jhlr/robo-challenge/docs/2026-11-06_ombro-sts3215.md

# Ombro com STS3215 direto, estrutura MDF (2026-11-06)

Sem reducao: o STS3215 (19,5 kg.cm) liga direto no pivo da barra de baixo do lado -x. Substitui MG996R + 4:1 (arquivado em `old/ombro_mg996r_4x1/`). Fontes: `cad/braco/sts3215.scad` (medidas), `ombro_sts.scad` (posicao do servo), `braco_mdf.scad` (pecas MDF).

## Estrutura (mais firme que a chapa unica antiga)
1. Corpo do servo (45,22 x 24,72 x 35) deitado: eixo em x, comprimento ao longo de y (de -35,11 a +10,11), largura em z. Fica fora das barras.
2. 2 quadros iguais (`stsframe`, YZ) com janela fechada no corpo: um rente a face do disco, outro rente a face de tras. O servo entra por tras pelas duas janelas e fica preso nos dois pontos (antes: 1 chapa de 2,3 mm).
3. 1 tampo (`stsshelf`, XY) une os 2 quadros por cima; as pontas passam por rasgos fechados. Quadro + quadro + tampo + prato formam um anel rigido.
4. Cada quadro tem 2 pes (12 mm, a ~41 mm um do outro) em janelas fechadas do prato. Prato estendido para tras em todo o x (de -53 a 20, ate y = -60); os 6 furos M3 do convés nao mudaram.
5. Barra do ombro (`bar_sts`): pivo alargado (22 mm), furo central de 8 mm (cabeca do parafuso do eixo), 4 furos M3 no circulo de 14 mm. As outras 3 barras sao as normais; sem furos de pino de setor.

## Verificado (OpenSCAD, poses pick/mid/place)
1. Barras x quadros/servo/tampo: sem interferencia.
2. Servo + quadros + tampo x chassi: so contato plano em z = 68 (pes no prato), sem colisao.
3. Encaixe real no disco NAO testado (medidas do disco vem da medida do usuario + desenho Waveshare).

## Reforco das torres e parafusos (2026-11-06, depois do primeiro desenho)
1. Torre com base alargada (trapezio de +-20 mm no prato ate +-12 mm a 30 mm de altura) e 3 pes no prato (antes 1).
2. Tampo das torres (`towertop`): liga as duas no topo, pontas em rasgos fechados, 1,5 mm abaixo do topo (acima do parafuso do pivo de cima).
3. Escora (`stsbrace`, XZ, y = -15,5): uma chapa de 41 mm que passa por rasgos fechados no quadro de tras, no quadro da frente e na torre -x, por baixo do servo. Amarra servo e torre.
4. Parafusos, posicoes escolhidas:
   - Conves (furar o conves do carro; hoje 6 furos M3, agora 9): +3 em (-50,5; -56), (-16,5; -19) e (-16,5; 19). Os de x = -16,5 ficam ao lado do pe da torre -x e da fileira de tras.
   - 2 furos M3 em cada quadro do servo (y = -39,1 e 14,1, z = eixo): espacador M3 femea-femea de 30 mm entre os quadros, parafuso M3 x 6 de cada lado. Fecha o servo num caixote rigido. Ficam do lado de fora, longe das barras.
   - Barra no disco: 4 M3 fresados (como antes).
   - Nao coloquei parafuso passante entre as torres: as cabecas/porcas ficariam na faixa de giro das barras (|x| = 13,9 a 16,2).
   - Furos nas abas do MDF nao seguram (aba rente, 2,3 mm); por isso os parafusos so atravessam placas inteiras.
5. Verificado: barras x (prato, torres, quadros, servo, escora, tampo): so contato plano barra-disco (x = -16,15). Conjunto x chassi: so contato plano do prato em z = 68 (pose pick; a pose place nao terminou, mesma geometria nos outros).

## Servo dentro da torre (2026-11-06, terceira rodada)
A torre -x e o quadro da frente do servo viram UMA placa (`towerframe`): janela fechada no corpo do STS3215 + sobe ate o furo do pivo de cima (so o pivo de cima; o de baixo e o proprio servo). Sai a escora de torre separada: `stsframe` (quadro de tras) fica x1.
1. Ordem em x agora, no lado -x: corpo do servo atravessa a placa-torre, disco (1,1 mm), barra, ... torre +x, barra +x.
2. Fundo (`back`) vai ate a placa-torre, com recorte onde passa o pivo alargado da barra (so ficam as faixas abaixo e acima dele); abas em z = 72,3-79,3 e 114,3-123,3.
3. Tampo das torres (`towertop`) desceu para z = 125,5: a barra de cima passa a 129,2 mm (alpha = -16, y = 9), mais alto que isso batia na pose place. Tampo do servo (`stsshelf`) liga placa-torre e quadro de tras.
4. Escora baixa passa por rasgos nos 3 (quadro de tras, placa-torre, torre +x).
5. Verificado: barras x estrutura nas 3 poses, so contato plano barra-disco. Conjunto x chassi: ver commit.

## Encaixe servo-barra (visualizacao)
Cena `view_encaixe` (`-D expl=18` afasta a barra): barra real do ombro (2D com furos) sobre o disco, 4 M3 fresados x 5 mm no circulo de 14 e furo central de 8 mm para a cabeca do parafuso do eixo. M3 x 5 = 2,3 de MDF + ~2,7 dentro do disco: so serve se a rosca do disco tiver pelo menos 2,7 mm. MEDIR a profundidade da rosca antes de comprar os parafusos.

## Pendencias (medir / decidir)
1. Parafusos da barra no disco: M3 FRESADOS (cabeca chata), 8 mm. A barra fica a 0,7 mm da torre, cabeca redonda nao cabe. O fresamento (cone) nao sai no corte a laser: fazer a mao. Profundidade da rosca no disco: medir antes de escolher o comprimento.
2. Saliencia do disco sobre a face (`sts_disc_prot` = 1,125, do desenho): medir. Muda o x do servo.
3. Cabeca do parafuso do eixo (`sts_center_d` = 8): medir.
4. Servo nao tem trava axial propria: segurado pela barra (parafusada no disco, barra presa nas torres). Se quiser trava, 2 parafusos M2 nos furos do corpo (padrao nao mapeado).
5. Firmware: `shoulder_ratio` = 4 em `params.json` e o PWM do ombro (`firmware/src/hal/shoulder.cpp`) ainda assumem o servo antigo; STS3215 e servo de barramento. Nao mexido.
6. Chapa do ombro regenerada (`mdf/sheet_ombro_1.*`, 1 chapa, 33% ocupada); o DXF do `bar_sts` esta em `mdf/parts/bar_sts.dxf`.
