jhlr/robo-challenge/docs/2026-11-06_sts3215-disco.md

# STS3215: disco de metal (horn) para a engrenagem da garra

Fonte: desenho 2D oficial da Waveshare (ST3215-2D.zip, `ST3215.dxf`/`.pdf`; https://www.waveshare.com/wiki/ST3215_Servo). Valores lidos do DXF; nao medidos no disco fisico.

1. Disco: 19,2 mm no desenho; MEDIDO no real (2026-11-06): 20 mm.
2. 4 furos em cruz, circulo de 14 mm (centro a furo 7 mm, medido, igual ao desenho); furo MEDIDO 3 mm (desenho: 2,5).
3. Furo central 3,2 mm (parafuso M3 do eixo); cubo/estria 25T, diametro do eixo ~5,9 mm.
4. Corpo do servo: 45,22 x 24,72 mm, altura 35 mm; eixo a 18,41 mm de uma ponta, 10,11 mm do lado maior.
5. Pendente (medir com paquimetro): espessura do disco e altura do cubo acima do corpo (desenho sugere ~2 mm, nao cotado).

Reuso: mesmo conceito do pinhao do ombro (`old/ombro_sg90_berco/ombro_reducao.scad`): flange atras dos dentes encostada no disco + pinos nos furos + parafuso central. Aqui: 4 pinos de ~2,3 mm no circulo de 14 mm.
