jhlr/robo-challenge/docs/2026-10-29_simulador-lote.md

# Simulador em lote (multiplas sementes) — 2026-10-29

Uma partida so do simulador e caotica: uma mudanca boa pode piorar a partida que estava sendo olhada. Para medir, `--lote N` roda a missao so com o nosso robo em N sorteios
(cubos e ruido mudam com a semente) e `--lote-ruido N` o mesmo com o ruido aleatorio ligado.

```
cd firmware/SeguidorRC
g++ -std=c++17 -O2 -Isrc -I../src -pthread test/simulador.cpp src/seguidor/decisao.cpp -o /tmp/sim
/tmp/sim --lote 12            # sem ruido; SIM_SO=4 roda so a semente 4 (use com SIM_DEBUG=1 para ver os eventos)
/tmp/sim --lote-ruido 12
```

Cada linha: se chegou a meta (2 entregas), entregas, pontos, toques em cubos (regras: -5 cada) e tempo. O resumo traz a media.

## Medidas (12 sementes, sem ruido, `--lote 12`)
| momento | chegam a meta | toques em cubos / partida | tempo medio |
|---|---|---|---|
| antes de corrigir a entrada na cidade depois da entrega | 2 de 12 | 1,6 | 529 s |
| compensando a partida em deslocamentos curtos | 6 de 12 | 1,9 | 415 s |
| cubo perto do cruzamento: depois da meia-volta replaneja no cruzamento | 7 de 12 | 0,7 | 387 s |
| atravessa a faixa azul em frente ate achar a rua | 8 de 12 | 1,0 | 332 s |
| olhar adiante so para o lado da linha (nao para o quarteirao) | 8 de 12 | 0,8 | 321 s |

Com ruido aleatorio (`--lote-ruido 12`, ruido propositalmente alto): 0 de 12.

## O que ainda falha (sem ruido)
- 4 de 12 sementes terminam com 1 entrega em 601 s (presas depois da 1a entrega ou ancorando).
- Ancorar com a linha desconhecida assume a linha 0; a correcao do nucleo (`core::planAtCrossing` vai a outra moldura quando a rua esta bloqueada) ainda nao e usada pela
  logica propria de ANCORAR do simulador (`Navegador::aoCruzamento`). Virar o sentido ali simplesmente piorou, entao nao foi aplicado.

## Atualizacao 2026-10-29 (tarde): mapa de rua de 40 cm e varredura parada das plataformas

- Mapa: passo 400 mm, becos 168 mm, ecoponto 291 mm, verde 371 mm (becos/ecoponto/verde: medidas da imagem na escala 400/302; so o passo veio de medida do usuario). Lote de 12 sementes sem ruido: 12 de 12 na meta, 259 s.
- Plataformas: o carro vai ao meio do mapa, chega a ~170 mm da face e varre -36..+36 graus com o ultrassom (Pitagoras: face = alcance x cos; centro de cada trecho com eco = distancia x tan do meio do trecho). A 250 mm o cone (+-10) fechava o vao de 100 mm. So a primeira entrega sobe ao topo (unica medida de velocidade em reta com distancia conhecida).
- Cubos: memoria do eco (um eco perto que some por causa do balanco do carro vale como "eco menos o que andou"; se o carro esta torto, realinha com a rua e le de novo). Toques em cubos: 2,0 -> 0,2 por partida.
- Varredura nos cruzamentos: com pose segura e cruzamento esperado, so gira para o lado cuja rua ainda nao foi medida (as duas medidas: nao gira; so uma: gira uma vez). 30 sementes: 25/30 na meta nos dois casos, 283 s contra 288 s.
- Falhas que restam (~5 em 30): o carro carregando fica preso num falso alarme no mesmo ponto (ex. semente 11, (1474, 230)); nao investigado.

## Rodada de otimizacao (30 sementes sem ruido)

| Mudanca | Na meta | Tempo medio |
|---|---|---|
| Antes (varredura so da rua nao medida) | 25/30 | 283 s |
| Rua bloqueada = a que o carro vai usar de fato (antes marcava sempre a do oeste); rota pelas ruas livres ate a coluna 0 | 26/30 | 277 s |
| ANCORAR com cubos nos dois sentidos da coluna: anda uma coluna ao leste | 27/30 | 266 s |
| Volta ao portao com a linha conhecida: `core::onOwnBlueAtRow` (pose segura logo na entrada, sem sweeps nem ANCORAR) | 27/30 | **207 s** |

Tentado e DESFEITO: (a) marcar toda plataforma lida como olhada (`yOlhados`): 23/30; (b) corrigir o rumo do giroscopio pelo plano da face das plataformas (ajuste do delta por minimos quadrados, fases 1 e 2): o delta sai certo (-22 contra -27 verdadeiro) mas o erro volta a crescer depois (vies do giroscopio + curvas fora das linhas), nao fechou o lote com ruido (0/12) e piorou o lote limpo (26/30). Com ruido o problema e ancorar o rumo ENQUANTO ha so parede (ecoponto e verde), sem linha para corrigir.
Falhas que restam (3/30): carro perde a linha ao reentrar pelo portao 40 mm abaixo da rua (deslocamento por tempo) e fica na faixa azul.

## Reentrada pelo portao (30 sementes sem ruido)

Causa das falhas: o carro voltava do ecoponto ~40 mm abaixo da rua (fora da barra de 75 mm), e a busca seguia a faixa azul como se fosse rua. A origem era a compensacao de partida da entrada (`entrarNaCidade`): 40 mm, medida com o mapa de 302 mm; com o y da plataforma ja na grade ela passava do ponto.

| Compensacao | Na meta (30) | Na meta (60) | Tempo medio (30) |
|---|---|---|---|
| 40 mm (antes) | 27/30 | 54/60 | 207 s |
| 20 mm (agora) | **29/30** | 57/60 | **174 s** |
| 0 mm | 29/30 | 57/60 | 175 s |

Tentado e desfeito: so contar como rua o preto que aparece 300 ms depois de o TCS deixar de ver azul (a faixa tambem acende a barra): 26/30. Falha que resta: semente 17 (carro termina fora do mapa, pose perdida; nao investigado). Lote com ruido continua em 0/12.

## Modo ruido pela metade (`kEscalaRuido = 0.5`, 30 sementes)

Dono unico da intensidade: `kEscalaRuido` em `test/simulador.cpp` (1,0 = original). Metade da frequencia (intervalos x2), da duracao e do desvio de cada evento (assimetria fixa 1,5 a 5%, patinagem, motor fraco, bateria, vies do giroscopio, solavanco, atraso e sensor preso, eco do ultrassom, erro do TCS). Sem ruido: 29/30, 174 s (inalterado).

Resultado com ruido: **0/30 na meta**. Isolando cada fonte (`SIM_SEM_RUIDO=<mascara de bits 0..9>`, `SIM_SEM_ASSIM=1`):

| Configuracao | Na meta | Tempo medio |
|---|---|---|
| Ruido pela metade (tudo) | 0/30 | 602 s |
| Tudo menos a ASSIMETRIA FIXA dos motores | **18/30** | 349 s |
| So a assimetria fixa (resto desligado) | 0/30 | 603 s |
| Sem qualquer uma das outras 9 fontes (uma por vez) | 0/30 | 601 s |

Conclusao: a unica fonte que derruba o carro e a assimetria fixa dos motores (diferenca de 1,5 a 5% entre os lados), e sozinha ja basta. Sinal no log: o rumo real fica 14 a 37 graus fora do rumo do giroscopio dentro do ecoponto (LOOK th 166, 158, 151 em vez de 180). Na pista, com linha, ele corrige; fora dela (verde e ecoponto) nao. Motores TT amarelos reais costumam diferir 5 a 10%, entao e o ponto a medir no carro.

## Assimetria dos motores: o giroscopio mede, o lado fraco ganha forca (30 sementes)

`seguidor/assimetria.h` (pura): no verde, parado, 3 rodadas curtas (~150 mm) alternando re e frente com o MESMO PWM nos dois lados. O giroscopio da o giro w em reta e, como w = (vD - vE)/bitola, a razao das forcas sai de vD/vE = (v + w*b/2)/(v - w*b/2); a compensacao SOBE o lado fraco (o forte fica em 1). As rodadas seguintes partem do ganho da anterior e fecham o que a derrapagem das rodas "comeu". `ponte_h` ganhou `definirCompensacao` (ganho por lado, limitado a 255); no simulador e `Carro::compensar`. O exemplo `SeguidorBasico` chama no setup (`kCompensarAssimetria`).

| Modo | Na meta (30) | Tempo medio |
|---|---|---|
| Sem ruido, antes | 29/30 | 174 s |
| Sem ruido, com a calibracao | 28/30 | 187 s |
| Ruido pela metade, antes | 0/30 | 602 s |
| Ruido pela metade, com a calibracao | **19/30** | 331 s |

Guarda: `cenarioAssimetria` (+4% e -7%): desvio de rumo numa reta de 2 s cai de 6,1 / -10,6 graus para 0,6 / 0,1; ganho do lado fraco x1,044 (real x1,041) e x1,076 (real x1,073). Visto VERMELHO: sem a calibracao os 2 casos falham (59/61).

Tentado e REMOVIDO (barra de 8 sensores): integrador lento no erro medio da linha em retas (linha a direita do centro = o carro vai para a esquerda = sobe a esquerda). Com ki alto (4e-5/ms) derrubou o lote limpo (5/30); com ki baixo (1e-6/ms) ficou igual a sem trim; sozinho, com ruido, 0/30: o desvio acontece fora da linha (verde e ecoponto), onde a barra nao ve nada, e a convergencia leva um minuto de reta. A barra serve para VERIFICAR a compensacao, nao para descobri-la: fica como ideia (medir o erro medio da linha na 1a rua e avisar se sobrou > 1 sensor).
