jhlr/robo-challenge/docs/2026-10-22_ombro-mg996r.md

> **DESCARTADO em 2026-10-22 (mesmo dia):** o usuario concluiu que o TowerPro nao aguenta direto no pivo; voltamos ao SG90/MG90S com reducao 4:1. Arquivos do MG996R em `old/ombro_mg996r_direto/`.

# Ombro com MG996R direto no pivo (2026-10-22)

Substitui o ombro SG90 4:1 de `2026-10-20_braco-opcao2.md` (item 1 das decisoes). Pedido do usuario: servo do ombro passa a ser um TowerPro MG996R.

## O que mudou
- Sem reducao: o horn do MG996R vai aparafusado na face de fora da barra de baixo do lado -x (M2,5 a 8 e 16 mm do pivo, 4 barras iguais), M3 do eixo entra por dentro pelo furo de pivo. Fonte: `cad/braco/ombro_direto.scad` (substitui `ombro_reducao.scad`, movido para a lixeira junto com `part_sr_*.stl`).
- Torque: ~10 kg.cm (6 V) contra 4,2 necessarios = 2,4x de folga.
- MDF: prato volta a 73 x 44 mm (sem a extensao para tras), some bochechas e prateleira, entra a chapa do servo `d_servoplate` (YZ, janela fechada 41,3 x 20,3 para o corpo, 4 furos M4 das orelhas, 2 abas em janelas fechadas do prato). Folha: `cad/braco/mdf/sheet_ombro_1.dxf` (prato, chapa do servo, 4 barras).
- Firmware: `kShoulderRatio 1`, sinal +1, centro 90 graus; angulos do braco -16 / -9,8 / +25,5 = servo 74 / 80 / 115,5 graus. Sinal +1 e suposicao (flip se o braco andar ao contrario).

## Verificado no 3D (`chk_sh_*` em `braco_mdf.scad`)
- Sem colisao com o chassi (`chk_sh_chassis`); conjunto inteiro so toca o convés em z = 68 (face do prato).
- Chapa x orelhas: so contato plano; servo x barras/carrier: so 0,05 mm de contato horn-barra (dummy da barra tem 3 mm, MDF tem 2,3).

## Pendencias / riscos
1. Medidas do MG996R sao de catalogo, MEDIR: altura total 42,9, eixo a 10,3 mm da ponta, orelhas a 14 mm abaixo do topo do eixo, furos 49,5 x 10 mm, furos do horn de 2 bracos (`sh_horn_y`).
2. O corpo sai ate x = -62,4, ~15 mm alem da lateral do chassi (-47): conferir contra a regra de 300 x 300 mm e contra as rodas.
3. Chapa do servo em pe so nas 2 abas do prato: pode balancar; se sim, colar ou adicionar escora.
4. Alimentar o MG996R por fonte propria de 5-6 V (stall ~2,5 A), GND comum com o ESP32.

---
## Atualizacao (mesmo dia): ombro 4:1 com pinhao parafusado no horn redondo
O usuario tem o horn redondo de 20 mm do servo (disco com coroa de furinhos). O pinhao deixa de ter bolso estriado: ganha flange de 22 mm x 2 que encosta no horn, 3 pinos impressos de 1,1 mm entram na coroa (a cada 4 furos, supondo 12) e o M2 do eixo prende. Fonte: `cad/braco/ombro_reducao.scad` (`sr_horn_*`, `sr_hz_*`, `sr_peg_*`, `sr_fl_*`), STL `cad/braco/stl/part_sr_pinion.stl` refeito (reimprimir).
- Servo recuou 4,5 mm em x (flange + horn entre ele e as engrenagens): `sr_sv_top` = -25,15. Berco de MDF refeito: `m_cx` = [-48,5; -25,6], abas em [-47,5; -40] e [-34; -27]; a prateleira acaba antes do horn (o disco de 20 mm passaria por dentro dela). `sheet_ombro_1.dxf` regerado (cortar de novo prato, bochechas, prateleira).
- Checagens `chk_sr_*` (alpha -16 e +25,5): sem colisao com chassi e carrier; mount e conjunto so contato plano.
- MEDIR no horn: espessura total, numero de furos da coroa, raio e diametro dos furos, altura do cubo central (valores atuais vem de foto, +-0,5 mm).

### Medidas finais do horn (2026-10-22, usuario)
Disco 20 x 2 mm, cubo central de 3 mm virado para o SERVO (total 5 mm, face do disco virada para o pinhao e plana), Ø do cubo 8 mm (aprovado), 4 furos a 8 mm do centro, a 90 graus, usados com 4 pinos impressos de 1,1 mm; os furos de 7 mm e os demais ficam sem uso. Servo recuado: `sr_sv_top` = -27,15; berco: `m_cx` = [-48,5; -27,55], abas [-47,5; -40] e [-37; -30]. `chk_sr_*` limpos; `part_sr_pinion.stl` e `sheet_ombro_1.dxf` regerados. Pendente: diametro real dos 4 furos do horn (pino de 1,1 mm).
