jhlr/robo-challenge/docs/2026-10-26_base-mg996r-4x1.md

# Base do ombro com MG996R + reducao 4:1 (2026-10-26)

Pedido: servo do ombro passa a ser o TowerPro MG996R (foto do usuario: chapa de MDF vertical, corpo do servo atras dela, horn redondo + pinhao impresso do lado do braco, engrazando no setor da barra). Substitui o berco do SG90 (prato + bochechas + prateleira); o que existia fica em `old/ombro_sg90_berco/`.

## O que mudou (fonte unica: `cad/braco/ombro_reducao.scad` e `cad/braco/braco_mdf.scad`)
- `ombro_reducao.scad`: parametros do servo agora sao do MG996R (`sr_sv_*`, `sr_ear_*`); a relacao 4:1 (z12/z48, m1,25, distancia entre eixos 37,5 mm) nao mudou.
- `braco_mdf.scad`: some `d_cheek`/`d_shelf`; entra `d_servoplate` (chapa YZ logo atras das orelhas, janela fechada 41,3 x 20,3 para o corpo, 4 furos M4 das orelhas, 2 abas em janelas fechadas do prato). `d_base` ganha a extensao para tras (`m_bext`) e as 2 janelas das abas, em x = `m_sp`. Grupo `ombro` do `mdf_nest.py` = prato + chapa + 4 barras (`cad/braco/mdf/sheet_ombro_1.dxf`, copia em `~/Desktop/corte_mdf/`).
- Arrumacao das aberturas do prato (desenho do usuario): torres (2 longas) + fundo (2 curtas) como antes; as 2 abas da chapa do servo ficam atras da torre, no eixo y do servo.
- Imagens: `docs/2026-10-26_base-mg996r-4x1.png` (folha), `docs/2026-10-26_ombro-mg996r-4x1_3d.png` (3D).

## Verificado
- DXF: contornos fechados, 0 pontos abertos (838 linhas).
- 3D: `chk_sr_chassis` vazio (sem colisao com o chassi); `chk_sr_mount` so contato plano (volume 0, face das orelhas x = -39,15).

## Pendencias / riscos
1. Medidas do MG996R sao de catalogo: MEDIR corpo (40,7 x 19,7), eixo a 10,3 mm da ponta, orelhas a 14 mm da ponta do eixo, eixo ~4,5 mm acima da tampa (`sr_sv_spl`, suposto), furos 49,5 x 10 mm.
2. O corpo (~38 mm de altura sem eixo) sai ate x ~ -65 mm do centro, alem do prato, por cima da roda: confira a folga da roda na montagem (o modelo diz sem colisao, mas as rodas do modelo sao aproximadas).
3. `mount_geom()` em `braco.scad` (peca impressa antiga) ainda tem o berco do SG90; nao e usado pelo MDF.
4. Torque: MG996R (~10 kg.cm a 6 V) x 4:1 = muita folga; alimentar por fonte propria de 5 a 6 V, GND comum. O pinhao/setor continuam os mesmos (horn de 20 mm).

## Atualizacao (2026-10-26, mesma sessao): servo atras da torre, reaproveitando a chapa ja cortada
Pedido: motor "exatamente atras da torre, nao lateralizado" e **reusar o suporte do motor que ja foi cortado** (a chapa do MG996R da folha antiga, em `old/ombro_mg996r_direto/`).
- Servo INVERTIDO: fica do lado de dentro, com o eixo apontando para fora (-x) e o corpo entre x = -8,7 e +29,7, atras das torres (y de -68 a -27). Antes ficava a x ate -65 (lateral). `sr_sv_top` = -8,65.
- O pinhao impresso e o mesmo STL, so montado virado (flange e pinos do lado de dentro, para o horn).
- Chapa: `d_servoplate` bate com a ja cortada (0,0 mm de desvio nos 112 segmentos; 60,4 x 42,8 mm; janela 41,3 x 20,3; abas de 12 mm a 24 mm). Para isso o eixo do servo ficou na altura do pivo (`sr_th` 165 -> 180, pz = 0): a janela da chapa ja cortada fixa a altura do eixo.
- Prato (`d_base`): extensao para tras (x de -25 a 20, ate y = -80,8), 2 janelas das abas da chapa em x = 3,4 a 5,7 (y de -58,5 a -46,5 e de -34,5 a -22,5), janela de passagem do canto do setor (x -20,4 a -15,4, y -23 a -18): com sr_th = 180 o setor entrava 0,7 mm no prato a alpha = +25,5. M3 do convés em (+-16,5, -56).
- Checagens: `chk_sr_mount` so contato plano (vol. 0) em pick e place; `chk_sr_chassis` vazio nas duas poses. `sheet_ombro_1.dxf`: 0 pontos abertos. NAO conferido: o desenho verde do usuario pedia as abas no x da torre direita (12); a chapa fica em x = 3,4 a 5,7.
- Firmware: o servo invertido espelha o sentido do ombro: provavel inverter `kShoulderSign` (testar `a -9.8`).
- Risco: o corpo passa de x = 20 (borda do prato) ate 29,7 no fundo; conferir o convés de cima nessa regiao.

## Pinhao estriado direto no eixo (2026-10-27)
Pedido: usar a `engrenagem_trilho` (feita por engano na conversa do plotter) como pinhao do ombro, sem o horn. `cad/braco/ombro_reducao.scad` (`sr_pinion_spline_local`, `sp_*`) e `cad/braco/stl/part_sr_pinion_spline.stl`: disco de base 24 + engrenagem + flange 20 formam o canal (7 mm) onde corre o setor (3,5 mm); cubo 10 x 7 com bolso estriado de 25 dentes (5,9 mm + 0,1 de folga por lado, 5 mm de fundo) e M3 de 3,4 mm pelo centro (rebaixo de 6,4 pela base). Dentes = os do pinhao z12 m1,25, entao mantem 37,5 mm entre eixos e a chapa ja cortada.
- A engrenagem original (z16, ponta reta) nao engrenava com o setor z48 m1,25.
- NAO integrado ao modelo: sem o horn o servo avanca ~2,8 mm (tampa a x ~ -5,9, em vez de -8,65); as janelas das abas da chapa no prato mudam de x quando integrar. Estria de catalogo: MEDIR diametro externo e de raiz no eixo real.
- Ajuste (2026-10-27): dentes externos mais gordos com o mesmo modulo (`sp_bl` = 0,05, antes 0,15; o setor continua com `sr_bl`, folga total entre dentes 0,2 mm, sem interferencia em alpha -16, -9,8, 0, 12 e 25,5) e entalhes da estria 0,2 mm mais fundos e mais largos (`sp_deep`, `sp_hw`). Folga de 0,2 mm entre dentes e apertada para FDM: se travar, subir `sp_bl`.
- Ajuste (2026-10-27): dentes do pinhao alongados 1 mm na ponta (pedido do usuario; ponta a 9,75 mm, invade ~0,69 mm a raiz do setor: raspar ao montar). A evolvente z12 se cruza alem de ~8,75 mm (gerava dentes em gravata e STL invalido): `cr_tooth` com `ext` > 0 mantem uma ponta de 0,6 mm de largura. Antes, com 0,2 mm (`sp_ext`; `cr_tooth` ganhou o parametro `ext`, default 0): ponta a 8,95 mm do centro, raiz do setor a 9,06 mm, folga radial 0,11 mm. Sem interferencia em alpha -16, -9,8, 0, 12 e 25,5. Mais que isso exige aprofundar a raiz do setor z48 (reimprimir).
- Ajuste (2026-10-27): estria FROUXA com folga +0,1 e entalhes largos/fundos. Agora `sp_clr` = -0,05 (errar para apertado), entalhes +0,05 / meia largura 0,20-0,15, cubo de 5 mm (antes 7; `sp_hub_h`, altura total 15,5). Teste de encaixe: `part_sr_spline_test.stl` (folgas -0,10 a 0,10, 1 a 5 marcas). Sem horn o servo avanca ~2,8 mm: com o cubo de 5 mm a tampa fica 2 mm mais perto do canal (a x ~ -7,9).
- Ajuste (2026-10-27): sem peca de teste (mesmo tempo de impressao do pinhao). Furo da estria 1 mm menor em diametro que a versao frouxa: `sp_clr` = -0,4, `sp_deep` 0,2, `sp_hw` 0,20/0,15 -> 5,5 mm nas pontas, 4,5 mm na raiz (eixo de catalogo 5,9): entra a forca, raspar. Dentes internos de ~0,2 mm: abaixo da largura do bico, o fatiador pode fechar o bolso num furo redondo.
