jhlr/robo-challenge/docs/2026-10-21_plotter-mcp.md

# Pen plotter (LLM -> MCP -> ESP32 -> servos), 2026-10-21

Code: `plotter/`. 2-link planar arm, 2 SG90 servos + 2 feedback pots, pencil in a clamp (no pen-up yet).

## Layout
- `plotter/firmware` (PlatformIO, esp32dev): line protocol `?`, `V`, `A s1 s2` (OK on arrival), `R`. Servos GPIO18/19, pots GPIO34/35. Builds clean.
- `plotter/server` (uv): `config.py` = geometry + calibration (single source), `kinematics.py` = IK/FK, `arm.py` = owner of the draw cycle, `server.py` = MCP tools (`page_info`, `move_to`, `draw_polyline`, `get_state`). `PENARM_PORT` unset = simulator.

## Run
    cd plotter/server && uv run pytest && PENARM_PORT=/dev/cu.usbserial-XXXX uv run penarm-mcp
MCP client entry: command `uv`, args `["--directory", ".../plotter/server", "run", "penarm-mcp"]`.

## TODO
1. Measure real link lengths, base position, page placement -> `config.py` (current values are placeholders).
2. Calibrate sign/offset per servo (servo angle vs real joint angle); then pot raw -> angle.
3. Pen lift (3rd servo) -> `pen_up`/`pen_down` tools. Stiffen link 2 (flexes).
4. Closed loop with pots; optional camera feedback loop.
