jhlr/robo-challenge/arquivo/plotter_pecas_soltas/LEIA-ME.txt

Pecas do plotter (suporte de lapis, base, elos) que estavam soltas em garra/. Pertencem ao projeto jhlr/plotter; aqui so como arquivo.
