jhlr/robo-challenge/docs/2026-10-30_ota-ble.md

# Atualizacao do firmware por Bluetooth (OTA BLE) — 2026-10-30

Codigo: `firmware/SeguidorRC/src/seguidor/ota_ble.h` (robo), `firmware/SeguidorRC/tools/ota_ble.py` (computador). Mesmo servidor BLE do console (`depuracao_ble.h` e dona do BLEDevice; `ble.servidor()` + `ble.anunciar()`).

## Usar
1. **Uma vez por USB** (tabela de particoes nova + primeiro firmware com OTA): `cd firmware && pio run -e seguidor -t upload`.
2. Depois: `cd firmware && pio run -e seguidor && ~/.venvs/seguidor/bin/python SeguidorRC/tools/ota_ble.py` (`--segredo`, `--nome`, ou um .bin).
   Robo parado, sem outro aparelho conectado (feche o `console_ble.py`). Precisa do bleak num venv (`python3 -m venv ~/.venvs/seguidor && ~/.venvs/seguidor/bin/pip install bleak`; o pip3 do sistema recusa por PEP 668) e de permissao de Bluetooth no Terminal.
3. O segredo e o `OTA_SEGREDO` do sketch (padrao `troque-este-segredo`: troque nos dois lados).

## Protocolo
Servico `9B2A0001-...`; controle `...0002` (escrita com resposta + notificacao), dados `...0003` (escrita sem resposta).
INICIAR = `0x01 | tamanho u32 | sha256 | HMAC-SHA256(segredo, tamanho||sha256)`; dados em pacotes de MTU-3, ACK cumulativo a cada 4 KB (controle de fluxo); FIM = `0x02` (confere o sha256 do que chegou, fecha a imagem, reinicia). O HMAC impede que um aparelho qualquer ao alcance grave firmware; sem dados por 10 s aborta e o robo volta a andar. Detalhes e codigos de erro no cabecalho de `ota_ble.h`.

## Decisoes
- BLE (Bluedroid) + sketch = 1,34 MB: nao cabe nos 1,25 MB do padrao, entao `board_build.partitions = min_spiffs.csv` (2 apps de 1,9 MB).
- Sem rollback: se um firmware travar ANTES do OTA subir, so por USB. Por isso `ble.iniciar` + `ota.iniciar` sao as primeiras linhas do `setup()`.
- Gravacao na tarefa do BLE (callback), nao no `loop()`: o loop do robo nao precisa servir a transferencia. O loop so reinicia e aborta por tempo.
- `depuracao_ble.h`: `iniciar()` nao anuncia mais; chame `anunciar()` depois de criar os servicos.

## Nao testado
Compila e a mensagem INICIAR confere com `openssl` (69 bytes, HMAC igual), mas **nunca rodou no robo**: o lado do ESP32 (HMAC via mbedtls, `Update`, ACKs) e o `bleak` em macOS so se provam na bancada. Primeiro teste sugerido: enviar o mesmo firmware, depois um com uma linha de `dbg.println` diferente.

## Pinos (reposicionados em 2026-10-30, fonte unica: `firmware/include/pins.h`)
STS bus 16/17 | I2C (PCA9548) SDA 21, SCL 23 | ultrassom trig 18, echo 19 | barra QRE-8D S1..S8 = 14, 27, 26, 25, 33, 32, 35, 34.
- **S7/S8 = GPIO35/34 sao SO DE ENTRADA**: a leitura RC precisa carregar o pino, entao esses dois nao reagem (a calibracao avisa e ignora; o minimo para andar e 6 sensores). Mover para pinos com saida (livres: 4, 13, 22) ou confirmar que a barra e digital.
- A barra agora le dois registradores (GPIO0-31 e 32-39), entao GPIO32/33 funcionam.
- `kClaw = 18` (bringup do braco) colide com o trig, `kBuzzer = 26` e `kLed = 27` com S3/S2: pins.h ainda nao foi reconciliado para o bringup.
- SDA/SCL: assumi SDA 21, SCL 23 (ordem da mensagem).
