jhlr/robo-challenge/arquivo/chassi_baixo_descartado/2026-10-24_chassi-baixo-topo.png

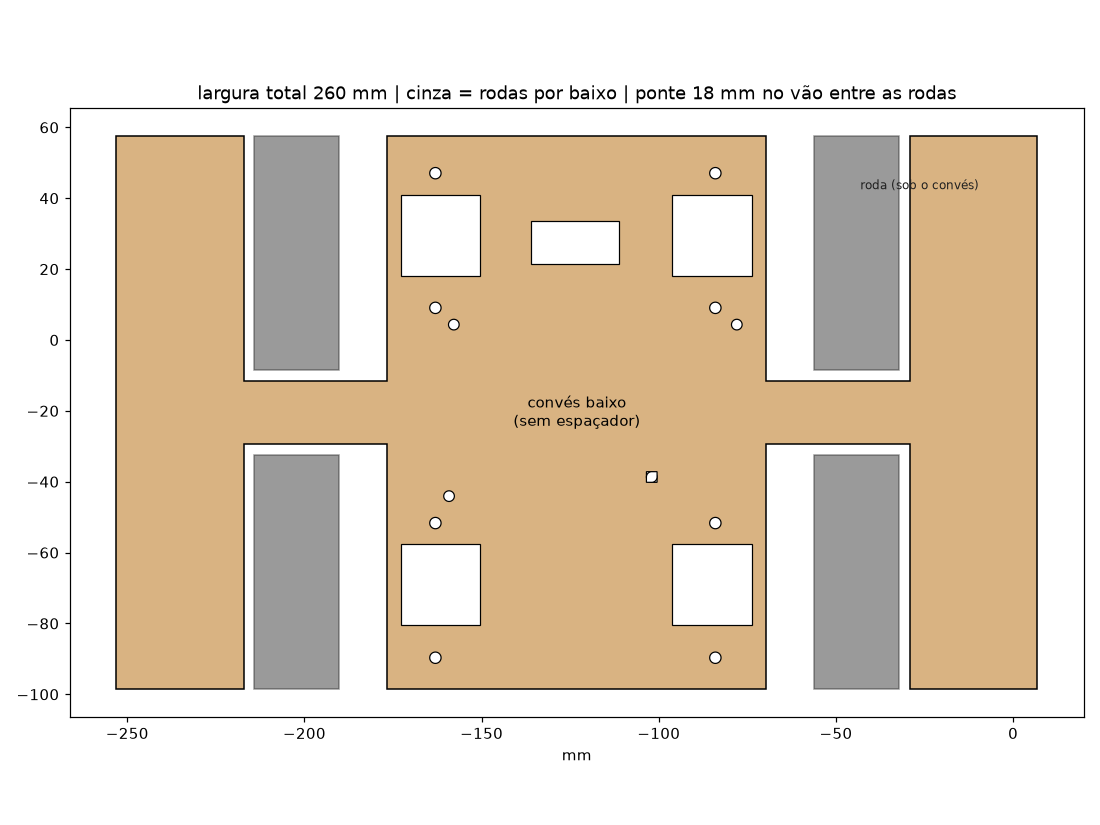
arquivo/chassi_baixo_descartado/2026-10-24_chassi-baixo-topo.png
