jhlr/robo-challenge/arquivo/ombro_mg996r_direto/2026-10-26_base-mg996r.png

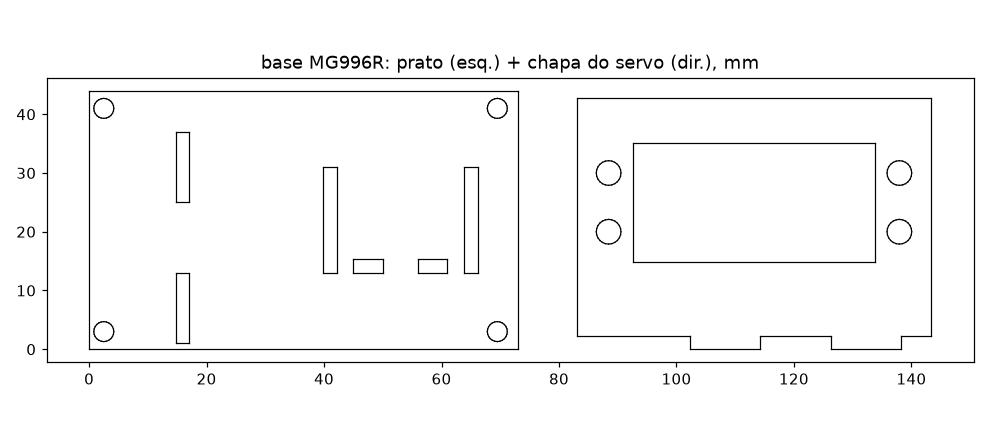
arquivo/ombro_mg996r_direto/2026-10-26_base-mg996r.png
