jhlr/robo-challenge/arquivo/plotter_pecas_soltas/pecas_separadas.png

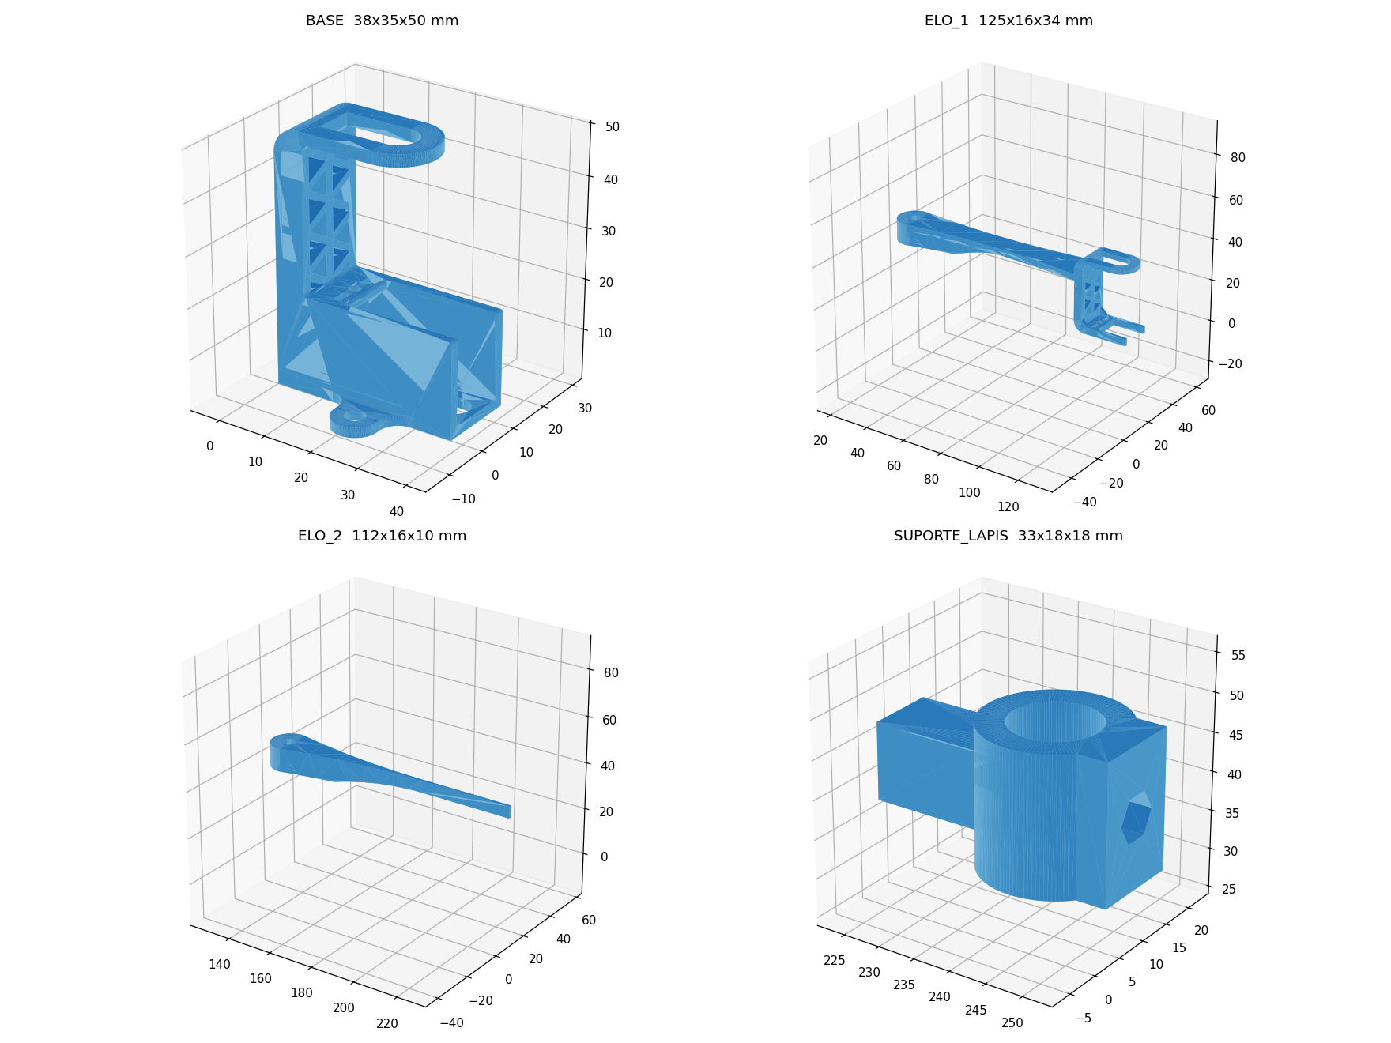
arquivo/plotter_pecas_soltas/pecas_separadas.png
