jhlr/robo-challenge/arquivo/suporte_conector_dupont/2026-10-22_suporte-conector.png

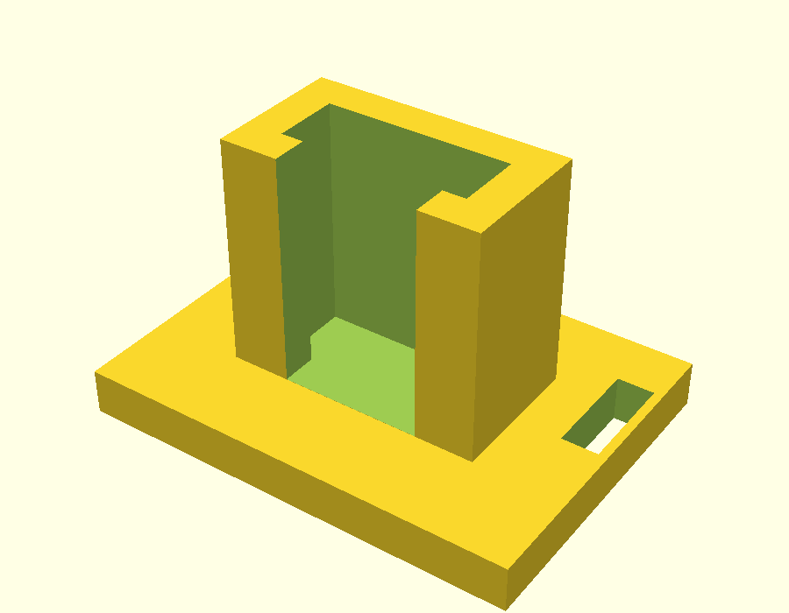
arquivo/suporte_conector_dupont/2026-10-22_suporte-conector.png
