jhlr/robo-challenge/cad/chassi/compare_after.png

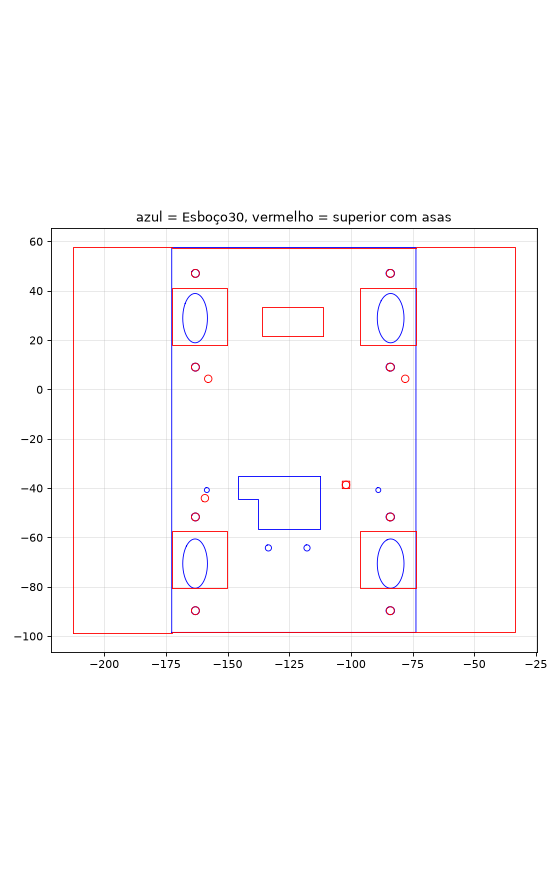
cad/chassi/compare_after.png
