jhlr/robo-challenge/cad/chassi/compare_before.png

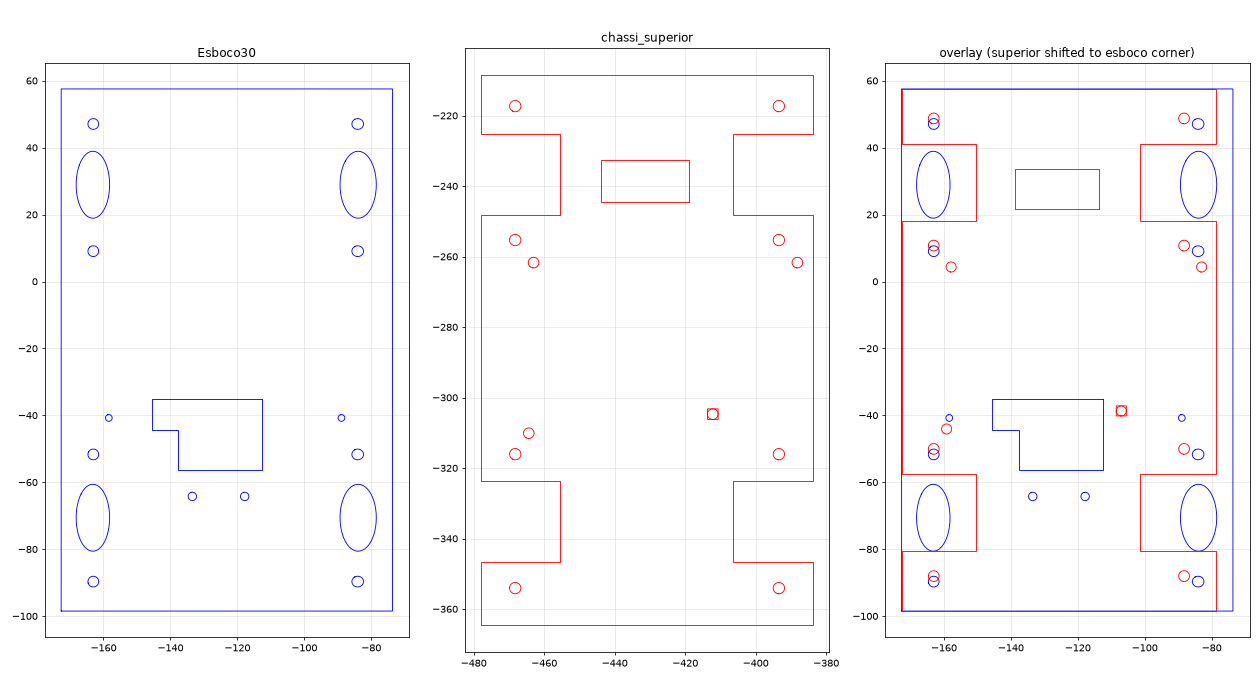
cad/chassi/compare_before.png
