jhlr/robo-challenge/cad/chassi/furo_inferior_antes_depois.png

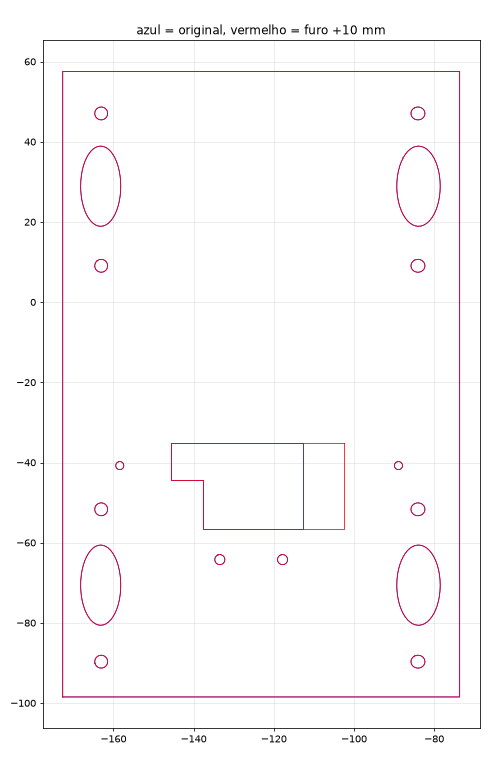
cad/chassi/furo_inferior_antes_depois.png
