jhlr/robo-challenge/cad/esp32_caixa/preview.png

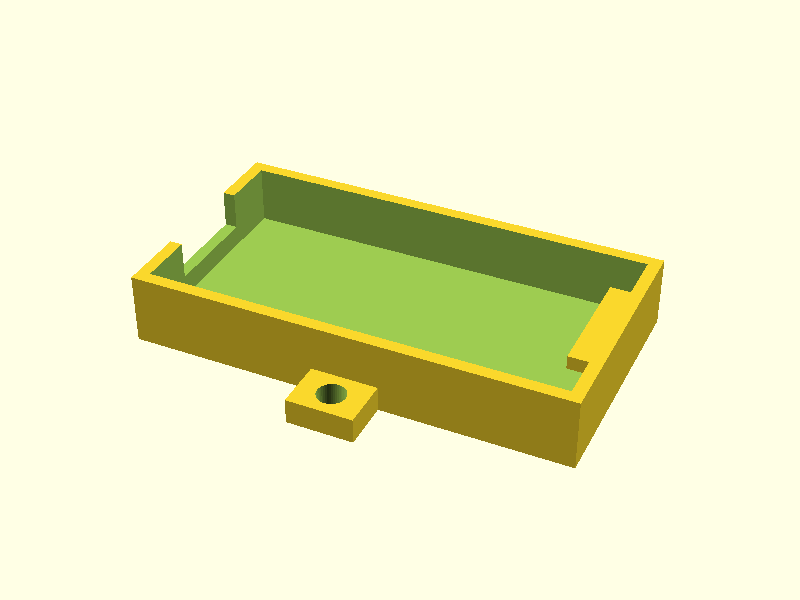
cad/esp32_caixa/preview.png
