jhlr/robo-challenge/cad/garra_sts/engrenagem_sts.png

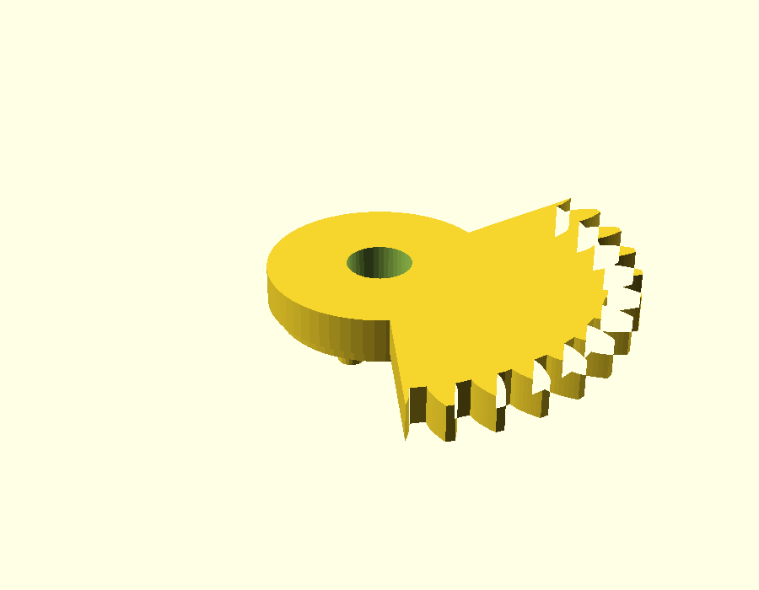
cad/garra_sts/engrenagem_sts.png
