jhlr/robo-challenge/cad/modelo_robo/preview_side.png

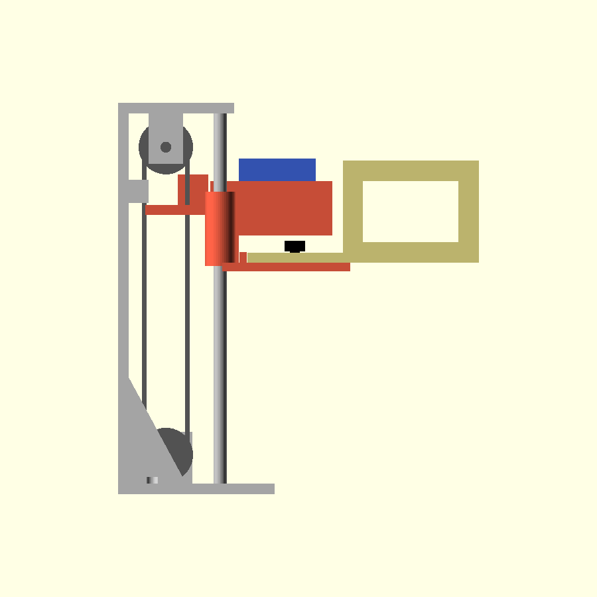
cad/modelo_robo/preview_side.png
