jhlr/robo-challenge/docs/2026-10-19_robo-completo.png

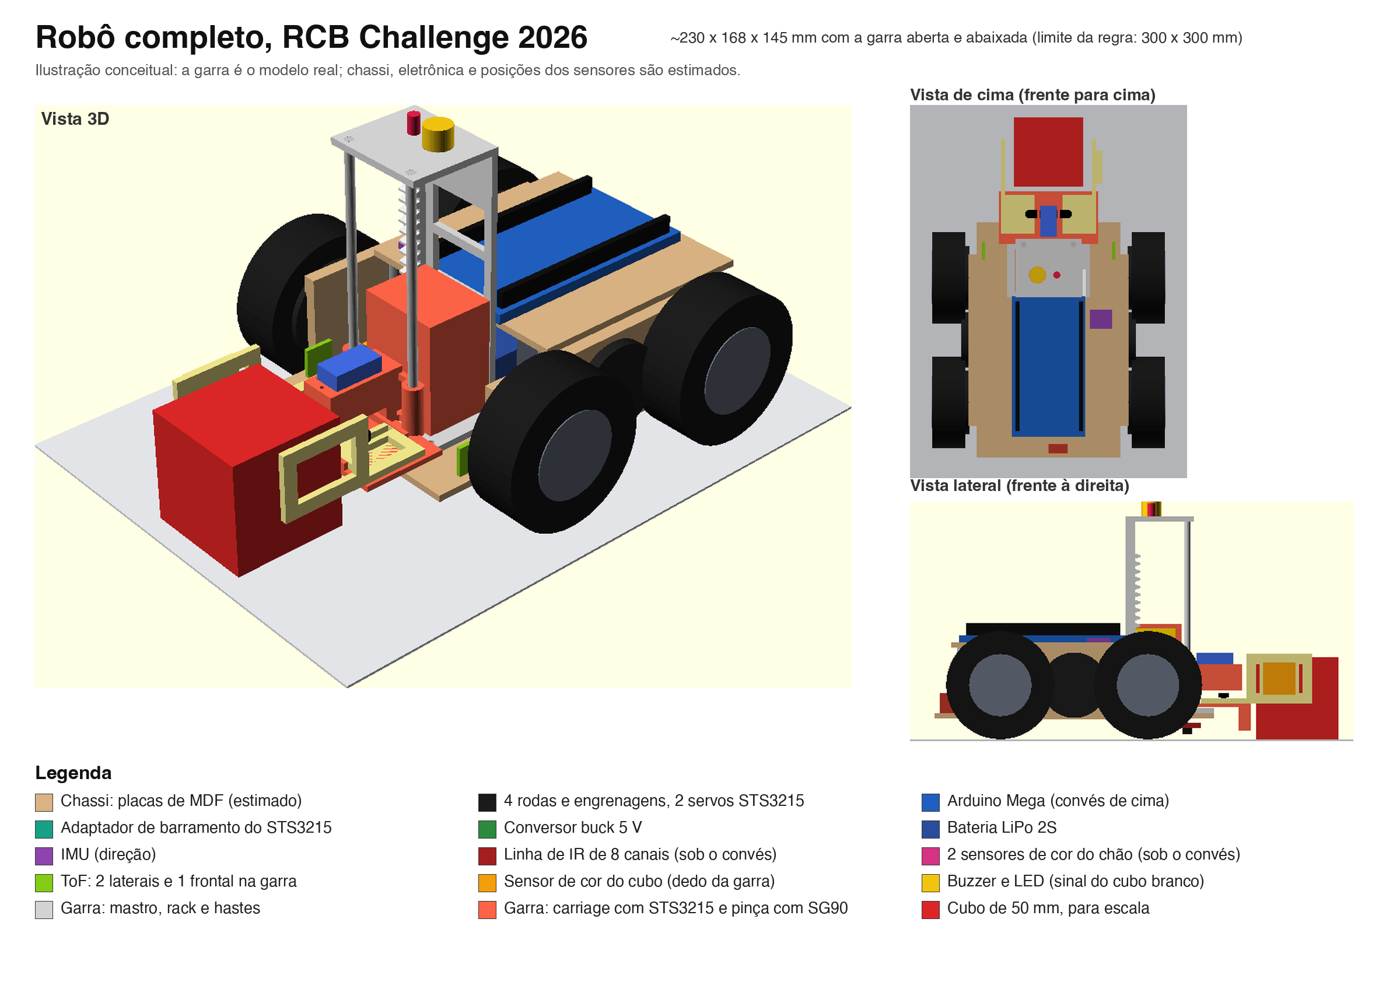
docs/2026-10-19_robo-completo.png
