jhlr/robo-challenge/docs/2026-10-20_braco-chassi-novo_pick.png

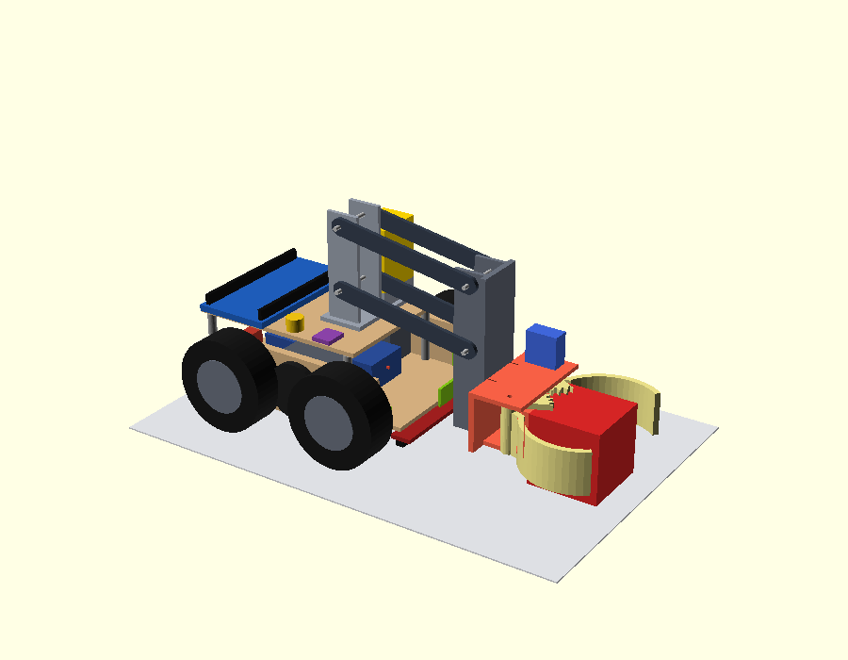
docs/2026-10-20_braco-chassi-novo_pick.png
