jhlr/robo-challenge/docs/2026-10-20_chassi-ultrassom.png

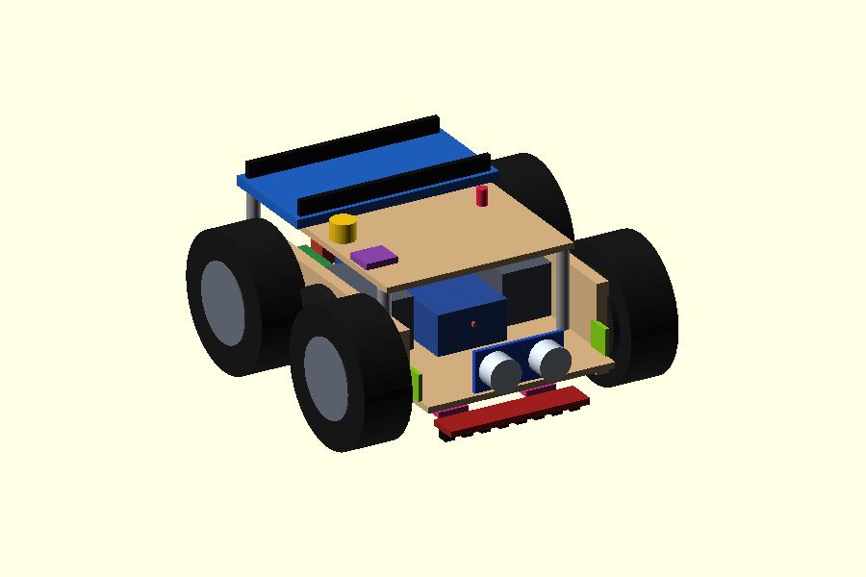
docs/2026-10-20_chassi-ultrassom.png
