jhlr/robo-challenge/docs/2026-10-20_moldura-mdf_montada.png

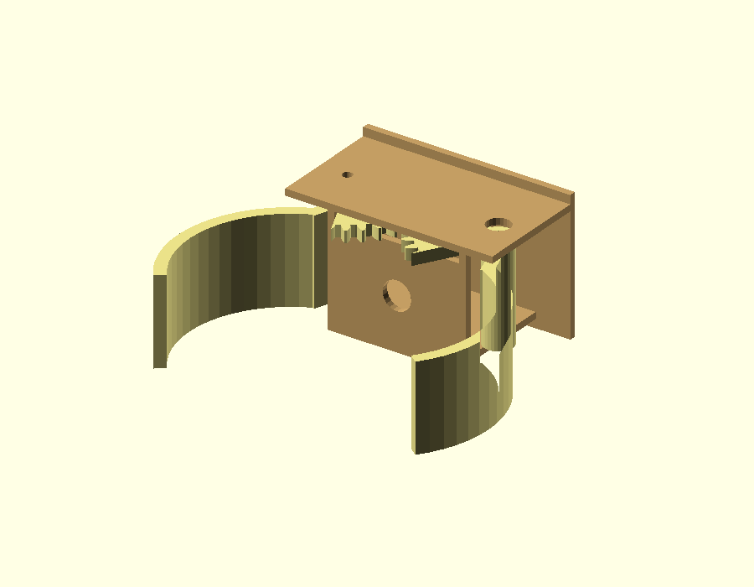
docs/2026-10-20_moldura-mdf_montada.png
