jhlr/robo-challenge/docs/2026-10-20_pecas-impressao-opcao2.png

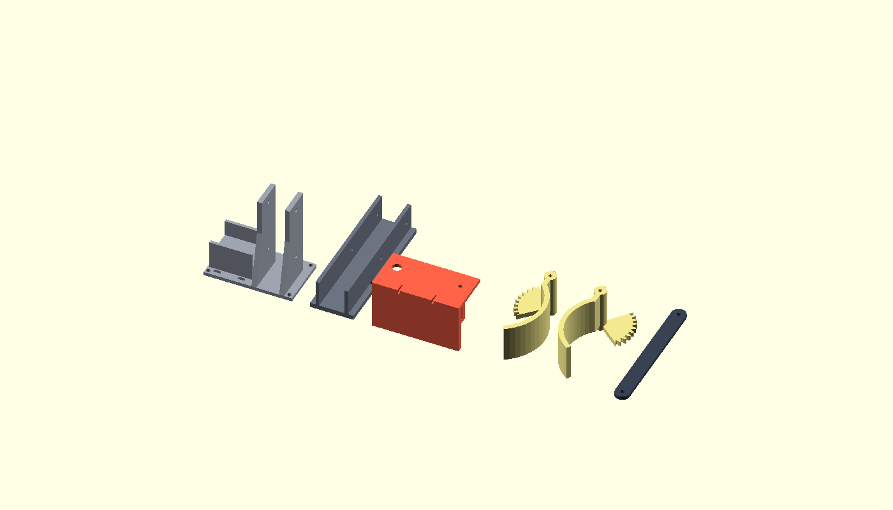
docs/2026-10-20_pecas-impressao-opcao2.png
