jhlr/robo-challenge/docs/2026-10-21_braco-movimento.gif

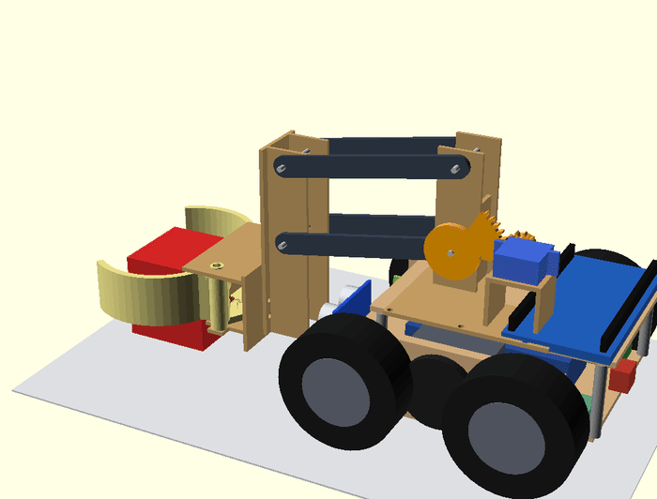
docs/2026-10-21_braco-movimento.gif
