jhlr/robo-challenge/docs/2026-10-21_corte-dentes-setor.png

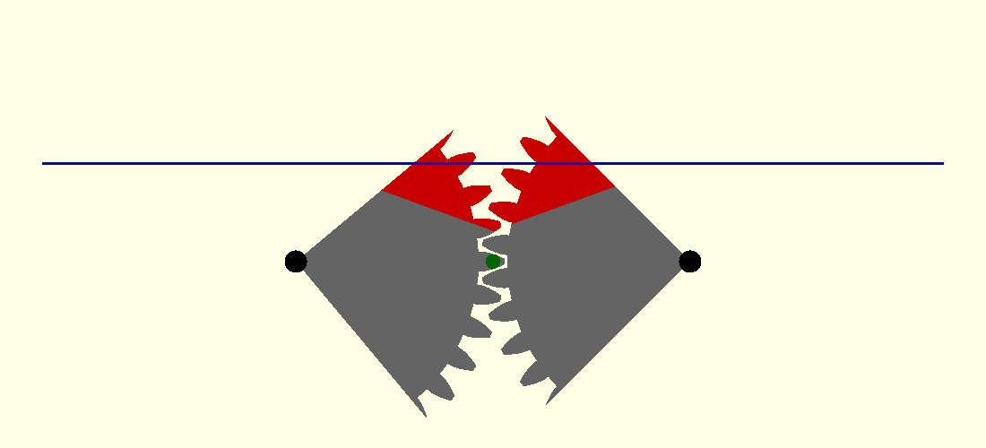
docs/2026-10-21_corte-dentes-setor.png
