jhlr/robo-challenge/docs/2026-10-21_ombro-sem-conflito-eletronica.png

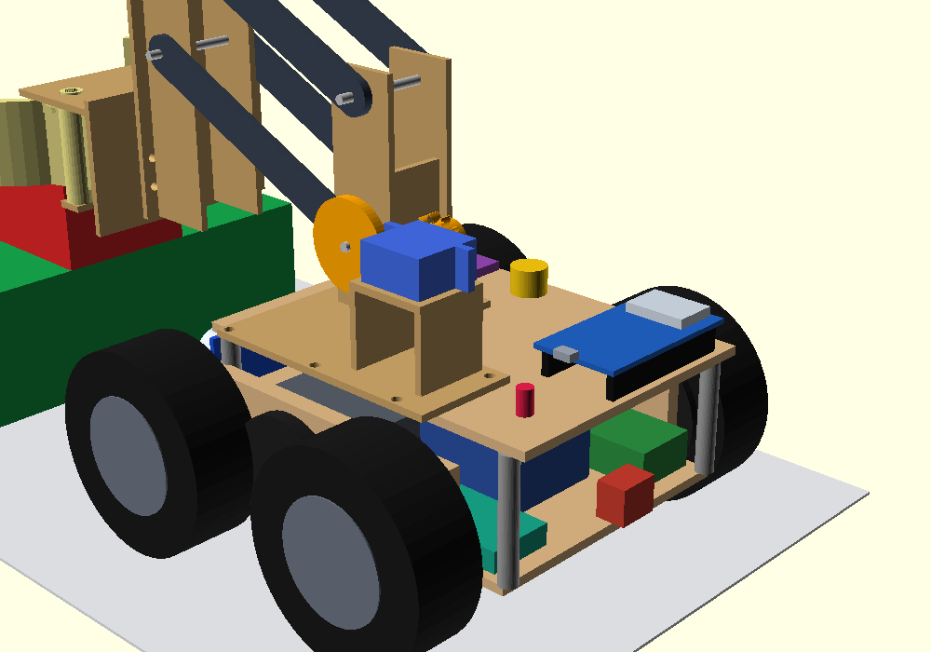
docs/2026-10-21_ombro-sem-conflito-eletronica.png
