jhlr/robo-challenge/docs/2026-10-22_chassi-asas_topo.png

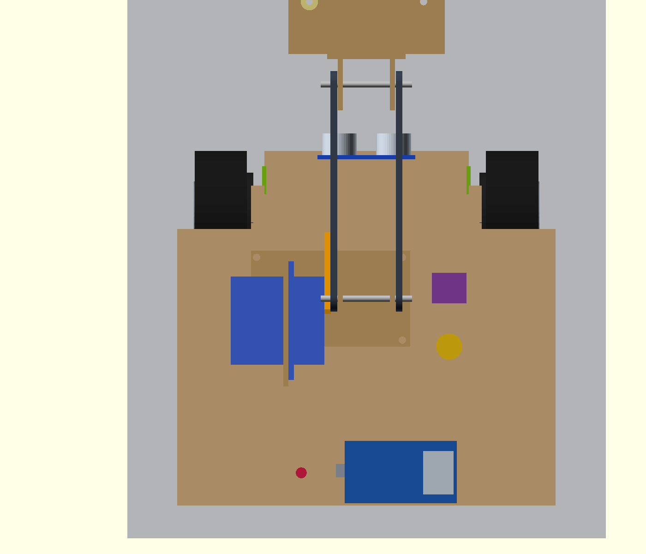
docs/2026-10-22_chassi-asas_topo.png
