jhlr/robo-challenge/docs/2026-10-22_extensor-eixo.png

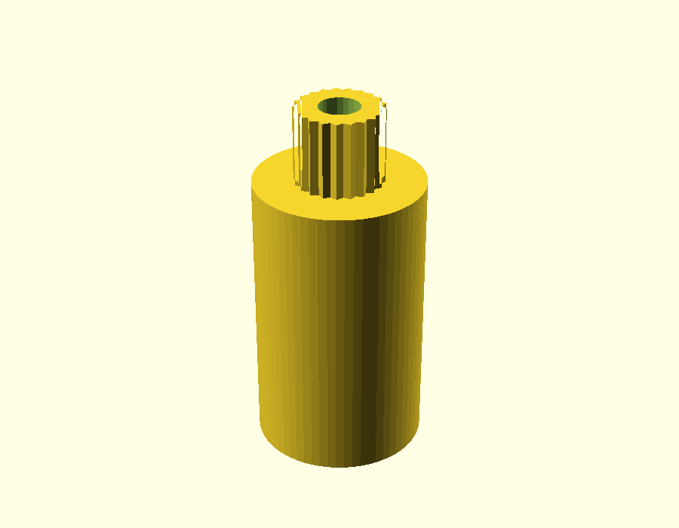
docs/2026-10-22_extensor-eixo.png
