jhlr/robo-challenge/docs/2026-10-22_ombro-mg996r_a_place.png

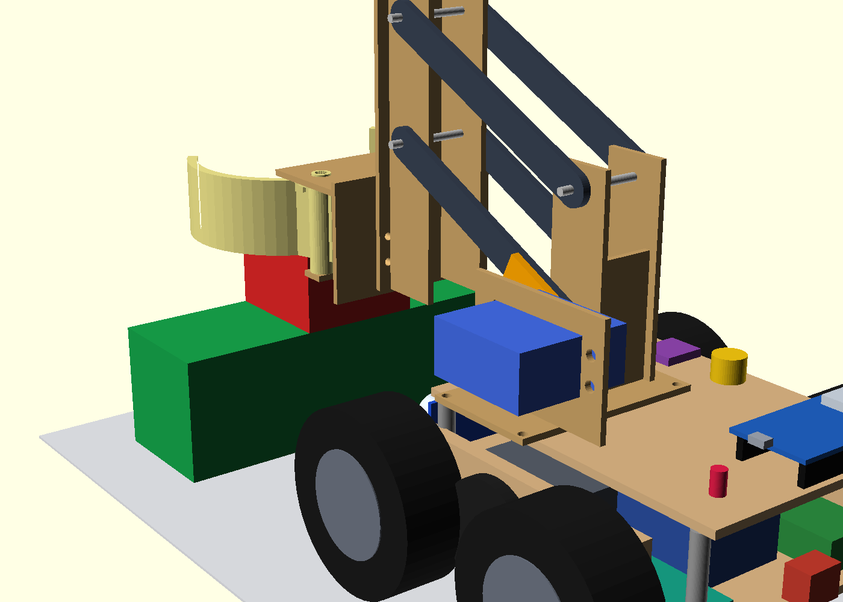
docs/2026-10-22_ombro-mg996r_a_place.png
