jhlr/robo-challenge/docs/2026-10-22_ombro-mg996r_c_pick.png

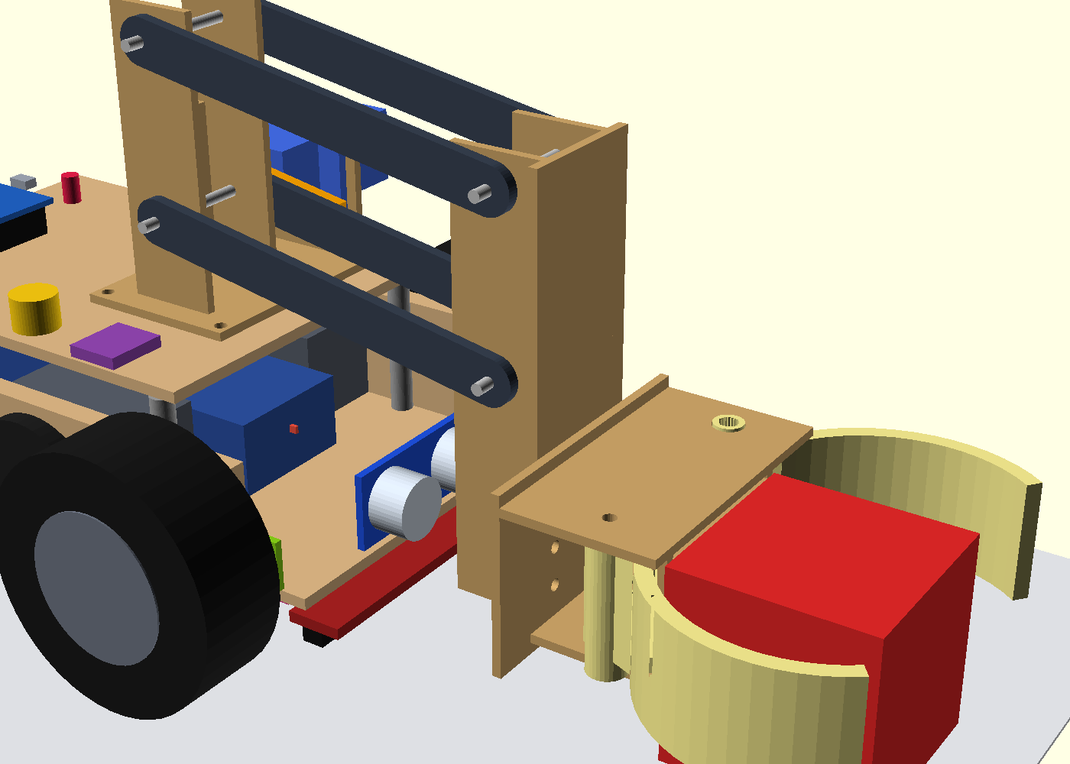
docs/2026-10-22_ombro-mg996r_c_pick.png
