jhlr/robo-challenge/docs/2026-10-24_chassi-asas-janelas.png

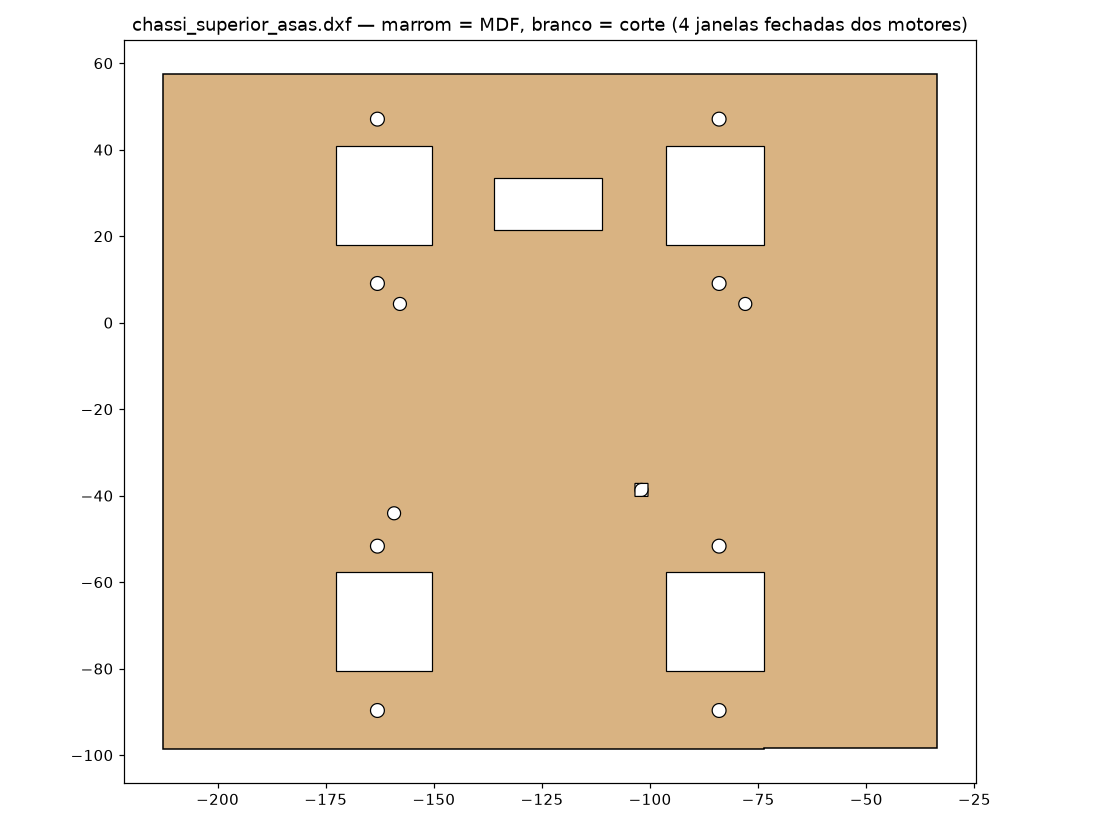
docs/2026-10-24_chassi-asas-janelas.png
