jhlr/robo-challenge/docs/2026-10-26_base-mg996r-4x1.png

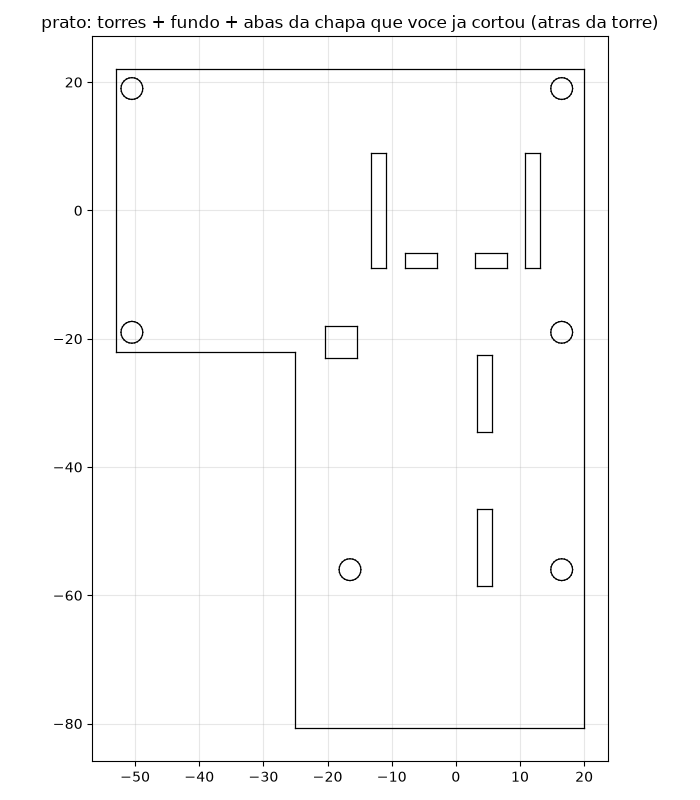
docs/2026-10-26_base-mg996r-4x1.png
