jhlr/robo-challenge/docs/2026-10-26_ombro-mg996r-4x1_3d.png

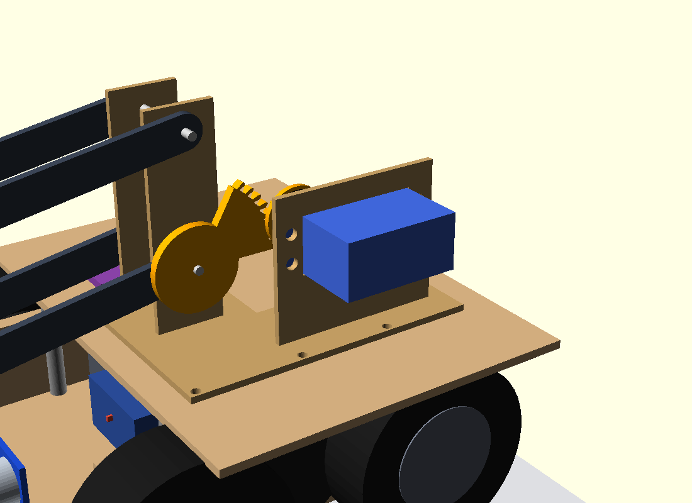
docs/2026-10-26_ombro-mg996r-4x1_3d.png
