jhlr/robo-challenge/docs/2026-10-27_pinhao-estriado-corte.png

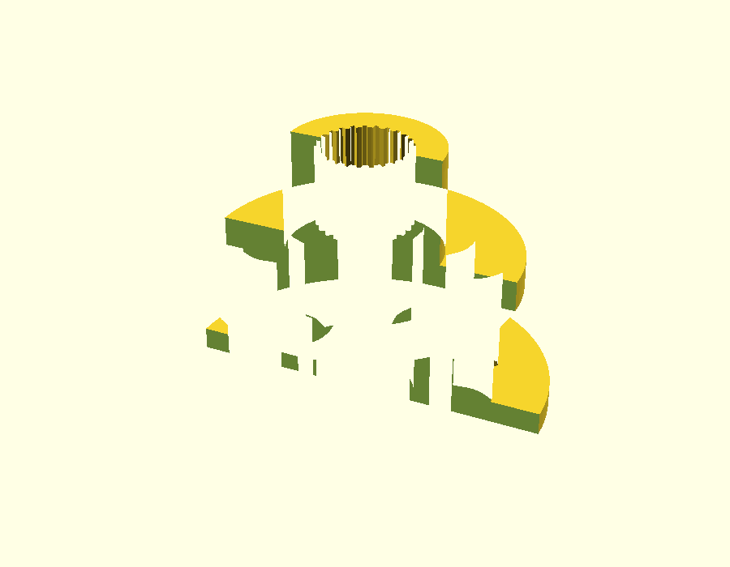
docs/2026-10-27_pinhao-estriado-corte.png
