jhlr/robo-challenge/docs/2026-10-27_pinhao-estriado-cortes.png

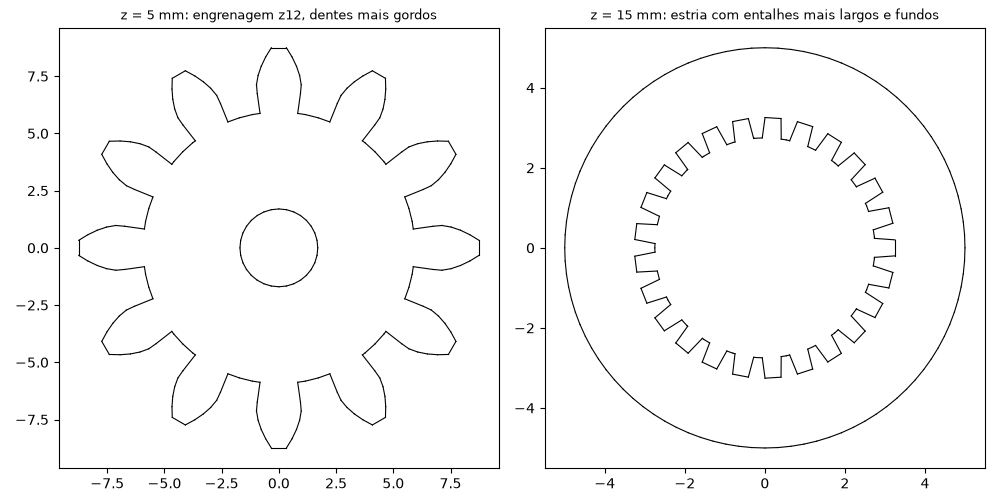
docs/2026-10-27_pinhao-estriado-cortes.png
