jhlr/robo-challenge/docs/2026-11-06_ombro-encaixe-barra_explodido.png

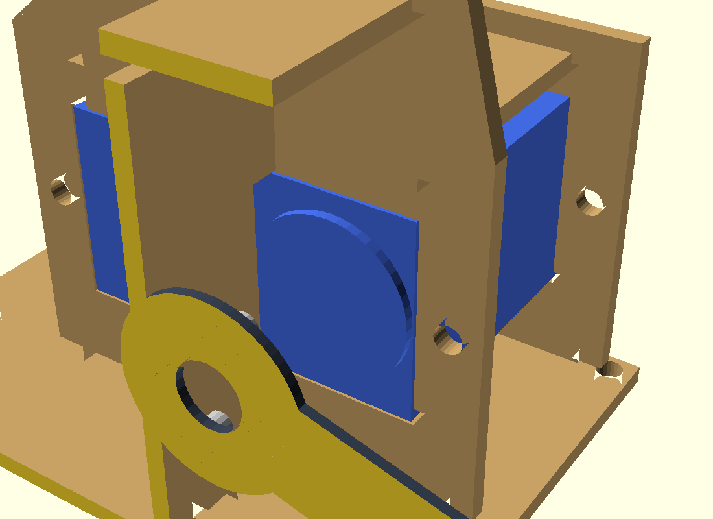
docs/2026-11-06_ombro-encaixe-barra_explodido.png
