jhlr/robo-challenge/docs/2026-11-06_ombro-encaixe-barra_montado.png

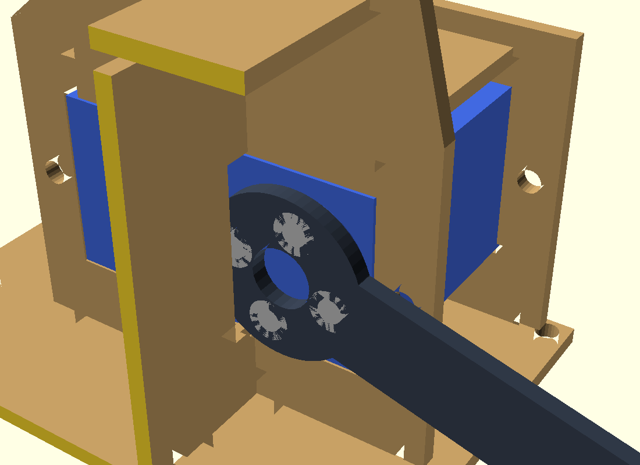
docs/2026-11-06_ombro-encaixe-barra_montado.png
