jhlr/robo-challenge/docs/2026-11-06_ombro-ligacao-servo-torre_2.png

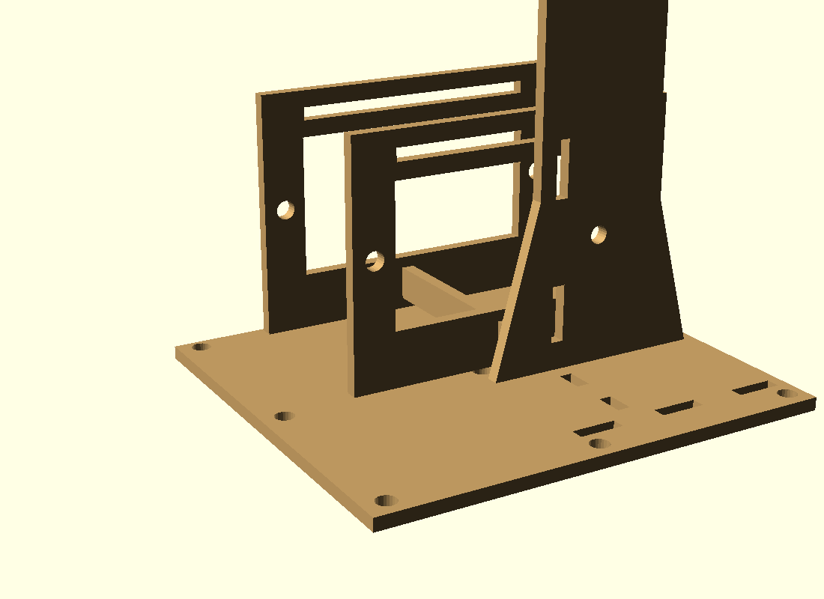
docs/2026-11-06_ombro-ligacao-servo-torre_2.png
