jhlr/robo-challenge/docs/2026-11-06_ombro-sts3215_dentro.png

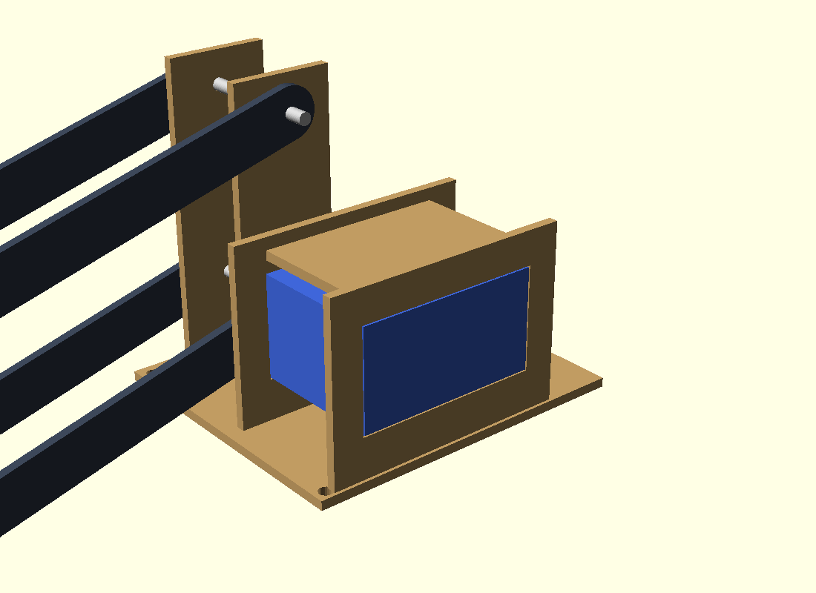
docs/2026-11-06_ombro-sts3215_dentro.png
