jhlr/robo-challenge/docs/2026-11-06_ombro-torre-quadro_fora.png

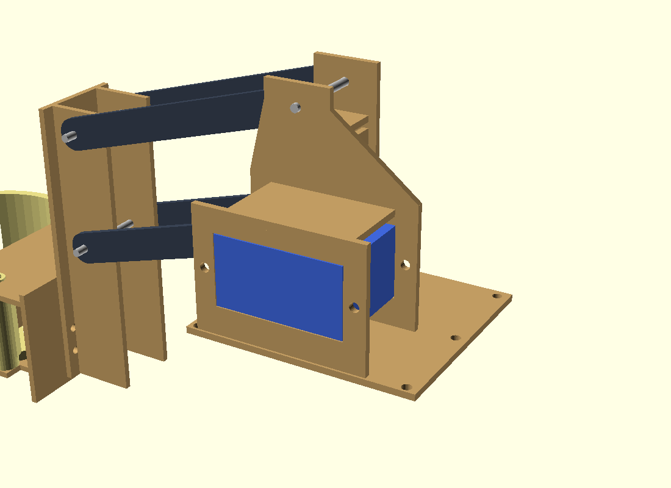
docs/2026-11-06_ombro-torre-quadro_fora.png
