jhlr/robo-challenge/cad/modelo_robo/materiais_img/lm2596.jpg

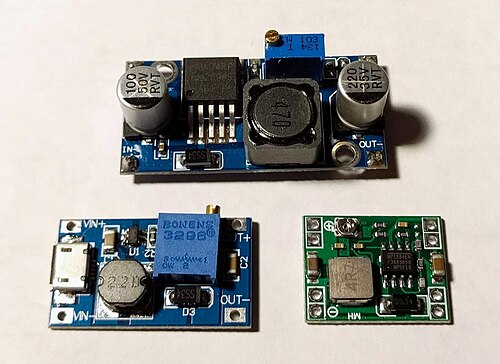
cad/modelo_robo/materiais_img/lm2596.jpg
