jhlr/robo-challenge/arquivo/chassi_baixo_descartado/chassi_superior_baixo.dxf

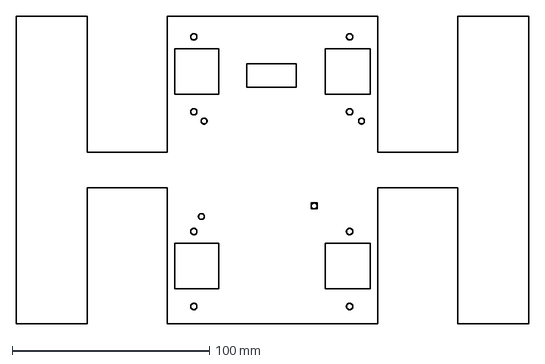
[picture p53: CAD file, 2026-10-27]
arquivo/chassi_baixo_descartado/chassi_superior_baixo.dxf
260.0 x 156.0 mm
