jhlr/robo-challenge/arquivo/ombro_mg996r_direto/base_mg996r_direto_standalone.dxf

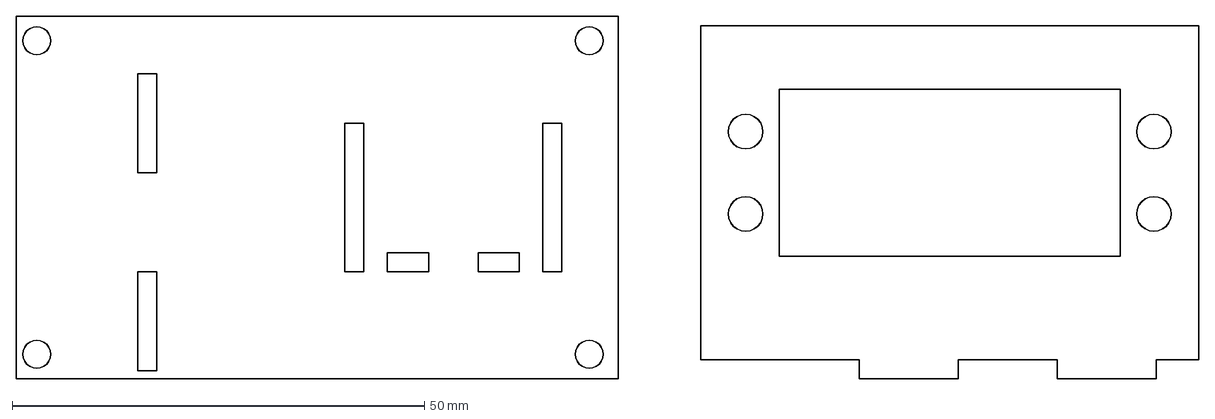
[picture p54: CAD file, 2026-10-27]
arquivo/ombro_mg996r_direto/base_mg996r_direto_standalone.dxf
143.4 x 44.0 mm
