jhlr/robo-challenge/arquivo/ombro_sg90_4x1/part_sr_sector.stl

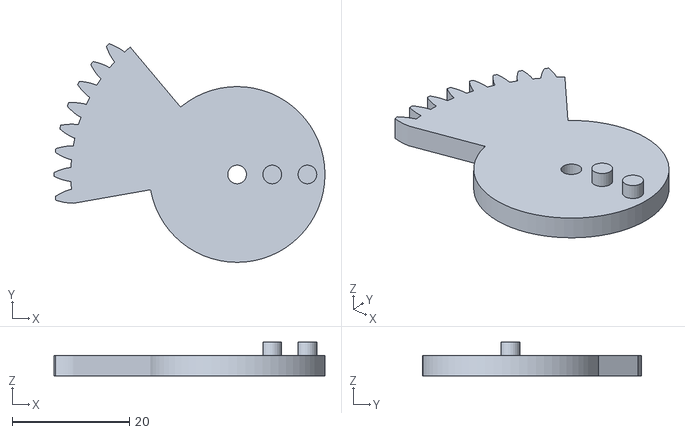
[picture p55: CAD file, 2026-10-27]
arquivo/ombro_sg90_4x1/part_sr_sector.stl
46.2 x 37.3 x 5.80
