jhlr/robo-challenge/arquivo/ombro_sg90_berco/sheet_ombro_1.dxf

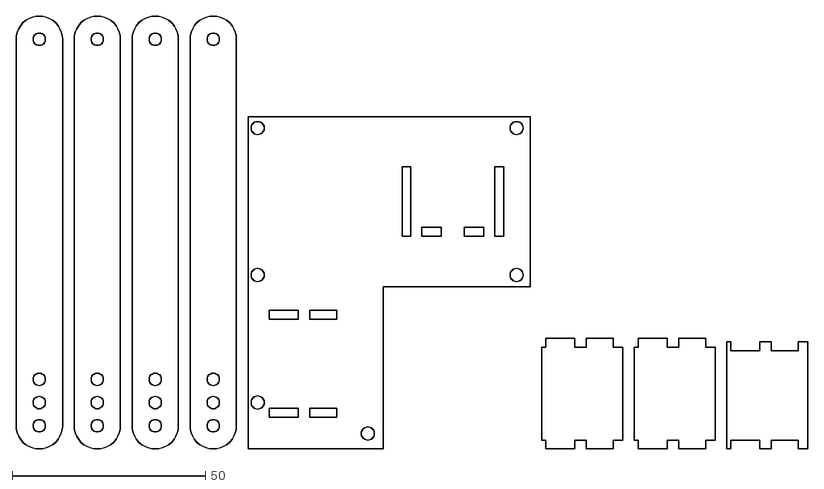
[picture p56: CAD file, 2026-10-27]
arquivo/ombro_sg90_berco/sheet_ombro_1.dxf
204.8 x 112.0
