jhlr/robo-challenge/arquivo/plotter_pecas_soltas/pecas_impressao_prontas/BASE.stl

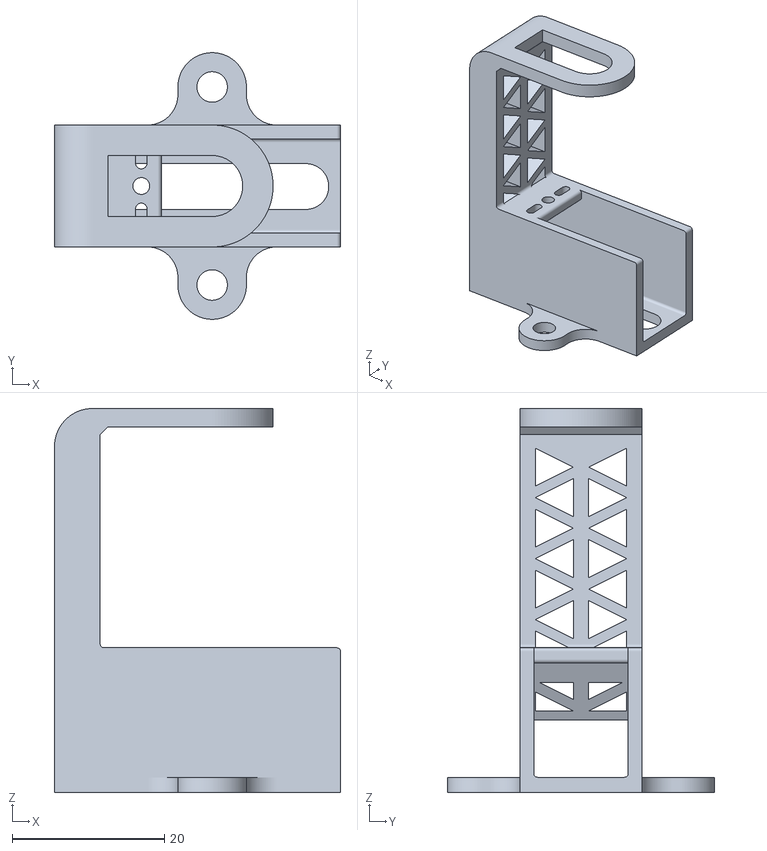
[picture p57: CAD file, 2026-10-27]
arquivo/plotter_pecas_soltas/pecas_impressao_prontas/BASE.stl
37.6 x 35.0 x 50.4
