jhlr/robo-challenge/arquivo/plotter_pecas_soltas/suporte_lapis.stl

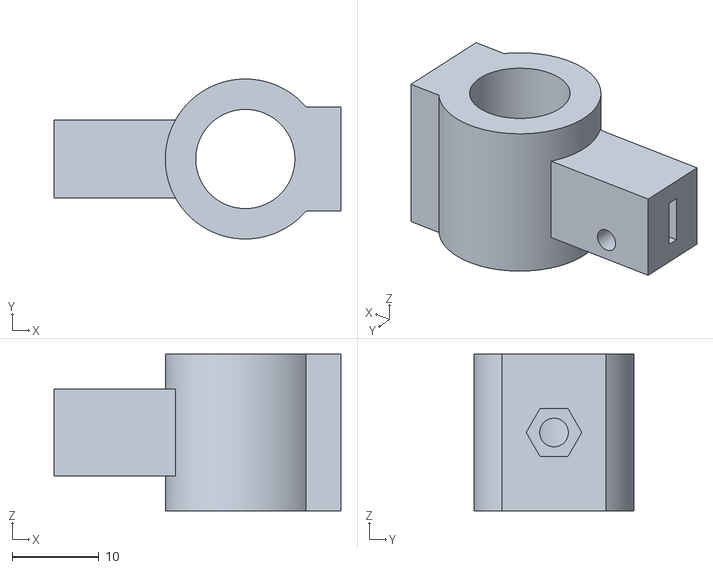
[picture p58: CAD file, 2026-10-27]
arquivo/plotter_pecas_soltas/suporte_lapis.stl
33.0 x 18.4 x 18.0
