jhlr/robo-challenge/arquivo/suporte_conector_dupont/part_sv_conector.stl

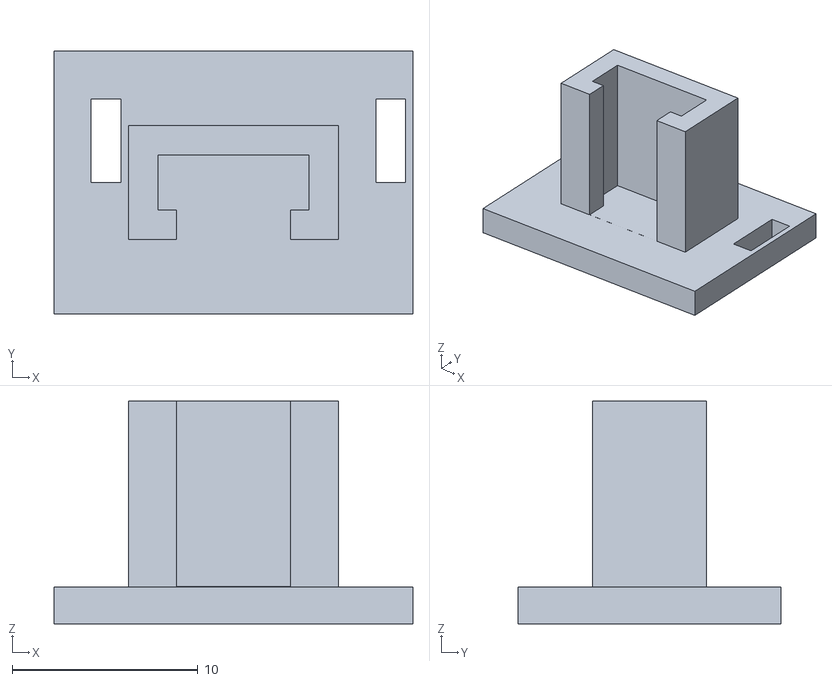
[picture p59: CAD file, 2026-10-27]
arquivo/suporte_conector_dupont/part_sv_conector.stl
19.3 x 14.1 x 12.0
