jhlr/robo-challenge/cad/braco/mdf/parts/back.dxf

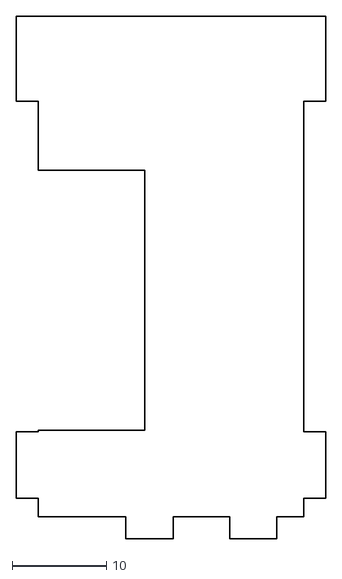
[picture p60: CAD file, 2026-11-06]
cad/braco/mdf/parts/back.dxf
32.7 x 55.3
