jhlr/robo-challenge/cad/braco/mdf/sheet_fundo_1.dxf

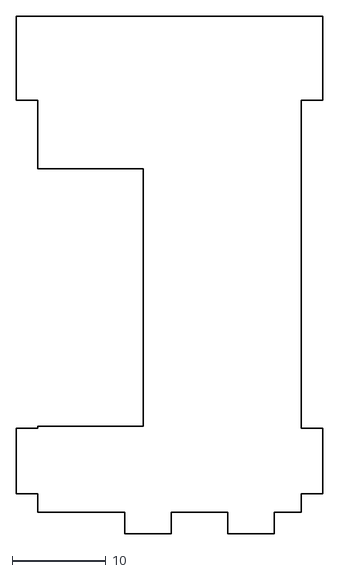
[picture p61: CAD file, 2026-11-06]
cad/braco/mdf/sheet_fundo_1.dxf
32.7 x 55.3
