jhlr/robo-challenge/cad/braco/stl/part_jaw_l.stl

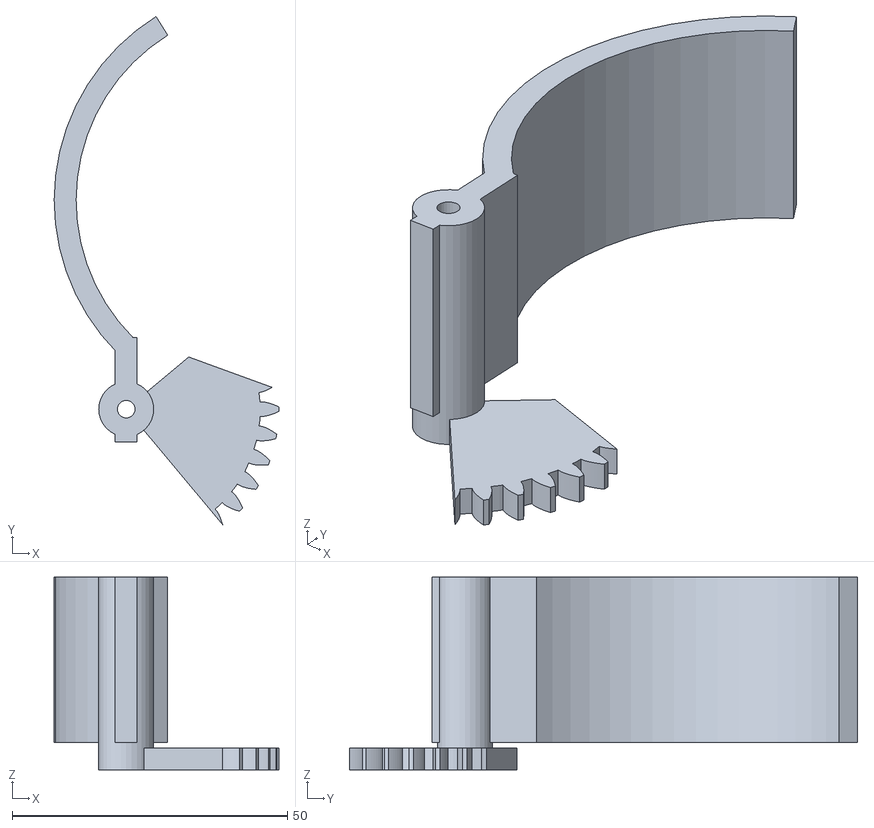
[picture p62: CAD file, 2026-10-27]
cad/braco/stl/part_jaw_l.stl
40.9 x 92.4 x 35.0
