jhlr/robo-challenge/cad/chassi/Esboço30_furo_mais_10mm.dxf

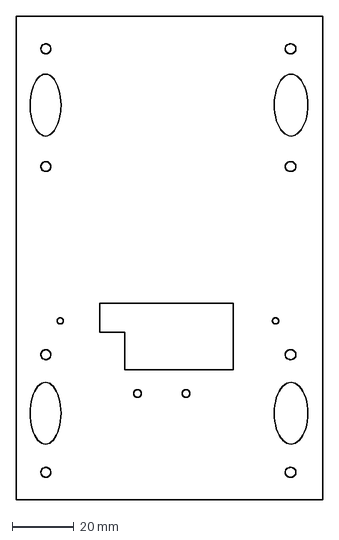
[picture p63: CAD file, 2026-10-27]
cad/chassi/Esboço30_furo_mais_10mm.dxf
99.0 x 156.0 mm
