jhlr/robo-challenge/cad/esp32_caixa/esp32_caixa.stl

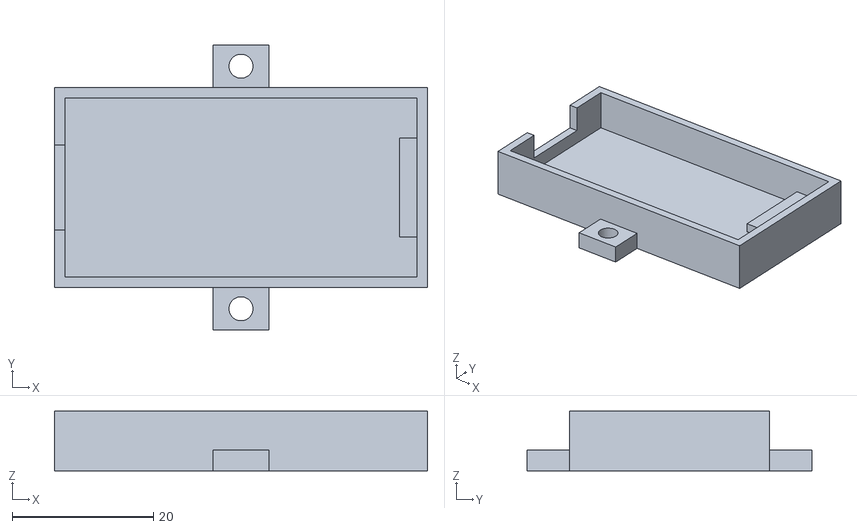
[picture p64: CAD file, 2026-10-31]
cad/esp32_caixa/esp32_caixa.stl
52.9 x 40.4 x 8.50
