jhlr/robo-challenge/cad/garra_sts/engrenagem_sts.stl

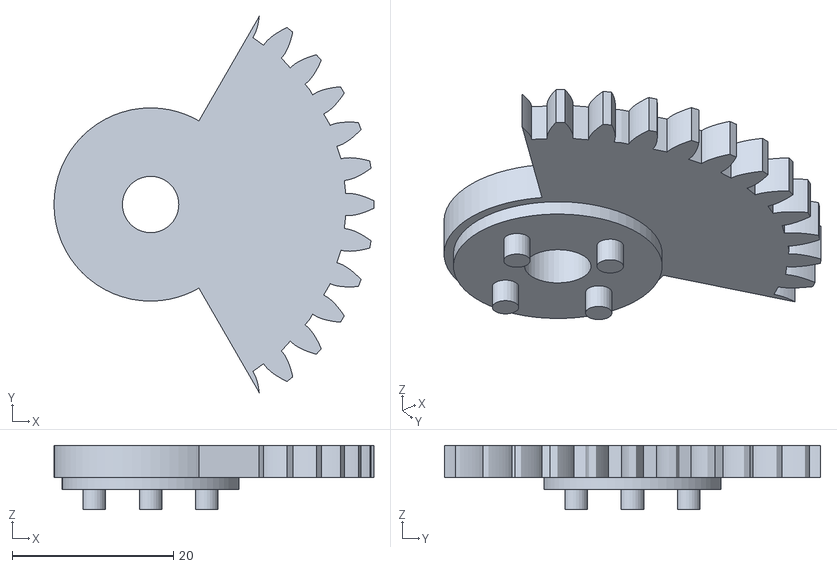
[picture p65: CAD file, 2026-11-06]
cad/garra_sts/engrenagem_sts.stl
39.7 x 46.7 x 8.00
