jhlr/robo-challenge/cad/modelo_robo/stl/horn.stl

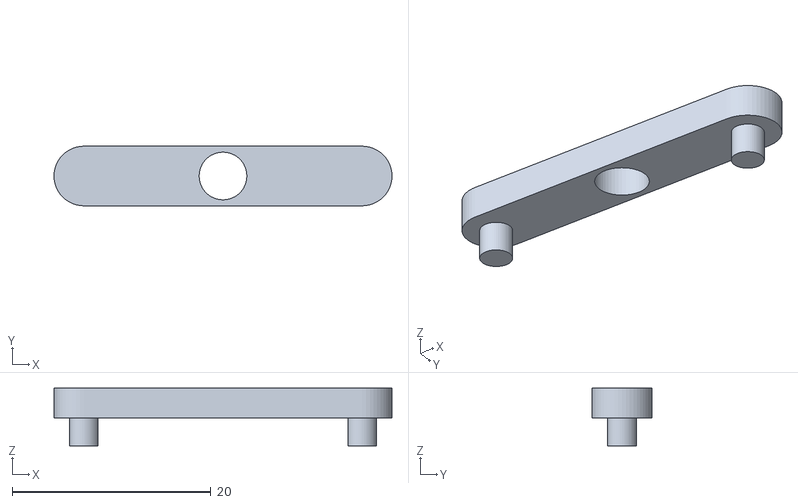
[picture p66: CAD file, 2026-10-27]
cad/modelo_robo/stl/horn.stl
34.0 x 6.00 x 5.80
