jhlr/robo-challenge/arquivo/ombro_mg996r_direto/sheet_ombro_1_mg996r.dxf

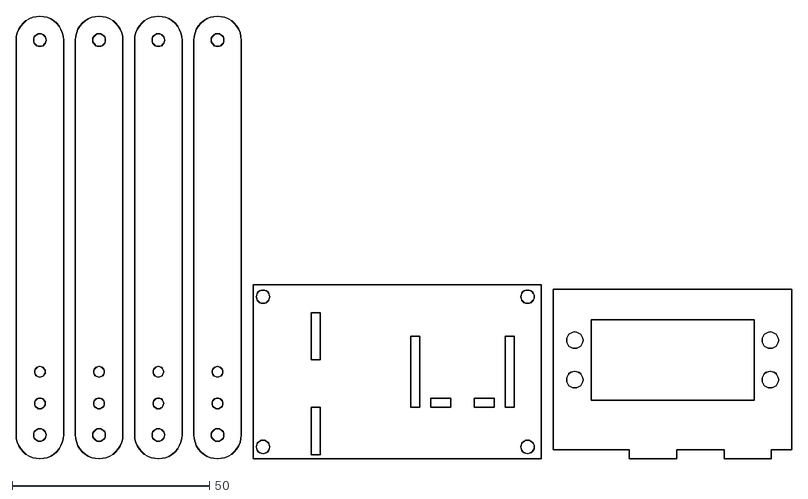
[picture p67: CAD file, 2026-10-27]
arquivo/ombro_mg996r_direto/sheet_ombro_1_mg996r.dxf
196.4 x 112.0
