jhlr/robo-challenge/arquivo/ombro_sg90_4x1/part_sr_pinion.stl

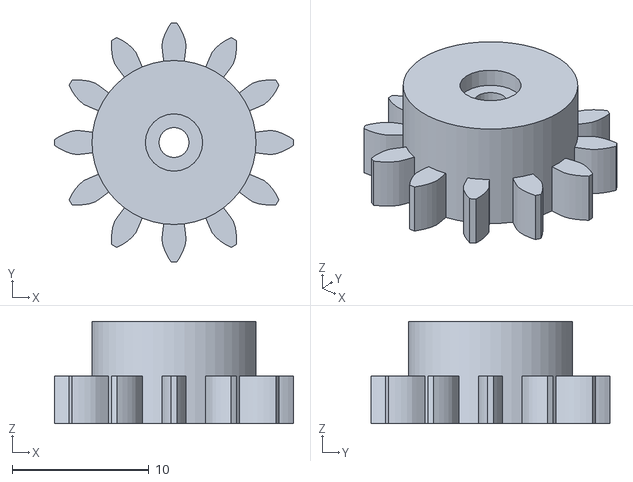
[picture p68: CAD file, 2026-10-27]
arquivo/ombro_sg90_4x1/part_sr_pinion.stl
17.5 x 17.5 x 7.50
