jhlr/robo-challenge/arquivo/plotter_pecas_soltas/MONT_PE10_com_suporte.stl

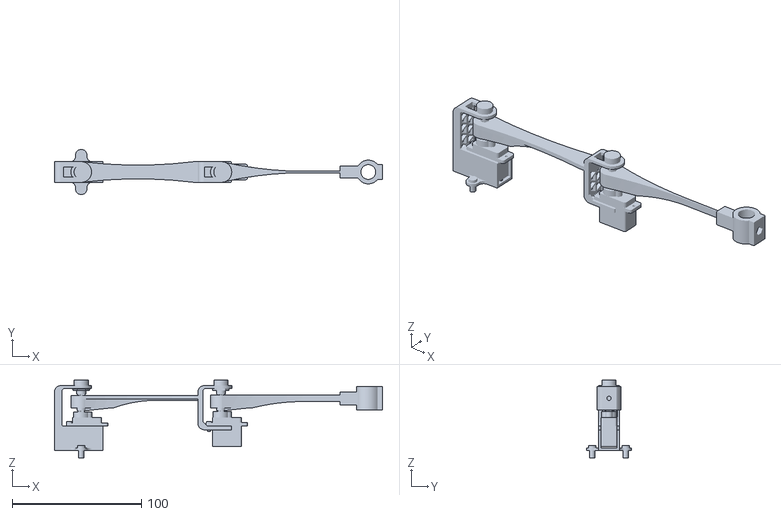
[picture p69: CAD file, 2026-10-27]
arquivo/plotter_pecas_soltas/MONT_PE10_com_suporte.stl
254.0 x 35.0 x 60.3
