jhlr/robo-challenge/arquivo/plotter_pecas_soltas/pecas_impressao_prontas/ELO_1.stl

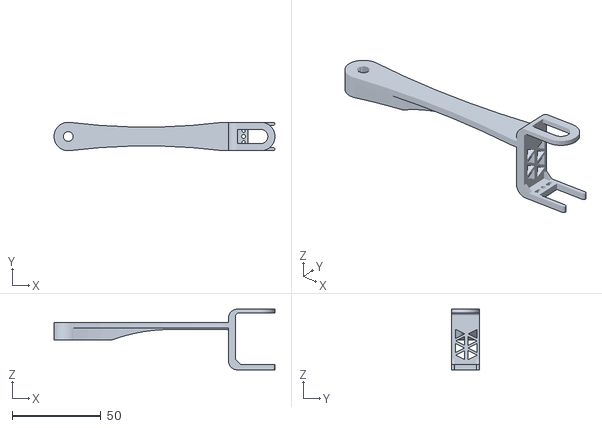
[picture p70: CAD file, 2026-10-27]
arquivo/plotter_pecas_soltas/pecas_impressao_prontas/ELO_1.stl
124.6 x 16.0 x 34.2
