jhlr/robo-challenge/cad/braco/mdf/parts/tower.dxf

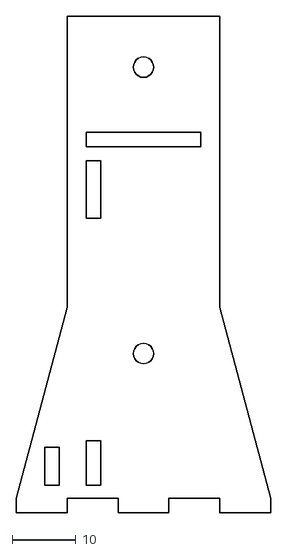
[picture p71: CAD file, 2026-11-06]
cad/braco/mdf/parts/tower.dxf
40.0 x 78.0
