jhlr/robo-challenge/cad/braco/mdf/sheet_ombro_1.dxf

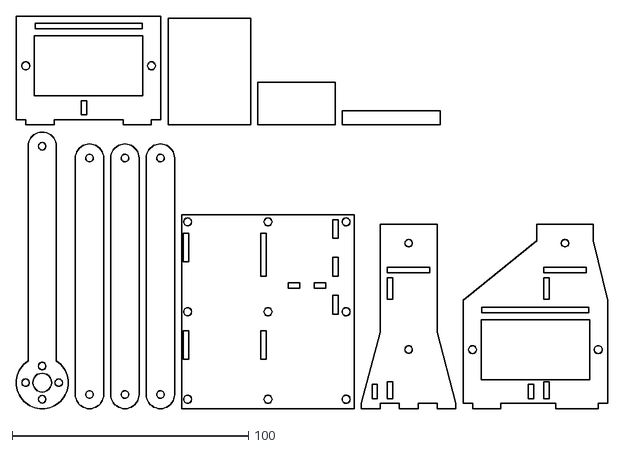
[picture p72: CAD file, 2026-11-06]
cad/braco/mdf/sheet_ombro_1.dxf
250.2 x 166.0
