jhlr/robo-challenge/cad/braco/stl/claw_frame.stl

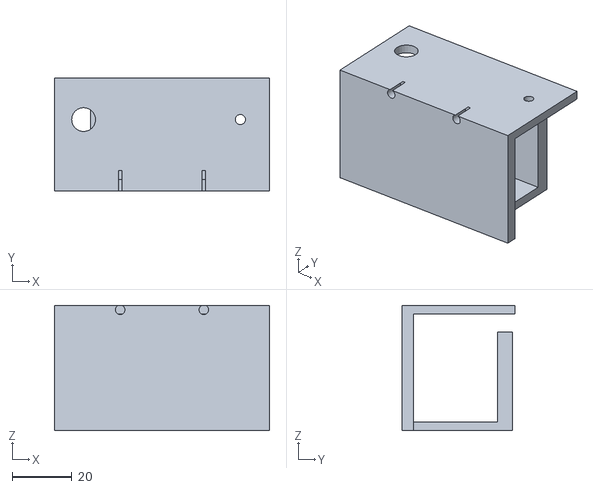
[picture p73: CAD file, 2026-10-27]
cad/braco/stl/claw_frame.stl
72.0 x 38.0 x 42.0
