jhlr/robo-challenge/cad/chassi/chassi_superior_alargado.dxf

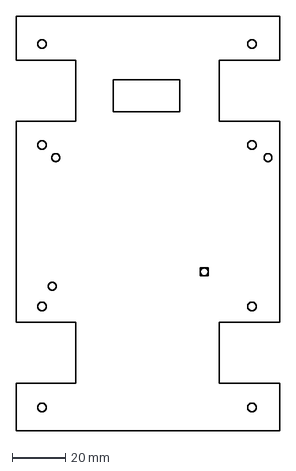
[picture p74: CAD file, 2026-10-27]
cad/chassi/chassi_superior_alargado.dxf
99.0 x 156.0 mm
