jhlr/robo-challenge/cad/modelo_robo/stl/slider_b.stl

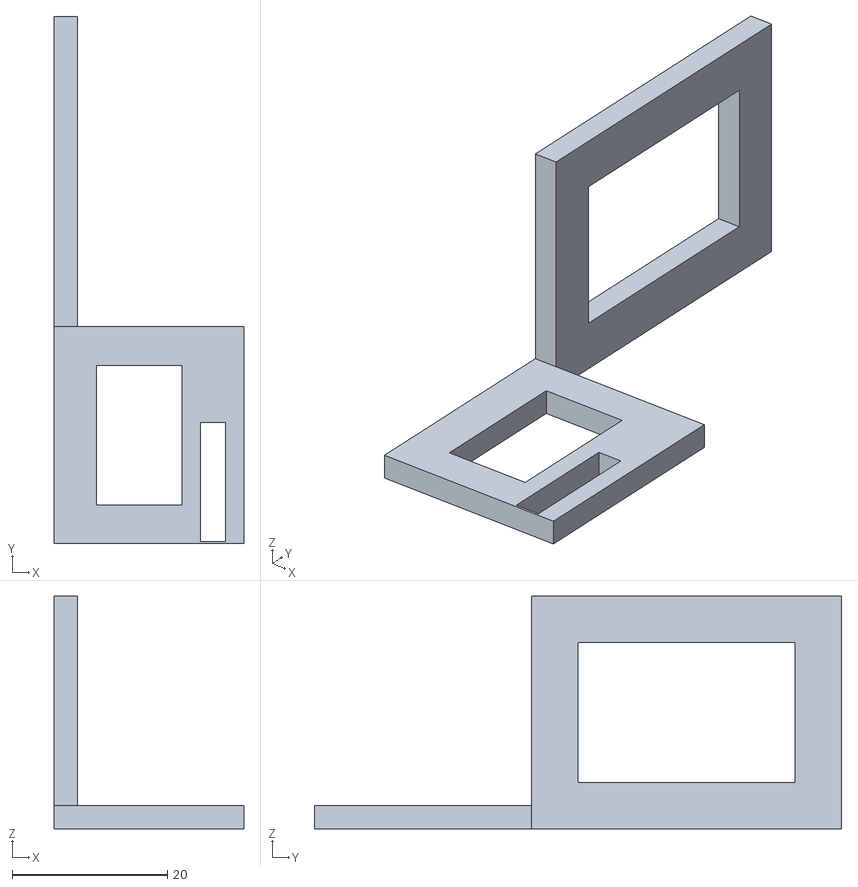
[picture p75: CAD file, 2026-10-27]
cad/modelo_robo/stl/slider_b.stl
24.5 x 68.0 x 30.0
