jhlr/robo-challenge/arquivo/plotter_pecas_soltas/BASE_e_SUPORTE_LAPIS.stl

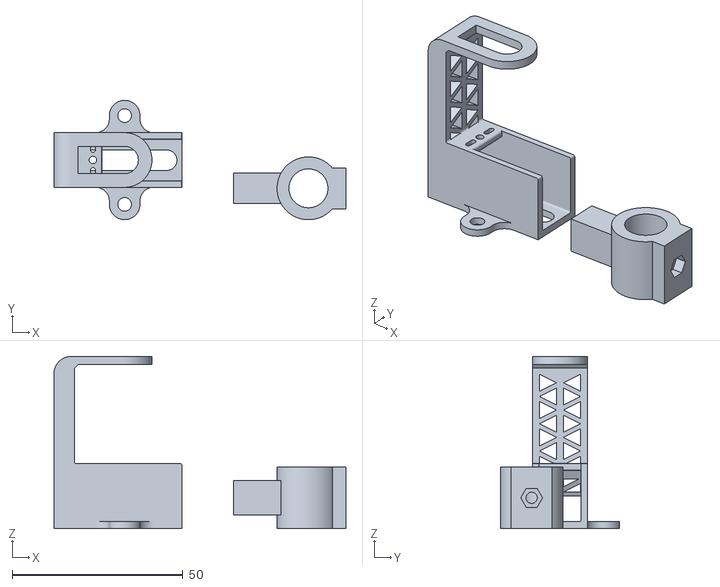
[picture p76: CAD file, 2026-10-27]
arquivo/plotter_pecas_soltas/BASE_e_SUPORTE_LAPIS.stl
85.6 x 35.0 x 50.4
