jhlr/robo-challenge/cad/braco/mdf/parts/towertop.dxf

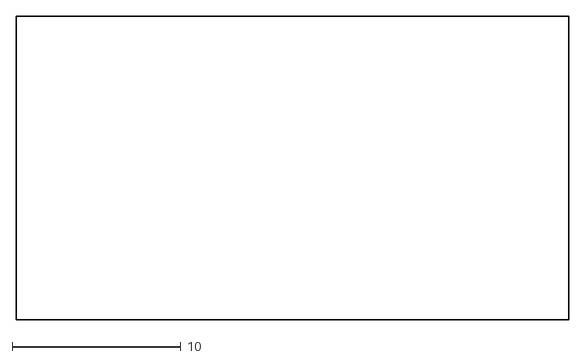
[picture p77: CAD file, 2026-11-06]
cad/braco/mdf/parts/towertop.dxf
32.7 x 18.0
