jhlr/robo-challenge/cad/braco/mdf/sheet_torres_1.dxf

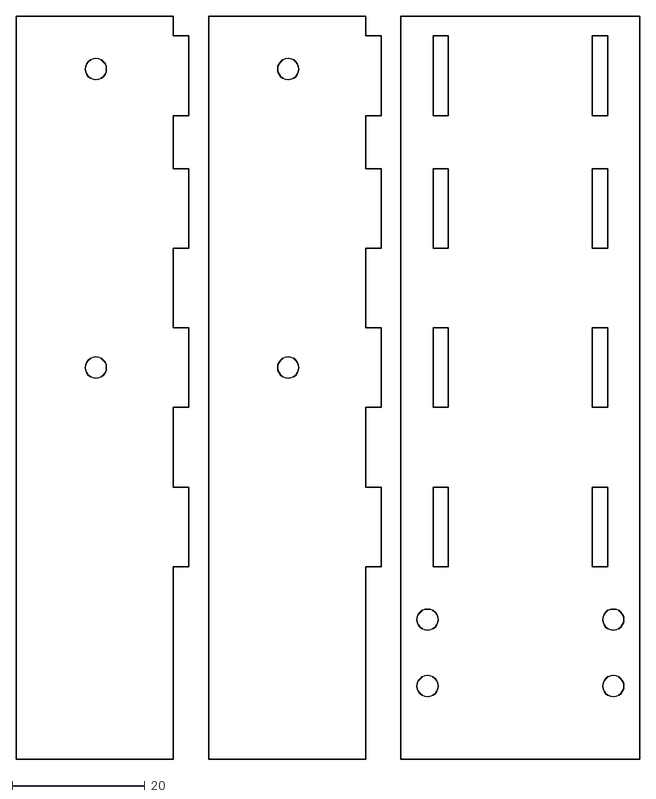
[picture p78: CAD file, 2026-11-06]
cad/braco/mdf/sheet_torres_1.dxf
94.0 x 112.0
