jhlr/robo-challenge/cad/braco/stl/part_ext_eixo.stl

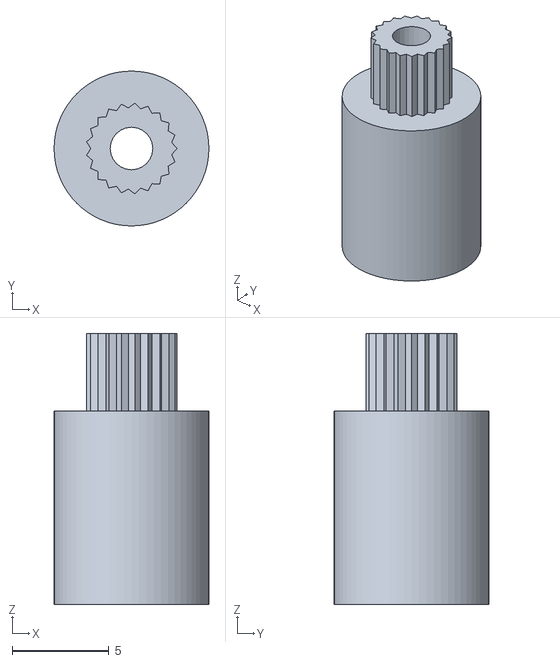
[picture p79: CAD file, 2026-10-27]
cad/braco/stl/part_ext_eixo.stl
8.00 x 8.00 x 14.0
