jhlr/robo-challenge/cad/chassi/chassi_superior_asas.dxf

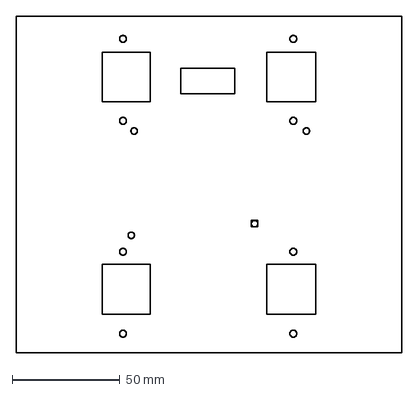
[picture p80: CAD file, 2026-10-27]
cad/chassi/chassi_superior_asas.dxf
179.0 x 156.1 mm
