jhlr/robo-challenge/cad/modelo_robo/stl/slider_a.stl

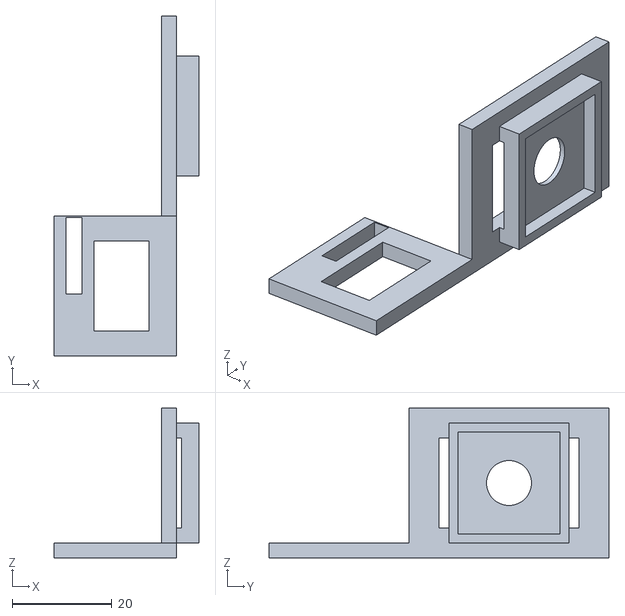
[picture p81: CAD file, 2026-10-27]
cad/modelo_robo/stl/slider_a.stl
29.0 x 68.0 x 30.0
