jhlr/robo-challenge/arquivo/plotter_pecas_soltas/pecas_impressao_prontas/ELO_2.stl

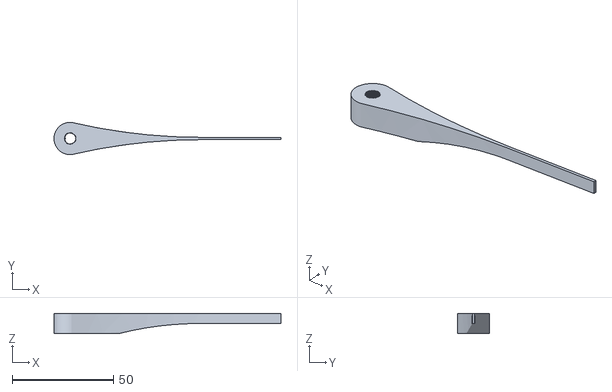
[picture p82: CAD file, 2026-10-27]
arquivo/plotter_pecas_soltas/pecas_impressao_prontas/ELO_2.stl
112.2 x 16.0 x 10.0
