jhlr/robo-challenge/cad/braco/mdf/parts/base.dxf

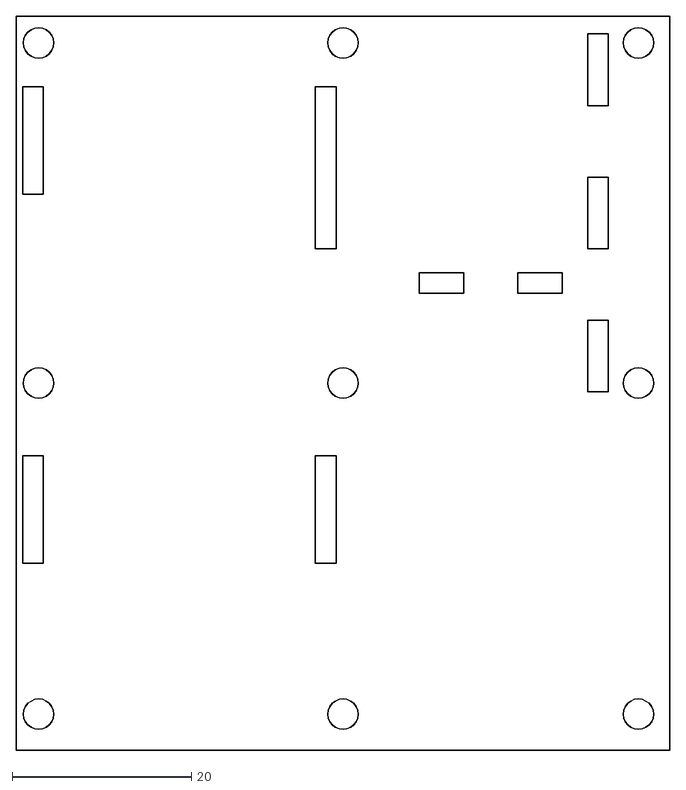
[picture p83: CAD file, 2026-11-06]
cad/braco/mdf/parts/base.dxf
73.0 x 82.0
