jhlr/robo-challenge/cad/braco/mdf/sheet_moldura_1.dxf

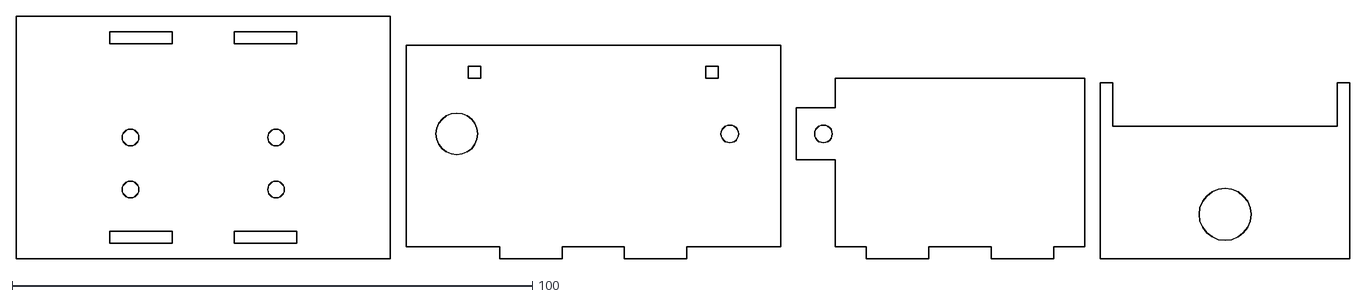
[picture p84: CAD file, 2026-10-27]
cad/braco/mdf/sheet_moldura_1.dxf
256.5 x 46.6
