jhlr/robo-challenge/cad/braco/stl/claw_jaw_r.stl

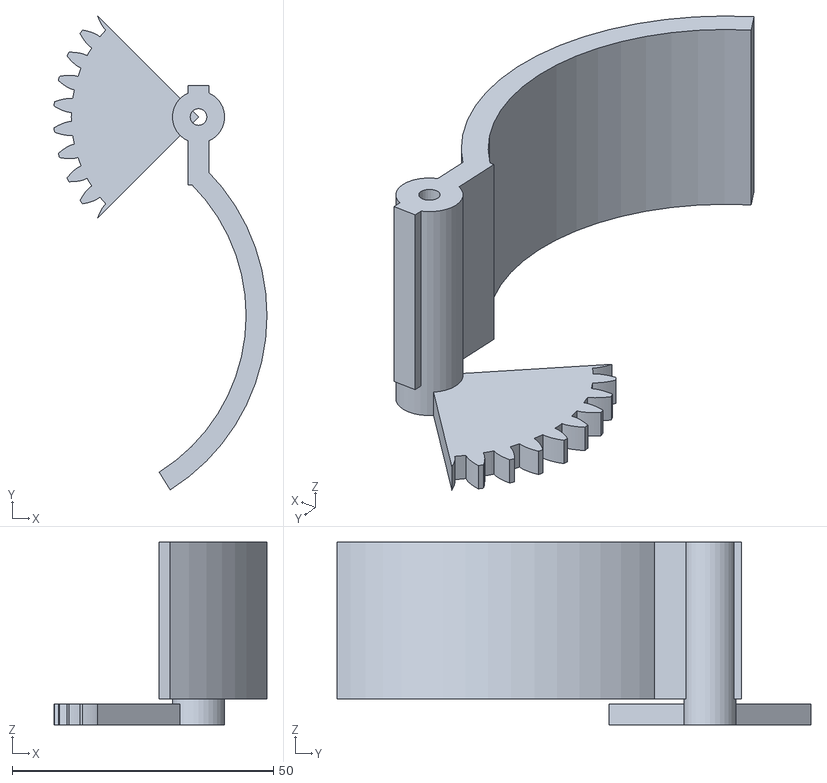
[picture p85: CAD file, 2026-10-27]
cad/braco/stl/claw_jaw_r.stl
40.8 x 90.7 x 35.0
