jhlr/robo-challenge/cad/modelo_robo/stl/pinion.stl

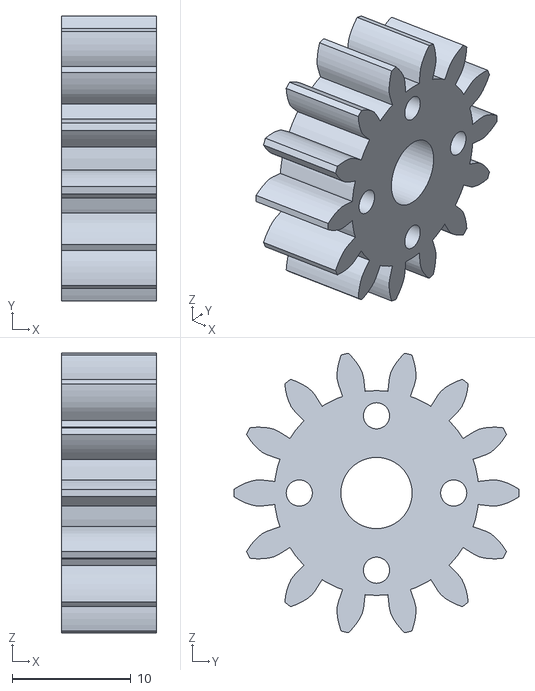
[picture p86: CAD file, 2026-10-27]
cad/modelo_robo/stl/pinion.stl
8.00 x 24.0 x 23.5
