jhlr/robo-challenge/cad/braco/mdf/furo_15x10.dxf

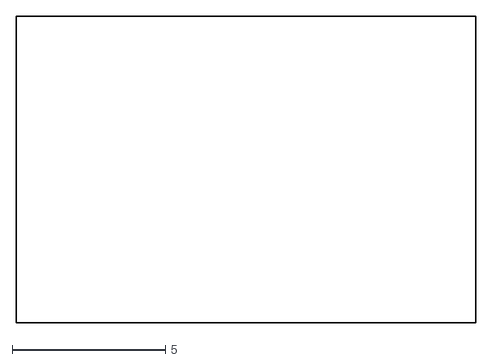
[picture p87: CAD file, 2026-10-27]
cad/braco/mdf/furo_15x10.dxf
15.0 x 10.0
