jhlr/robo-challenge/cad/braco/mdf/parts/towerframe.dxf

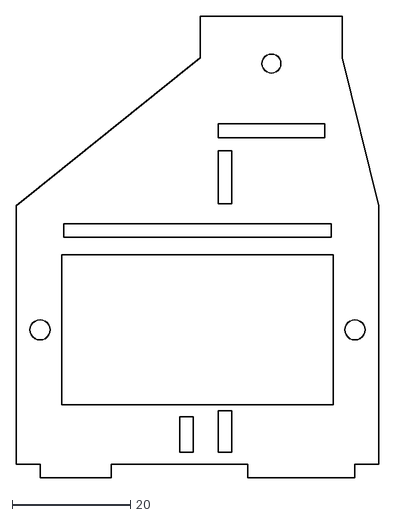
[picture p88: CAD file, 2026-11-06]
cad/braco/mdf/parts/towerframe.dxf
61.2 x 78.0
