jhlr/robo-challenge/cad/modelo_robo/stl/mast.stl

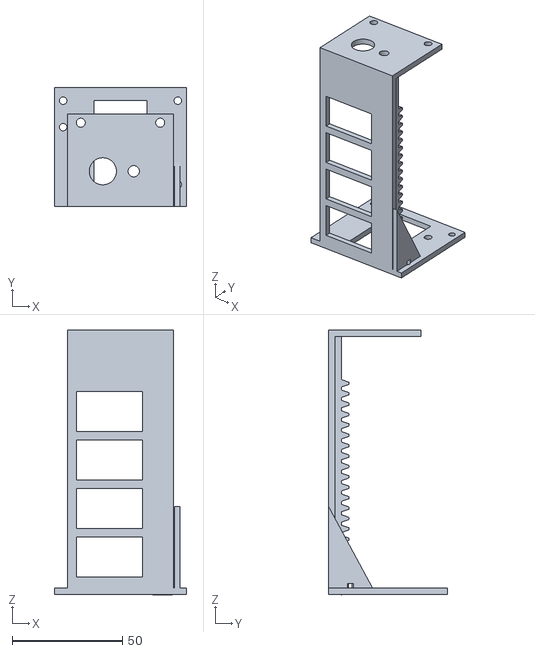
[picture p90: CAD file, 2026-10-27]
cad/modelo_robo/stl/mast.stl
60.0 x 54.0 x 120.1
