jhlr/robo-challenge/cad/braco/mdf/parts/stsframe.dxf

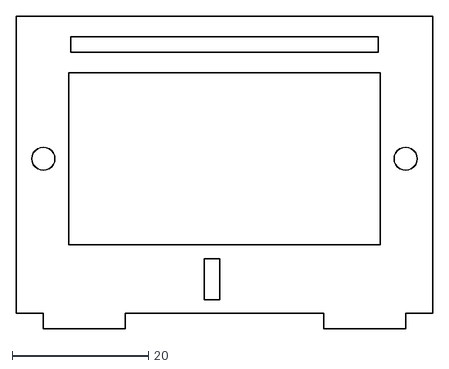
[picture p91: CAD file, 2026-11-06]
cad/braco/mdf/parts/stsframe.dxf
61.2 x 46.0
