jhlr/robo-challenge/cad/modelo_robo/stl/carriage.stl

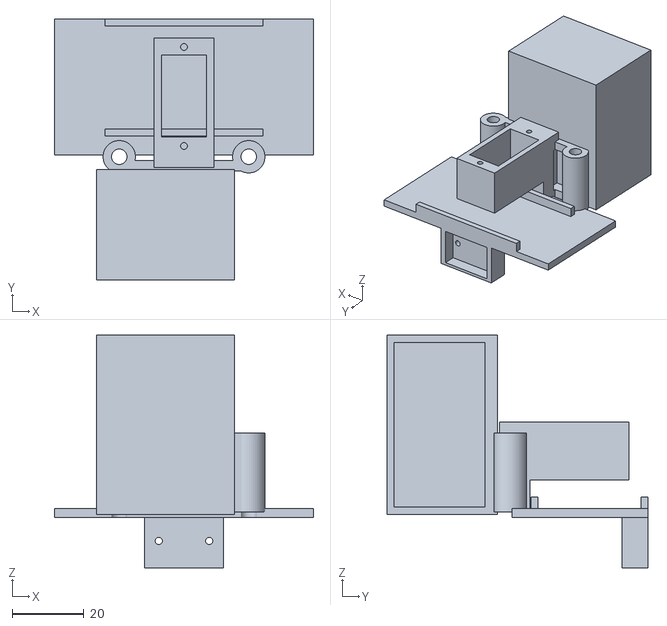
[picture p93: CAD file, 2026-10-27]
cad/modelo_robo/stl/carriage.stl
72.0 x 72.6 x 64.7
