jhlr/robo-challenge/cad/braco/mdf/parts/stsbrace.dxf

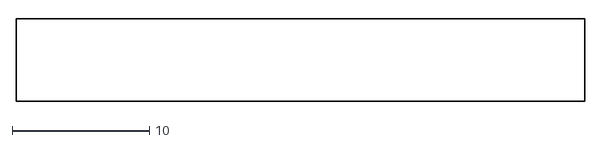
[picture p94: CAD file, 2026-11-06]
cad/braco/mdf/parts/stsbrace.dxf
41.4 x 6.00
