jhlr/robo-challenge/cad/braco/stl/part_coupler.stl

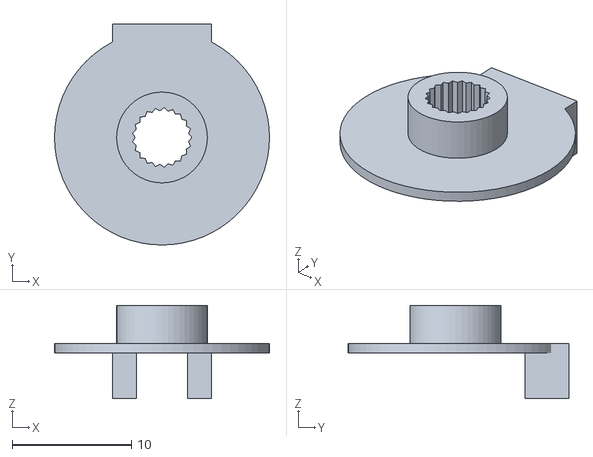
[picture p95: CAD file, 2026-10-27]
cad/braco/stl/part_coupler.stl
18.0 x 18.5 x 7.80
