jhlr/robo-challenge/cad/braco/mdf/parts/stsshelf.dxf

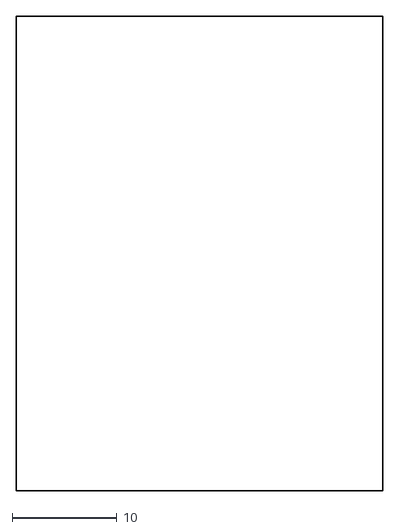
[picture p96: CAD file, 2026-11-06]
cad/braco/mdf/parts/stsshelf.dxf
35.0 x 45.2
