jhlr/robo-challenge/cad/braco/stl/claw_bar.stl

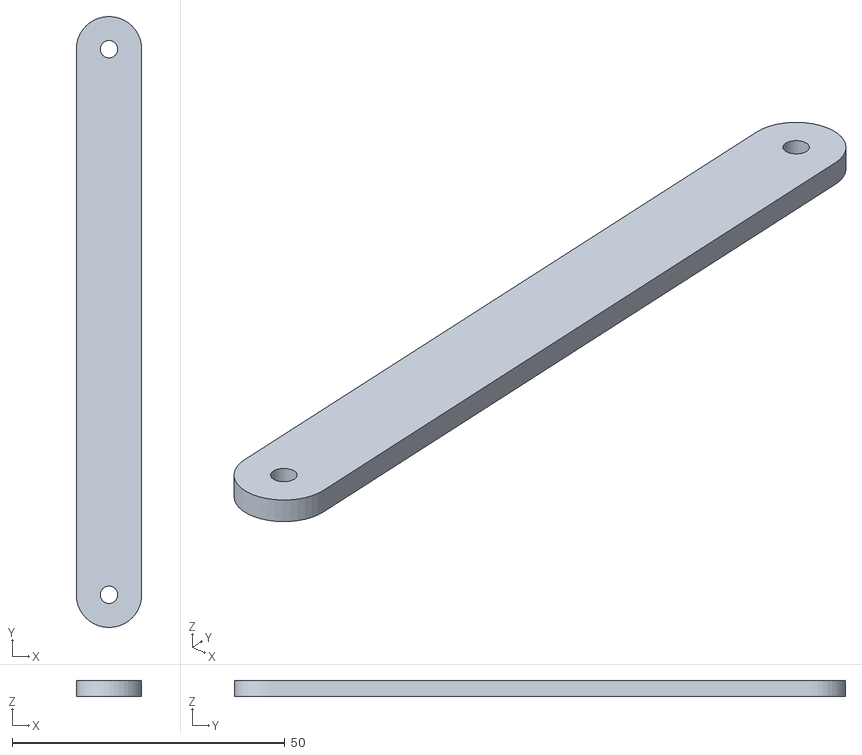
[picture p97: CAD file, 2026-10-27]
cad/braco/stl/claw_bar.stl
12.0 x 112.0 x 3.00
