jhlr/robo-challenge/cad/braco/mdf/parts/bar_sts.dxf

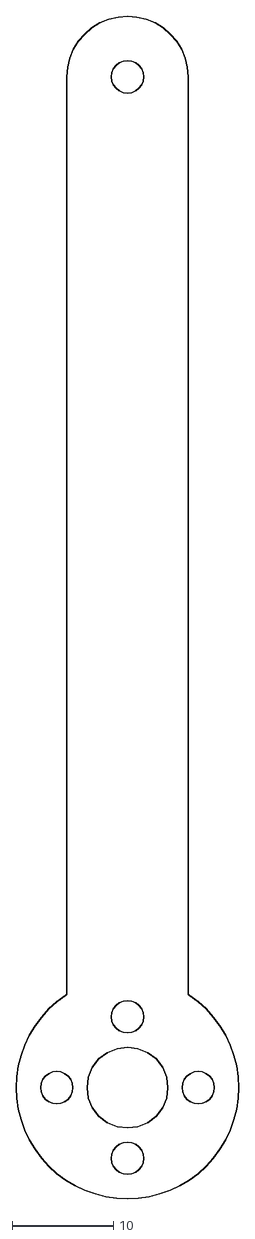
[picture p98: CAD file, 2026-11-06]
cad/braco/mdf/parts/bar_sts.dxf
22.0 x 117.0
