jhlr/robo-challenge/cad/braco/stl/claw_carrier.stl

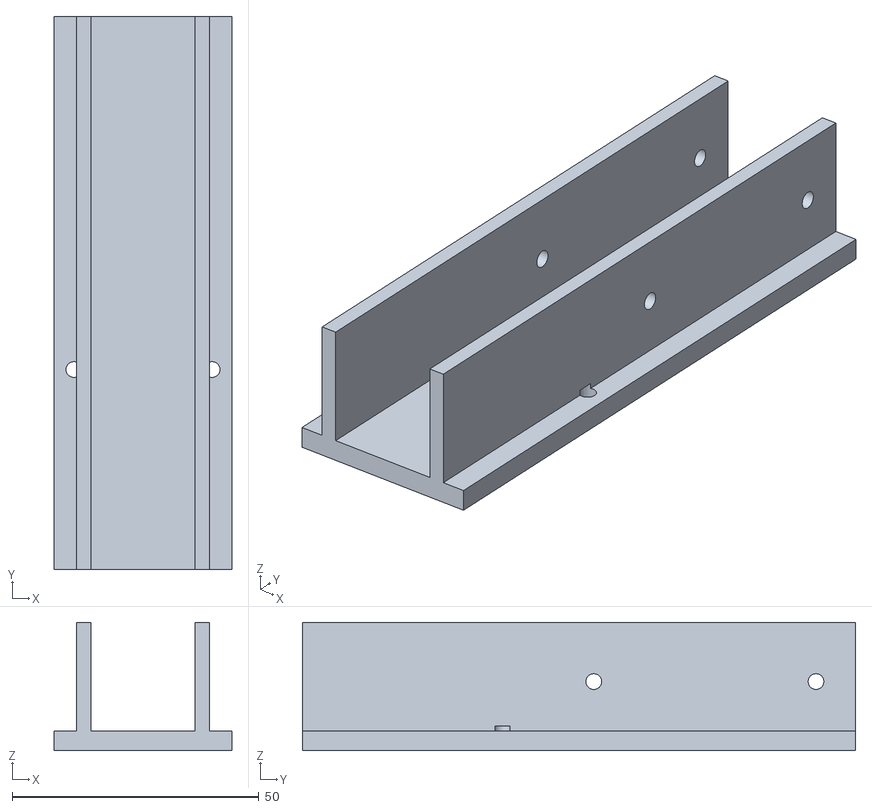
[picture p99: CAD file, 2026-10-27]
cad/braco/stl/claw_carrier.stl
36.0 x 112.0 x 26.0
