jhlr/robo-challenge/cad/braco/mdf/parts/bar.dxf

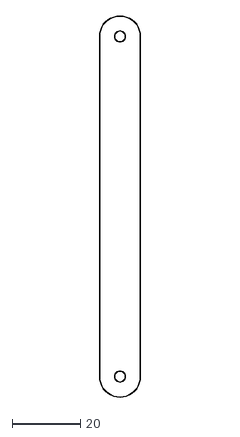
[picture p100: CAD file, 2026-11-06]
cad/braco/mdf/parts/bar.dxf
12.0 x 112.0
