jhlr/robo-challenge/cad/braco/mdf/parts/front.dxf

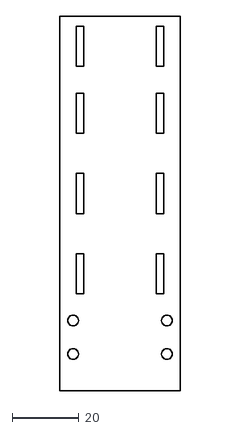
[picture p101: CAD file, 2026-10-27]
cad/braco/mdf/parts/front.dxf
36.0 x 112.0
