jhlr/robo-challenge/cad/braco/mdf/parts/cshelf.dxf

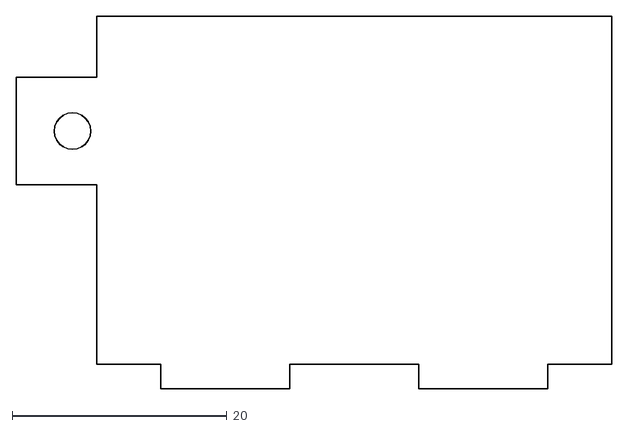
[picture p102: CAD file, 2026-10-27]
cad/braco/mdf/parts/cshelf.dxf
55.5 x 34.7
