jhlr/robo-challenge/cad/braco/mdf/parts/bridge.dxf

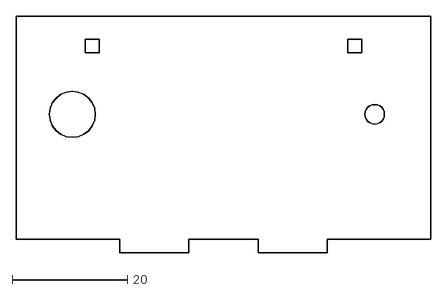
[picture p103: CAD file, 2026-10-27]
cad/braco/mdf/parts/bridge.dxf
72.0 x 41.0
