jhlr/robo-challenge/cad/braco/mdf/parts/rear.dxf

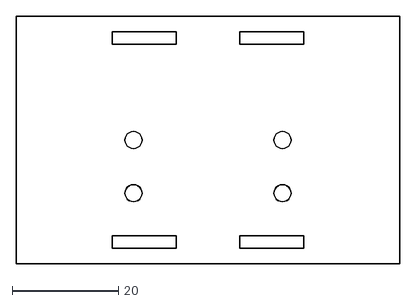
[picture p104: CAD file, 2026-10-27]
cad/braco/mdf/parts/rear.dxf
72.0 x 46.6
