jhlr/robo-challenge/cad/braco/mdf/parts/side.dxf

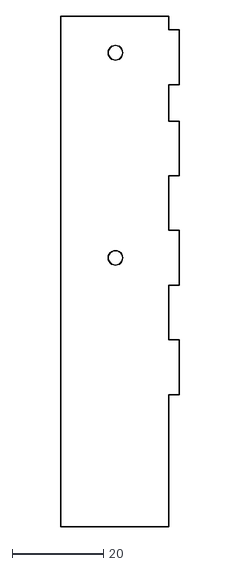
[picture p105: CAD file, 2026-10-27]
cad/braco/mdf/parts/side.dxf
26.0 x 112.0
