jhlr/robo-challenge/cad/braco/mdf/parts/stop.dxf

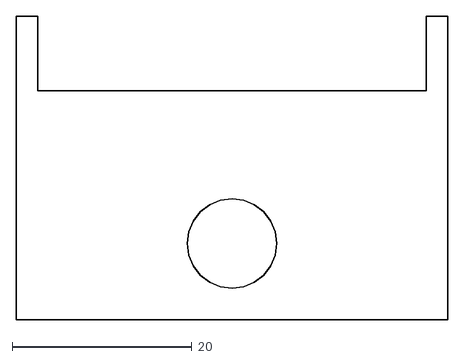
[picture p106: CAD file, 2026-10-27]
cad/braco/mdf/parts/stop.dxf
48.0 x 33.8
