jhlr/robo-challenge/cad/braco/mdf/parts/servoplate.dxf

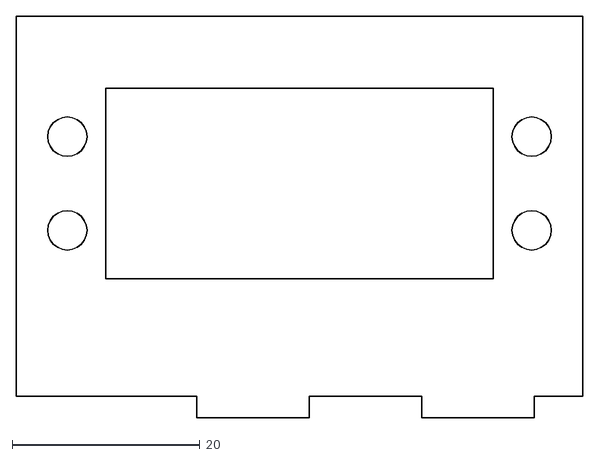
[picture p107: CAD file, 2026-10-27]
cad/braco/mdf/parts/servoplate.dxf
60.4 x 42.8
