jhlr/robo-challenge/cad/braco/mdf/parts/coupon.dxf

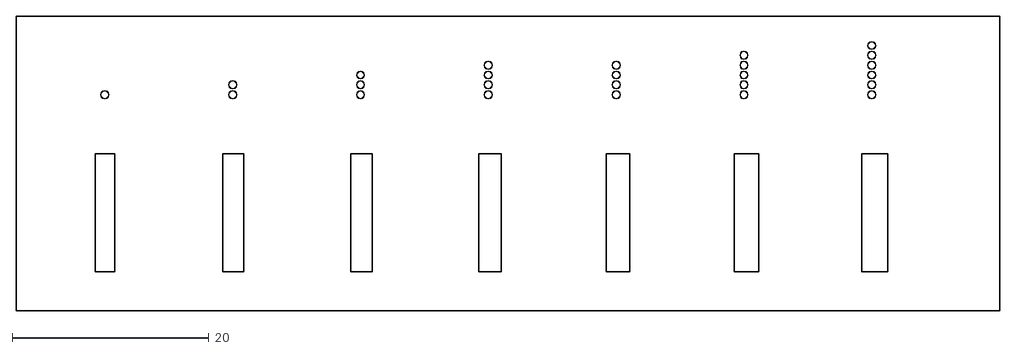
[picture p108: CAD file, 2026-10-27]
cad/braco/mdf/parts/coupon.dxf
100.0 x 30.0
