jhlr/robo-challenge/cad/braco/params_gen.scad

// GERADO por cad/braco/cinematica.py a partir de params.json. Nao editar.
z_s = 93;
L1 = 100;
h_v = 45;
carrier_below = 56;
claw_cube_center = 76.0;
cr_gm = 1.5;
cr_gz = 35;
cr_jt = 4;
cr_jlen = 70;
cr_jback = 6;
cr_jh = 30;
cr_psi_open = 20;
cr_gz0 = 31;
cr_gt = 4;
cr_bz0 = 36;
cr_bt = 3;
cr_stop_y = 8;
cr_stop_t = 5;
cr_rear = 24;
cr_bl = 0.15;
cr_cube = 50;
cube_grip = 20;
cr_hook = 30;
carrier_front = 14;
alpha_pick = -9.788;
alpha_place = 25.468;
pivot_y = 10;
z_deck = 68;
base_t = 3;
