jhlr/robo-challenge/cad/braco/mdf/sheet_fundo_1.scad

translate([24.575, -63.000]) import("parts/back.dxf");
