jhlr/robo-challenge/cad/braco/mdf/sheet_moldura_1.scad

translate([41.000, 10.300]) import("parts/rear.dxf");
translate([116.000, 29.000]) import("parts/bridge.dxf");
translate([186.500, 29.000]) import("parts/cshelf.dxf");
translate([237.500, 0.500]) import("parts/stop.dxf");
