jhlr/robo-challenge/cad/braco/mdf/sheet_torres_1.scad

translate([17.000, 64.000]) import("parts/side.dxf");
translate([46.000, 64.000]) import("parts/side.dxf");
translate([81.000, 64.000]) import("parts/front.dxf");
