jhlr/robo-challenge/(list of files, cad)

Other CAD files:
arquivo/plotter_pecas_soltas/pecas_impressao_prontas/SUPORTE_LAPIS.stl
arquivo/ombro_sg90_berco/braco_mdf.scad
arquivo/ombro_sg90_berco/ombro_reducao.scad
cad/braco/braco.scad
cad/braco/braco_mdf.scad
old/ombro_sg90_berco/braco_mdf.scad
old/ombro_sg90_berco/ombro_reducao.scad
old/plotter_pecas_soltas/pecas_impressao_prontas/SUPORTE_LAPIS.stl
