jhlr/robo-challenge/cad/modelo_robo/preview_assembly.png

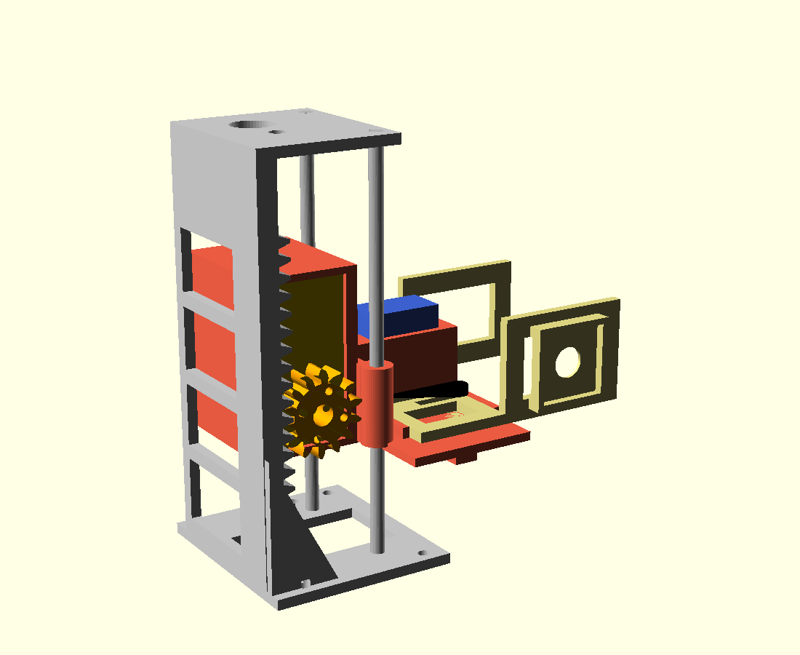
cad/modelo_robo/preview_assembly.png
