jhlr/robo-challenge/sim/results/opp_rate_0.0.csv

policy | score_mean | score_sem | delivered | identified | lost | wasted | miss_events
RandomWalk (sem memoria) | 870.0 | 45.3 | 4.84 | 7.84 | 0.6 | 84.2 | 0.0
Nearest, memoria decide | 970.5 | 57.4 | 5.98 | 7.61 | 0.8 | 50.6 | 0.2
Nearest, sensor decide | 883.5 | 50.4 | 5.45 | 6.93 | 0.8 | 31.8 | 0.1
Planner tau=INF, memoria decide | 671.2 | 47.7 | 3.82 | 5.9 | 0.58 | 70.1 | 0.1
Planner tau=INF, sensor decide | 629.4 | 42.7 | 3.53 | 5.64 | 0.56 | 50.6 | 0.0
Planner tau=60, memoria decide | 804.6 | 59.7 | 4.65 | 6.9 | 0.54 | 75.4 | 0.1
Planner tau=60, sensor decide | 801.1 | 60.3 | 4.66 | 6.82 | 0.59 | 45.8 | 0.1
Planner tau=30, sensor decide | 807.4 | 61.8 | 4.73 | 6.78 | 0.46 | 42.1 | 0.1
Planner tau=60, memoria decide, 30% crenca errada | 613.9 | 48.2 | 3.34 | 5.69 | 0.46 | 80.7 | 0.2
Planner tau=60, sensor decide, 30% crenca errada | 659.4 | 51.5 | 3.62 | 6.05 | 0.51 | 49.1 | 0.1
