jhlr/robo-challenge/sim/results/opp_rate_0.02.csv

policy | score_mean | score_sem | delivered | identified | lost | wasted | miss_events
RandomWalk (sem memoria) | 809.3 | 41.7 | 4.16 | 7.98 | 0.57 | 84.1 | 0.0
Nearest, memoria decide | 1046.3 | 61.0 | 6.44 | 8.19 | 0.72 | 52.0 | 0.1
Nearest, sensor decide | 900.6 | 47.3 | 5.47 | 7.21 | 0.69 | 25.9 | 0.1
Planner tau=INF, memoria decide | 746.9 | 50.8 | 4.21 | 6.65 | 0.66 | 72.9 | 0.1
Planner tau=INF, sensor decide | 726.8 | 43.9 | 4.13 | 6.4 | 0.62 | 46.2 | 0.0
Planner tau=60, memoria decide | 906.3 | 58.9 | 5.2 | 7.86 | 0.67 | 73.5 | 0.1
Planner tau=60, sensor decide | 928.5 | 54.1 | 5.34 | 8.01 | 0.6 | 42.2 | 0.1
Planner tau=30, sensor decide | 880.5 | 52.3 | 5.15 | 7.45 | 0.7 | 38.6 | 0.1
Planner tau=60, memoria decide, 30% crenca errada | 676.8 | 48.0 | 3.75 | 6.13 | 0.47 | 79.3 | 0.1
Planner tau=60, sensor decide, 30% crenca errada | 693.5 | 45.6 | 3.79 | 6.4 | 0.55 | 47.8 | 0.1
