jhlr/robo-challenge/sim/results/opp_rate_0.04.csv

policy | score_mean | score_sem | delivered | identified | lost | wasted | miss_events
RandomWalk (sem memoria) | 806.0 | 38.1 | 3.98 | 8.25 | 0.45 | 82.8 | 0.0
Nearest, memoria decide | 1021.5 | 56.3 | 6.32 | 7.94 | 0.75 | 51.6 | 0.1
Nearest, sensor decide | 988.6 | 49.7 | 6.08 | 7.76 | 0.74 | 25.2 | 0.1
Planner tau=INF, memoria decide | 855.8 | 54.1 | 5.04 | 7.17 | 0.67 | 62.6 | 0.1
Planner tau=INF, sensor decide | 770.8 | 47.6 | 4.47 | 6.6 | 0.62 | 39.7 | 0.0
Planner tau=60, memoria decide | 1035.3 | 59.5 | 6.11 | 8.66 | 0.87 | 67.2 | 0.1
Planner tau=60, sensor decide | 926.6 | 52.2 | 5.29 | 8.08 | 0.64 | 40.4 | 0.1
Planner tau=30, sensor decide | 964.3 | 51.8 | 5.71 | 8.04 | 0.87 | 35.5 | 0.1
Planner tau=60, memoria decide, 30% crenca errada | 809.7 | 46.7 | 4.55 | 7.2 | 0.53 | 73.1 | 0.1
Planner tau=60, sensor decide, 30% crenca errada | 757.6 | 44.6 | 4.15 | 6.98 | 0.64 | 44.9 | 0.1
