jhlr/robo-challenge/sim/results/opp_rate_0.08.csv

policy | score_mean | score_sem | delivered | identified | lost | wasted | miss_events
RandomWalk (sem memoria) | 912.7 | 30.8 | 4.58 | 9.21 | 0.58 | 70.8 | 0.0
Nearest, memoria decide | 1098.3 | 51.4 | 6.83 | 8.45 | 0.72 | 44.6 | 0.1
Nearest, sensor decide | 1053.2 | 43.7 | 6.63 | 7.97 | 0.83 | 22.4 | 0.1
Planner tau=INF, memoria decide | 1005.1 | 51.0 | 5.91 | 8.43 | 0.74 | 58.4 | 0.1
Planner tau=INF, sensor decide | 965.7 | 48.5 | 5.71 | 8.05 | 0.78 | 29.9 | 0.1
Planner tau=60, memoria decide | 1193.2 | 41.3 | 7.06 | 9.92 | 0.88 | 58.4 | 0.1
Planner tau=60, sensor decide | 1071.8 | 45.7 | 6.38 | 8.82 | 0.72 | 34.9 | 0.2
Planner tau=30, sensor decide | 1141.2 | 45.7 | 6.75 | 9.47 | 0.73 | 32.3 | 0.2
Planner tau=60, memoria decide, 30% crenca errada | 938.9 | 37.8 | 5.58 | 7.75 | 0.66 | 61.9 | 0.1
Planner tau=60, sensor decide, 30% crenca errada | 926.7 | 39.8 | 5.43 | 7.81 | 0.68 | 35.6 | 0.2
