jhlr/robo-challenge/firmware/src/seguidor/main.cpp

// Entry point of the SeguidorRC line follower on the STS car. The sketch lives in the SeguidorRC library's example (one owner of the follower
// logic); this file only lets PlatformIO build it on top of hal/ and core/.
#include <Arduino.h>

#include "../../SeguidorRC/examples/SeguidorBasico/SeguidorBasico.ino"
