jhlr/robo-challenge/firmware/src/core/localizer.h

#pragma once
// Pure logic (no Arduino.h): where is the robot on the street graph? A histogram (Bayes) filter over every junction and heading.
// The arena looks the same from most junctions (all 30 are 4-way), so one crossing says little; what tells places apart is the EDGE of the map:
// a street that ends after the last junction (the 127 mm stubs), the red border and the other team's blue line. Coordinates are relative to
// our side (map.h): c = 0 is the column next to the blue line we came in by, heading 0 = +c ("into the city").
//
// Events, in the order they happen on the track:
//   onGreenFloor(e)   green under the sensor: we are in our free area. If we did not expect it (we thought we were inside the city), the referee
//                     picked the robot up and put it back on the green (a restart): the pose is forgotten, the cube map is NOT (cubes stay put)
//   onOwnBlue()       we read the blue line of OUR green area: now at the gate, facing +c, row unknown (the stubs of the 5 rows look alike)
//   onCrossing()      a crossing was confirmed (8 sensors on black, then the 90 degree check): moved one junction ahead
//   onTurn(k)         the robot spun k quarter turns to the left (negative = right)
//   onLineEnd()       the line ended right after a junction (end of a stub)
//   onForbidden(kind) red under any sensor, or the other team's blue: both only exist beyond the last junction
// estimate() gives the best pose and how sure we are. Below a confidence bar the robot should not trust the map and go find an anchor.
#include <math.h>
#include <string.h>

#include "core/map.h"

namespace core {

constexpr int kHeadings = 4;  // 0 = +c, 1 = +r, 2 = -c, 3 = -r (a left turn adds 1)
constexpr int8_t kDirs[kHeadings][2] = {{1, 0}, {0, 1}, {-1, 0}, {0, -1}};

struct PoseBelief {
  float p[kMapCols][kMapRows][kHeadings];
  bool inGreen;  // in our green area, pose unknown (the start of every match, and after a restart)
  bool atGate;   // true between onOwnBlue() and the first crossing: still in the stub, p holds the row distribution at (0, r) facing +c
};

enum class Forbidden : uint8_t { Red, OtherBlue };

struct LocalizerModel {
  float pMissCrossing = 0.05f;      // a crossing went unnoticed: we moved two junctions, not one
  float pEndAtBoundary = 0.95f;     // line ends after a boundary junction facing out
  float pEndInterior = 0.03f;       // line "ends" in the middle of the map (gap in the tape, sensor glitch)
  float pForbiddenOutside = 0.95f;  // a forbidden colour is read only beyond the last junction
  float pForbiddenInside = 0.02f;
  float streetMm = 400.0f;          // centre to centre of two neighbouring junctions (the arena's measured pitch)
  float travelSigmaFrac = 0.12f;    // odometry error over one street, as a fraction of streetMm
  float phantomBelow = 0.5f;        // travelled less than this many streets: not a junction, a glitch on the tape
};

inline float totalMass(const PoseBelief& b) {
  float s = 0.0f;
  for (int c = 0; c < kMapCols; ++c)
    for (int r = 0; r < kMapRows; ++r)
      for (int h = 0; h < kHeadings; ++h) s += b.p[c][r][h];
  return s;
}

// Nothing known: every junction and heading equally likely.
inline void initUniform(PoseBelief& b) {
  const float v = 1.0f / (kMapCols * kMapRows * kHeadings);
  for (int c = 0; c < kMapCols; ++c)
    for (int r = 0; r < kMapRows; ++r)
      for (int h = 0; h < kHeadings; ++h) b.p[c][r][h] = v;
  b.inGreen = false;
  b.atGate = false;
}

// In the green area, nowhere on the street graph yet: the start of a match, or the robot was put back by the referee.
inline void initInGreen(PoseBelief& b) {
  memset(b.p, 0, sizeof(b.p));
  b.inGreen = true;
  b.atGate = false;
}

// Rescale to 1. If everything was ruled out the model and the world disagree (we are lost): start again from nothing and say so.
inline bool normalize(PoseBelief& b) {
  const float s = totalMass(b);
  if (s < 1e-9f) {
    initUniform(b);
    return false;
  }
  for (int c = 0; c < kMapCols; ++c)
    for (int r = 0; r < kMapRows; ++r)
      for (int h = 0; h < kHeadings; ++h) b.p[c][r][h] /= s;
  return true;
}

// Green under a sensor. `expected` = we were heading out through the gate on purpose (delivery trip). Returns true when this was a RESET:
// unexpected green means the robot was repositioned, so the pose goes back to "in the green, unknown".
inline bool onGreenFloor(PoseBelief& b, bool expected) {
  const bool reset = !expected && !b.inGreen;
  initInGreen(b);
  return reset;
}

inline void onOwnBlue(PoseBelief& b) {
  memset(b.p, 0, sizeof(b.p));
  b.inGreen = false;
  for (int r = 0; r < kMapRows; ++r) b.p[0][r][0] = 1.0f / kMapRows;
  b.atGate = true;
}

// Same as onOwnBlue() when the row is KNOWN (we lined up with it before crossing: rows are 400 mm apart, so a few tens of mm of error still pick the right one). `confidence` stays
// on that row and the rest shares the doubt, so a wrong guess is corrected by the next crossings instead of being locked in.
inline void onOwnBlueAtRow(PoseBelief& b, int row, float confidence) {
  memset(b.p, 0, sizeof(b.p));
  b.inGreen = false;
  const float rest = (1.0f - confidence) / (kMapRows - 1);
  for (int r = 0; r < kMapRows; ++r) b.p[0][r][0] = (r == row) ? confidence : rest;
  b.atGate = true;
}

inline void onTurn(PoseBelief& b, int leftQuarterTurns) {
  PoseBelief n;
  memset(&n, 0, sizeof(n));
  n.atGate = b.atGate;
  n.inGreen = b.inGreen;
  const int k = ((leftQuarterTurns % kHeadings) + kHeadings) % kHeadings;
  for (int c = 0; c < kMapCols; ++c)
    for (int r = 0; r < kMapRows; ++r)
      for (int h = 0; h < kHeadings; ++h) n.p[c][r][(h + k) % kHeadings] = b.p[c][r][h];
  b = n;
}

// True when the junction after (c, r) in direction h is outside the map.
inline bool facesOutside(int c, int r, int h) { return !inMap(c + kDirs[h][0], r + kDirs[h][1]); }

// Move every state one junction ahead with weight w1, two with weight w2 (a crossing went unnoticed). Facing outside at the edge cannot produce
// a crossing, so those states disappear: that is evidence too.
inline bool advance(PoseBelief& b, float w1, float w2) {
  PoseBelief n;
  memset(&n, 0, sizeof(n));
  for (int c = 0; c < kMapCols; ++c)
    for (int r = 0; r < kMapRows; ++r)
      for (int h = 0; h < kHeadings; ++h) {
        const float mass = b.p[c][r][h];
        if (mass <= 0.0f) continue;
        const int c1 = c + kDirs[h][0], r1 = r + kDirs[h][1];
        if (!inMap(c1, r1)) continue;
        n.p[c1][r1][h] += mass * w1;
        const int c2 = c1 + kDirs[h][0], r2 = r1 + kDirs[h][1];
        if (inMap(c2, r2)) n.p[c2][r2][h] += mass * w2;
      }
  n.atGate = false;
  n.inGreen = false;
  b = n;
  return normalize(b);
}

// A crossing arrived, distance unknown. The first one after the gate is the first junction itself (column 0); after that we moved one junction
// (two if one was missed, with the fixed prior pMissCrossing).
inline bool onCrossing(PoseBelief& b, const LocalizerModel& m = {}) {
  if (b.inGreen) return true;  // no pose to move
  if (b.atGate) {
    b.atGate = false;
    return true;
  }
  return advance(b, 1.0f - m.pMissCrossing, m.pMissCrossing);
}

// Same, with the distance the wheels covered since the previous crossing (core/odo.h mmForCounts). The distance decides between "one street"
// (~streetMm), "a crossing went unnoticed" (~2 streets) and "not a junction at all" (under phantomBelow streets: the pose does not move).
// Returns false only when the model and the world disagree (see normalize).
inline bool onCrossing(PoseBelief& b, float travelledMm, const LocalizerModel& m = {}) {
  if (b.inGreen || b.atGate) return onCrossing(b, m);  // no previous crossing to measure from
  const float streets = travelledMm / m.streetMm;
  if (streets < m.phantomBelow) return true;
  auto like = [&](float k) {
    const float z = (streets - k) / (m.travelSigmaFrac * k);   // error grows with the distance walked
    return expf(-0.5f * z * z) / k;
  };
  const float w1 = (1.0f - m.pMissCrossing) * like(1.0f);
  const float w2 = m.pMissCrossing * like(2.0f);
  const float s = w1 + w2;
  if (s < 1e-12f) return onCrossing(b, m);  // far from both: no distance information, fall back to the prior
  return advance(b, w1 / s, w2 / s);
}

// The street pitch is known, so every clean single street recalibrates the wheel scale (diameter x gear error): scale multiplies mmForCounts.
// Slow average, and only for a plausible street (within 15% of one pitch), so a missed or phantom crossing cannot drag it.
inline float refineWheelScale(float scale, float travelledMm, const LocalizerModel& m = {}, float rate = 0.2f) {
  const float measured = travelledMm * scale;
  if (fabsf(measured / m.streetMm - 1.0f) > 0.15f) return scale;
  return scale * (1.0f + rate * (m.streetMm / measured - 1.0f));
}

// Weight every state by how likely the reading is there, then rescale.
template <typename Likelihood>
inline bool weigh(PoseBelief& b, Likelihood&& like) {
  if (b.inGreen) return true;  // nothing to weigh
  for (int c = 0; c < kMapCols; ++c)
    for (int r = 0; r < kMapRows; ++r)
      for (int h = 0; h < kHeadings; ++h) b.p[c][r][h] *= like(c, r, h);
  return normalize(b);
}

inline bool onLineEnd(PoseBelief& b, const LocalizerModel& m = {}) {
  return weigh(b, [&](int c, int r, int h) { return facesOutside(c, r, h) ? m.pEndAtBoundary : m.pEndInterior; });
}

inline bool onForbidden(PoseBelief& b, Forbidden kind, const LocalizerModel& m = {}) {
  return weigh(b, [&](int c, int r, int h) {
    const bool outside = facesOutside(c, r, h);
    const bool rightEdge = (kind == Forbidden::Red) ? (h == 1 || h == 3) : (h == 0);
    return (outside && rightEdge) ? m.pForbiddenOutside : m.pForbiddenInside;
  });
}

// How sure we are about one coordinate alone. Walking along a street teaches the column but never the row (and the other way round), so the
// full pose can be unsure while one of these is firm.
inline float columnMass(const PoseBelief& b, int c) {
  float s = 0.0f;
  for (int r = 0; r < kMapRows; ++r)
    for (int h = 0; h < kHeadings; ++h) s += b.p[c][r][h];
  return s;
}

inline float rowMass(const PoseBelief& b, int r) {
  float s = 0.0f;
  for (int c = 0; c < kMapCols; ++c)
    for (int h = 0; h < kHeadings; ++h) s += b.p[c][r][h];
  return s;
}

struct Estimate {
  Pose pose;
  float confidence;  // probability of the best state (0..1)
};

inline Estimate estimate(const PoseBelief& b) {
  Estimate e{{{0, 0}, 1, 0}, 0.0f};
  if (b.inGreen) return e;  // confidence 0: no pose
  for (int c = 0; c < kMapCols; ++c)
    for (int r = 0; r < kMapRows; ++r)
      for (int h = 0; h < kHeadings; ++h)
        if (b.p[c][r][h] > e.confidence) {
          e.confidence = b.p[c][r][h];
          e.pose = Pose{{static_cast<int8_t>(c), static_cast<int8_t>(r)}, kDirs[h][0], kDirs[h][1]};
        }
  return e;
}

}  // namespace core
