jhlr/robo-challenge/firmware/SeguidorRC/src/seguidor/ponte_h.h

#pragma once
#include "decisao.h"

namespace seguidor {

// Pinos da ponte H TB6612FNG. Motor A = roda esquerda | Motor B = roda direita.
struct PinosPonteH {
  int ain1, ain2, pwma;
  int bin1, bin2, pwmb;
  int stby;
};

void iniciar(const PinosPonteH& pinos, int frequenciaPwmHz = 20000);   // 20 kHz: fora da faixa audivel

// Compensacao da assimetria dos motores (ver assimetria.h): o PWM de cada lado e multiplicado por este ganho (>= 1 no lado fraco, 1 no forte) e limitado em 255. Vale para todo mover().
struct CompensacaoMotores {
  float esq = 1.0f, dir = 1.0f;
};
void definirCompensacao(const CompensacaoMotores& compensacao);

// Velocidade -255 a 255, positivo = frente.
void mover(const PinosPonteH& pinos, int velEsq, int velDir);

// Ponte em repouso (IN1 = IN2 = LOW, PWM 0).
void parar(const PinosPonteH& pinos);

// Faz o que a decisao mandou.
void aplicar(const PinosPonteH& pinos, const Comando& comando);

}  // namespace seguidor
