jhlr/robo-challenge/firmware/SeguidorRC/examples/SeguidorBasico/SeguidorBasico.ino

// Seguidor de linha preta sem PID. ESP32 DevKit + 2 STS3215 (um por lateral, bus serial) + barra de 8 sensores RC.
// Compila pelo PlatformIO (env `seguidor`): a tracao e o hal/drive.* do firmware, nao existe mais ponte H. Monitor Serial a 115200.
//
// O loop e sempre: ler sensores -> (cruzamento?) -> decidir -> mexer motores.

#include <SeguidorRC.h>

#include <SCServo.h>

#include "../../../src/core/localizer.h"   // dono da pose no mapa: o sketch so avisa portao e cruzamento
#include "../../../src/hal/drive.h"        // dono das rodas STS (velocidade + odometria)
#include "../../../src/hal/sensors.h"      // dono do I2C (PCA9548), TCS34725, MPU6050 e ultrassom
#include "../../../include/params.h"       // canais do multiplexador
#include "../../../include/pins.h"         // pinos (barra, I2C, ultrassom, bus dos STS)

using namespace seguidor;

// --- Cor da linha (TCS34725 do chao): as ruas terminam numa linha VERMELHA (cima/baixo) ou AZUL (laterais). Ela acende S1 e S8 como um cruzamento,
// mas e a borda do mapa: nao se confirma girando, o robo da meia-volta e volta para dentro do mapa (ou, com cubo na mao, espera o navegador).
// Desligado ate ligar o sensor: troque para 1 (o TCS do chao fica no barramento Wire, pins.h). A tabela de cores e a do firmware principal (core/color_table.h): uma so, nao copie.
#define USA_COR 1
#if USA_COR
#include "../../../src/core/color_table.h"
hal::ColorSensor corChao;   // TCS34725 do chao: barramento I2C Wire (pins::kI2cSda/kI2cScl), sem multiplexador (hal/sensors.*)
core::Cor corAnterior = core::DESCONHECIDA, corAceita = core::DESCONHECIDA, corBruta = core::DESCONHECIDA;
#endif
MemoriaCor memCor;

// --- MPU6050 (inercial.h): REMOVIDO DO CARRO (hal::Imu e o multiplexador sairam de hal/sensors). Sem ele o rumo vem dos encoders dos STS e os giros de rua fecham na linha (o simulador
// ja faz isso: rumoenc=1, ver docs/2026-11-03_encoder-simulador.md); este sketch ainda nao. O bloco USA_IMU abaixo e codigo morto ate ser apagado ou refeito sem o MPU.
// Bitola/eixos: confira o sinal de kSinalGz (+ = anti-horario com o MPU de cabeca para cima) girando o robo a mao para a esquerda e olhando o rumo no Monitor Serial.
#ifndef USA_IMU
#define USA_IMU 0   // 1 quando o MPU estiver instalado (sem ele o setup espera o sensor para sempre)
#endif
#if USA_IMU
#error "USA_IMU=1 nao compila mais: o MPU6050 foi removido do carro (hal::Imu nao existe). Veja o comentario acima."
#include "../../../src/core/yaw.h"   // dono da integracao do giroscopio (viés + dt)
hal::Imu mpu;   // MPU6050: canal params::kMuxImu do PCA9548 (hal/sensors.*)
constexpr float kSinalGz = 1.0f;
// 1 = SO o MPU: setup mede o vies e para (sem calibrar motores nem a barra), loop so imprime rumo/giro/aceleracao; os motores nunca recebem comando. 0 = sketch completo.
#ifndef SO_TESTE_IMU
#define SO_TESTE_IMU 1
#endif
constexpr bool kCalibrarMotores = true;
AjustesInercial ajustesInercial;
Imu imu = {0.0f, 0.0f, 0.0f, 1.0f};
float rumo = 0.0f;                 // graus, + = esquerda, 0 = de frente para dentro da cidade (SEMPRE assim depois de levantado)
float viesGz = 0.0f;               // rad/s
float rumoAoPerder = 0.0f;
unsigned long ultimoImuMs = 0;
Ancora ancora;
Pickup pickup;
Tracao tracao;
Colisao colisao;
int reposicionamentos = 0;
#endif
constexpr unsigned long kJanelaCorMs = 400;   // a cor da borda vale por este tempo (o TCS pode estar a frente ou atras da barra)
bool temCubo = false;   // carregando um cubo para guardar: na borda nao da meia-volta, deixa para o navegador (ainda nao ligado)
bool parado = false;
bool portaoPendente = true;   // ainda nao passou pelo nosso portao azul (a primeira azul lida e a nossa)
unsigned long semReacaoAte = 0;   // depois de reagir a uma linha proibida (ou de passar o portao) espera a barra sair da faixa

// A cada ~60 ms (a leitura do TCS leva 24 ms: nao ler a cada volta do loop, a correcao precisa de ciclos curtos).
void lerCor() {
#if USA_COR
  static unsigned long ultima = 0;
  if (millis() - ultima < 60) return;
  ultima = millis();
  hal::ColorSample amostra;
  if (!corChao.read(amostra)) return;
  corBruta = core::classificarCor(amostra.r, amostra.g, amostra.b, amostra.c);
  corAceita = core::filtrarCor(corBruta, corAnterior, corAceita);   // so acredita se repetir em duas leituras
  anotarCor(memCor, corAceita == core::VERMELHO ? CorLinha::Vermelho : (corAceita == core::AZUL ? CorLinha::Azul : CorLinha::Outra), millis());
#endif
}

// --- Ligacao (S1 = ponta esquerda ... S8 = ponta direita; os pinos dos sensores precisam ser < 32) ---
// Barra montada ESPELHADA em relacao ao codigo do colega (confirmado pelo usuario em 2026-10-28): S1 (esquerda) e o pino 1 ... S8 (direita) e o pino 8.
// Barra QRE-8D: pinos em include/pins.h (pins::kLine, S1 = ponta esquerda ... S8 = ponta direita), uma fonte so.
const uint8_t pinosSensores[kSensores] = {pins::kLine[0], pins::kLine[1], pins::kLine[2], pins::kLine[3], pins::kLine[4], pins::kLine[5], pins::kLine[6], pins::kLine[7]};

// Rodas: os STS fecham a velocidade em malha fechada, entao nao ha zona morta nem assimetria de motor para compensar. O comando da decisao (-255..255) vira -1..1.
SMS_STS sts;
hal::StsDrive rodas(sts);
void mover(int esq, int dir) { rodas.setSpeeds(esq / 255.0f, dir / 255.0f); }
void parar() { rodas.setSpeeds(0.0f, 0.0f); }
void aplicar(const Comando& c) { if (c.parar) parar(); else mover(c.esq, c.dir); }

// Localizacao no mapa (core/localizer.h) com a odometria dos STS: distancia entre cruzamentos separa rua, cruzamento perdido e fantasma.
// O localizador ainda nao recebe onTurn (o navegador que decide as viradas nao esta ligado): vale em reta ate o primeiro desvio.
core::PoseBelief pose;
core::LocalizerModel modeloPose;
float escalaRoda = 1.0f;   // multiplica a odometria; refinada a cada rua limpa (core::refineWheelScale)

#ifndef USA_BLE
#define USA_BLE 1   // depuracao por Bluetooth LE (Nordic UART): console_ble.py, nRF Connect ou Serial Bluetooth Terminal (modo BLE)
#endif
#if USA_BLE
#include <seguidor/depuracao_ble.h>
#include <seguidor/ota_ble.h>
#ifndef OTA_SEGREDO
#define OTA_SEGREDO "troque-este-segredo"   // o mesmo em tools/ota_ble.py (--segredo): sem ele ninguem grava firmware por BLE
#endif
DepuracaoBLE ble;
OtaBLE ota;
Tee dbg(Serial, ble);   // tudo que o robo escreve vai ao Monitor Serial (USB) E ao Bluetooth
#else
Print& dbg = Serial;
#endif

bool kDebug = true;        // mostra sensores e decisao (comando "debug on/off")
bool kModoTeste = false;   // true = motores desligados, so mostra a decisao (comando "teste on/off")
bool telemetria = false;   // CSV ~10 Hz: tempo_ms,rumo,S1..S8,esq,dir (comando "tele on/off")
constexpr bool kParaNoCruzamento = true;   // S1 e S8 no preto juntos (acima das outras regras, ate perdido): para e varre 90 graus para cada lado
SaudeSensores saude;                              // sensor preto por mais de 30 s e marcado como ruim
unsigned long tUltimoCruzamento = 0;              // quando o ultimo cruzamento foi confirmado (para saber se a linha sumida e fim de beco)
bool fimDeBecoAvisado = false;

BarraRC barra;
Ajustes ajustes;     // velocidades e tempos: mude aqui, ex.: ajustes.velReto = 90;
Memoria memoria;
AjustesCruzamento ajustesCruzamento;   // confirma, saidaMs
AjustesGiroCruzamento ajustesGiro;     // giro de 90 graus para cada lado
MemoriaCruzamento cruzamento;
Exploracao exploracao;   // cruzamentos ja visitados (relativos a partida): vira para o lado menos explorado
int cruzamentos = 0;

#if USA_IMU
// Le o MPU e integra o rumo (com o vies medido parado, e corrigido nas retas).
void lerImu() {
  hal::ImuSample m;
  if (!mpu.read(m)) return;
  imu = {kSinalGz * m.gz, m.ax / 9.80665f, m.ay / 9.80665f, m.az / 9.80665f};
  const unsigned long agora = millis();
  rumo = core::integrateYaw(rumo, imu.gzRadS, viesGz, (agora - ultimoImuMs) / 1000.0f);
  ultimoImuMs = agora;
}
#endif

// --- Ultrassom HC-SR04 (alvo.h): pronto e DESLIGADO ate o sensor existir. Na varredura das duas pontas ele le o eco ao longo de cada rua (cubo na rua = eco menor que ~330 mm).
// Ligue com -DUSA_ULTRASSOM=1 (pinos em pins.h: trig 14, echo 12; o ECHO do HC-SR04 e 5 V: use divisor para 3,3 V). O TCS34725 da frente (cor do cubo) e o canal params::kMuxFrontRgb
// (core/color_table.h classifica); a logica de coleta e do navegador (ainda so no simulador: test/simulador.cpp).
#ifndef USA_ULTRASSOM
#define USA_ULTRASSOM 1
#endif
#if USA_ULTRASSOM
hal::Ultrasonic sonar;   // pins::kTrig / pins::kEcho
// Distancia em mm ate o eco a frente (-1 = sem eco ate ~1,5 m). Bloqueia ate 9 ms no pior caso.
float lerUltrassomMm() {
  const uint16_t mm = sonar.readMm(9000);
  return mm == 0xFFFF ? -1.0f : mm;
}
#else
float lerUltrassomMm() { return -1.0f; }
#endif

void mostrarDebug(const Comando& c) {
  for (int i = 0; i < kSensores; i++) dbg.printf("S%d:%4u ", i + 1, barra.leituras[i]);
  dbg.print("| [");
  for (int i = 0; i < kSensores; i++) dbg.print(!barra.ok[i] ? 'x' : (barra.preto[i] ? '#' : '.'));
  dbg.printf("]  %s%s%s\n", c.acao, c.estranho ? "  [ESTRANHO: S1 e S8 deviam acender juntos]" : "",
                c.oscilando ? "  [OSCILANDO]" : "");
}

// Varredura das duas pontas acesas: 90 graus para um lado, 90 para o outro, e volta. A velocidade e a da busca (velBuscaExterna) e o
// angulo e ESTIMADO por tempo (grausPorSegundoBusca): nao ha referencia na pista, entao a janela de "90 graus" e larga (giro_cruzamento.h).
// A 90 graus a barra fica ao longo da rua do lado: algum sensor aceso = a rua existe. Nao depende da largura da linha.
constexpr int kMaxAmostras = 2400;
AmostraGiro amostras[kMaxAmostras];

int acesos() {
  int n = 0;
  for (int i = 0; i < kSensores; i++) n += barra.preto[i] ? 1 : 0;
  return n;
}

// Gira no eixo ate o angulo estimado chegar em `alvo` (+ = esquerda), lendo a barra a cada passo. Devolve o angulo estimado em que parou.
float girarAte(float agora, float alvo, int& n) {
  const bool paraEsquerda = alvo > agora;
#if USA_IMU
  const float rumoRef = rumo - agora;   // angulo pelo giroscopio, a partir de onde comecou
#endif
  const int v = ajustes.velBuscaExterna;
  mover(paraEsquerda ? -v : v, paraEsquerda ? v : -v);   // rodas em sentidos opostos
#if !USA_IMU
  unsigned long t0 = micros();
#endif
  const unsigned long inicio = millis();
  while ((paraEsquerda ? agora < alvo : agora > alvo) && millis() - inicio < 3000) {
    ler(barra);
#if USA_IMU
    lerImu();
    agora = rumo - rumoRef;
#else
    const unsigned long t1 = micros();
    const float passo = ajustes.grausPorSegundoBusca * (t1 - t0) * 1e-6f;
    agora += paraEsquerda ? passo : -passo;
    t0 = t1;
#endif
    if (n < kMaxAmostras) amostras[n++] = {agora, barra.preto[0], barra.preto[kSensores - 1], acesos()};
  }
  parar();
  return agora;
}

// Rege a varredura de 90 graus (giro_cruzamento.h, a maquina de estados e da biblioteca; aqui so se alimentam leituras e motores).
// Devolve o que as duas pontas acesas eram: Cruzamento, Endireitou (estava perdido de lado em cima da linha) ou FalsoAlarme.
Oito varrer(bool vinhaSeguindo, int lado) {
  Varredura v;
  iniciarVarredura(v, lado, vinhaSeguindo);
  float estimado = 0.0f;
#if USA_IMU
  const float rumo0 = rumo;
#endif
  AmostraGiro leitura = {0.0f, barra.preto[0], barra.preto[kSensores - 1], acesos(), lerUltrassomMm()};   // como chegou
#if !USA_IMU
  unsigned long t0 = micros();
#endif
  const unsigned long inicio = millis();
  while (millis() - inicio < 20000) {
    const ComandoVarredura k = passoVarredura(v, leitura, millis(), ajustes.velBuscaExterna, ajustesGiro, amostras, kMaxAmostras);
    if (k.terminou) break;
    mover(k.esq, k.dir);
    ler(barra);
#if USA_IMU
    lerImu();
    estimado = rumo - rumo0;   // angulo pelo giroscopio
#else
    const unsigned long t1 = micros();
    estimado += (k.dir > k.esq ? 1 : -1) * ajustes.grausPorSegundoBusca * (t1 - t0) * 1e-6f;   // angulo estimado por tempo
    t0 = t1;
#endif
    leitura = {estimado, barra.preto[0], barra.preto[kSensores - 1], acesos(), lerUltrassomMm()};
  }
  parar();
  auto rua = [](int x) { return x < 0 ? "?" : (x ? "SIM" : "nao"); };
  dbg.printf("    1o lado: %s | rua a esquerda: %s | rua a direita: %s | %d amostras\n", lado > 0 ? "esquerda" : "direita", rua(v.ruas.ruaEsquerda), rua(v.ruas.ruaDireita), v.n);
  if (v.ruas.usEsq > 0 || v.ruas.usDir > 0 || v.ruas.usFrente > 0) dbg.printf("    ultrassom: esquerda %.0f mm | frente %.0f mm | direita %.0f mm (-1 = nada)\n", v.ruas.usEsq, v.ruas.usFrente, v.ruas.usDir);
  return v.resultado;
}

// S1 e S8 no preto numa linha vermelha ou azul: borda do mapa, nao cruzamento (nada para confirmar girando).
void bordaDoMapa(AcaoCruzamento acao) {
  if (acao == AcaoCruzamento::Portao) {
    dbg.println(">>> PORTAO azul (nosso): segue em frente");
    portaoPendente = false;
    core::onOwnBlue(pose);   // portao: coluna 0, de frente para dentro, linha desconhecida
    rodas.resetTravel();
    semReacaoAte = millis() + 1500;   // ainda em cima da faixa azul do portao
    esquecerCor(memCor);
    esquecerUltimoComando(memoria);
    tUltimoCruzamento = millis();
    comecarASair(cruzamento, millis());
    return;
  }
  if (acao == AcaoCruzamento::Navegador) {
    dbg.println(">>> BORDA com cubo: parado, a rota e do navegador (ainda nao ligado)");
    parado = true;
    return;
  }
  dbg.println(">>> BORDA do mapa (linha vermelha/azul): meia-volta para voltar ao mapa");
  int n = 0;
  girarAte(0.0f, 180.0f, n);
  esquecerCor(memCor);   // a linha que ficou atras nao conta para o proximo cruzamento
  esquecerUltimoComando(memoria);
  tUltimoCruzamento = millis();
  fimDeBecoAvisado = false;
  cruzamento = MemoriaCruzamento{};   // depois dos 180 graus a barra nao esta mais na faixa da borda: o cruzamento do beco (a 127 mm) precisa ser detectado, o debounce de 300 ms o engolia
}

// Cruzamento confirmado: a distancia que as rodas fizeram desde o anterior (ou desde o portao) entra no localizador. Depois do portao a distancia nao e de uma rua: nao calibra a roda.
void atualizarPose() {
  const float brutoMm = rodas.forwardMm();
  const bool primeiro = pose.atGate;
  core::onCrossing(pose, brutoMm * escalaRoda, modeloPose);
  if (!primeiro) escalaRoda = core::refineWheelScale(escalaRoda, brutoMm, modeloPose);
  rodas.resetTravel();
  const core::Estimate e = core::estimate(pose);
  dbg.printf("    pose: coluna %d linha %d (%.0f%%) | %.0f mm desde o anterior | escala da roda %.3f\n", e.pose.at.c, e.pose.at.r, e.confidence * 100.0f, brutoMm * escalaRoda, escalaRoda);
}

// As duas pontas acesas (S1 e S8), ACIMA DE TODAS AS OUTRAS REGRAS, em qualquer situacao (inclusive perdido/buscando): para e varre 90 graus, comecando pelo
// lado MENOS EXPLORADO do mapa (rumo do MPU + cruzamentos ja visitados). Seguindo a linha: cruzamento se ha rua dos dois lados. Perdido: era ele de lado em cima da
// linha; se ficou estreito depois de virar, endireitou e segue por ela. A decisao de qual rua seguir sera do navegador (ainda nao ligado aqui).
void pararNoCruzamento() {
  parar();
  const AcaoCruzamento acao = acaoNaPonta(corRecente(memCor, millis(), kJanelaCorMs), temCubo, portaoPendente);
  if (acao != AcaoCruzamento::Cruzamento) { bordaDoMapa(acao); return; }
  if (kModoTeste) { dbg.println(">>> S1 e S8 no preto (modo teste: nao gira)"); comecarASair(cruzamento, millis()); return; }

  const bool vinhaSeguindo = vinhaSeguindoLinha(memoria, millis(), ajustes);
#if USA_IMU
  const int lado = ladoMenosExplorado(exploracao, rumo, true, memoria.ultimoLado);
#else
  const int lado = ladoMenosExplorado(exploracao, 0.0f, false, memoria.ultimoLado);   // sem MPU nao ha bussola: lado da ultima correcao
#endif
  const Oito oito = varrer(vinhaSeguindo, lado);
  if (oito == Oito::Cruzamento) {
    cruzamentos++;
    atualizarPose();
#if USA_IMU
    registrarCruzamento(exploracao, rumo);
#endif
    dbg.printf(">>> CRUZAMENTO %d CONFIRMADO\n", cruzamentos);
  } else if (oito == Oito::Endireitou) {
    dbg.println(">>> ENDIREITOU: estava de lado em cima da linha, agora segue por ela");
    memoria.perdeuEm = 0;
  } else {
    dbg.println("    falso alarme");
  }
  esquecerUltimoComando(memoria);
  if (oito == Oito::Endireitou) memoria.perdeuEm = 0;
  tUltimoCruzamento = millis();
  fimDeBecoAvisado = false;
  comecarASair(cruzamento, millis());   // o relogio de saida comeca agora, quando volta a andar
}

// --- Comandos recebidos por Bluetooth (uma linha cada). "ajuda" lista. ---

void mostrarAjustes() {
  dbg.printf("velReto=%d velCorrecaoLeve=%d velCorrecaoForte=%d zonaMortaPwm=%d periodoCorrecaoMs=%lu\n", ajustes.velReto, ajustes.velCorrecaoLeve, ajustes.velCorrecaoForte, ajustes.zonaMortaPwm, ajustes.periodoCorrecaoMs);
}

// Teste das rodas (comando `roda`): so com o robo parado, ideal com as rodas no ar. Gira por 1 s e diz o que a odometria do hal (StsDrive) viu.
// forwardMm() > 0 = a roda anda para frente; spinDeg() > 0 = o robo gira para a direita. Os mm usam kGearRatio/kTrackMm CHUTADOS: o sinal vale, a grandeza nao.
void testarRodas(const char* nome, float esq, float dir) {
  rodas.resetTravel();
  rodas.setSpeeds(esq, dir);
  delay(1000);
  parar();
  delay(150);
  const float mm = rodas.forwardMm(), graus = rodas.spinDeg();
  if (mm == 0.0f && graus == 0.0f) { dbg.printf("%s: sem leitura dos STS (nao andou ou o barramento 16/17 nao responde)\n", nome); return; }
  dbg.printf("%s: media %.0f mm, giro %.0f graus (%s)\n", nome, mm, graus,
             esq == dir ? (mm > 0 ? "frente: sinais certos" : "RE: inverta os DOIS sinais (kLeftSign e kRightSign)")
                        : (graus > 0 ? "robo gira para a direita" : "robo gira para a esquerda"));
}

void aoReceberComando(const String& linha) {
  String l = linha;
  l.trim();
  l.toLowerCase();
  const int sp = l.indexOf(' ');
  const String cmd = sp < 0 ? l : l.substring(0, sp);
  const String arg = sp < 0 ? "" : l.substring(sp + 1);
  if (cmd == "ajuda" || cmd == "h" || cmd == "?") {
    dbg.println("comandos: estado | parar | seguir | teste on/off | debug on/off | tele on/off | ajustes | ajuste <nome> <valor>");
    dbg.println("          roda esq|dir|ambas|giro (1 s a 30%, so parado, de preferencia com as rodas no ar)");
    dbg.println("          zerar (rumo=0) | nomes: velReto velCorrecaoLeve velCorrecaoForte zonaMortaPwm periodoCorrecaoMs");
  } else if (cmd == "estado") {
    dbg.printf("t=%lu ms | %s | teste=%d debug=%d tele=%d | cruzamentos=%d | portaoPendente=%d\n", millis(), parado ? "PARADO" : "andando", kModoTeste, kDebug, telemetria, cruzamentos, portaoPendente);
#if USA_IMU
    dbg.printf("rumo=%.1f graus | vies gz=%.4f rad/s\n", rumo, viesGz);
#endif
    mostrarAjustes();
  } else if (cmd == "parar") { parado = true; parar(); dbg.println("ok: parado");
  } else if (cmd == "roda") {
    if (!parado) { dbg.println("mande 'parar' antes (o loop do seguidor brigaria com o teste)"); return; }
    if (arg == "esq") testarRodas("esquerda sozinha", 0.3f, 0.0f);
    else if (arg == "dir") testarRodas("direita sozinha", 0.0f, 0.3f);
    else if (arg == "ambas") testarRodas("as duas", 0.3f, 0.3f);
    else if (arg == "giro") testarRodas("esquerda frente, direita re", 0.3f, -0.3f);
    else dbg.println("uso: roda esq | dir | ambas | giro");
  } else if (cmd == "seguir") { parado = false; dbg.println("ok: andando");
  } else if (cmd == "teste") { kModoTeste = arg == "on"; dbg.printf("ok: modo teste %s\n", kModoTeste ? "ligado (motores desligados)" : "desligado");
  } else if (cmd == "debug") { kDebug = arg == "on"; dbg.printf("ok: debug %s\n", kDebug ? "ligado" : "desligado");
  } else if (cmd == "tele") { telemetria = arg == "on"; if (telemetria) dbg.println("t_ms,rumo,S1,S2,S3,S4,S5,S6,S7,S8,esq,dir"); dbg.printf("ok: telemetria %s\n", telemetria ? "ligada" : "desligada");
  } else if (cmd == "ajustes") { mostrarAjustes();
  } else if (cmd == "zerar") {
#if USA_IMU
    rumo = 0.0f; dbg.println("ok: rumo = 0");
#else
    dbg.println("sem IMU neste build");
#endif
  } else if (cmd == "ajuste") {
    const int sp2 = arg.indexOf(' ');
    if (sp2 < 0) { dbg.println("uso: ajuste <nome> <valor>"); return; }
    const String nome = arg.substring(0, sp2);
    const long v = arg.substring(sp2 + 1).toInt();
    if (nome == "velreto") ajustes.velReto = v;
    else if (nome == "velcorrecaoleve") ajustes.velCorrecaoLeve = v;
    else if (nome == "velcorrecaoforte") ajustes.velCorrecaoForte = v;
    else if (nome == "zonamortapwm") ajustes.zonaMortaPwm = v;
    else if (nome == "periodocorrecaoms") ajustes.periodoCorrecaoMs = v;
    else { dbg.println("nome desconhecido (veja: ajuda)"); return; }
    dbg.print("ok: "); mostrarAjustes();
  } else {
    dbg.printf("comando desconhecido: '%s' (ajuda)\n", cmd.c_str());
  }
}

void setup() {
  Serial.begin(115200);
#if USA_BLE
  ble.iniciar("SeguidorRC", aoReceberComando);
  ota.iniciar(ble.servidor(), OTA_SEGREDO);   // PRIMEIRO no setup: um firmware que chega aqui ainda pode ser atualizado
  ble.anunciar();
#endif
  hal::beginStsBus(sts);
  rodas.begin();
  dbg.printf("STS esquerda (id %u): %s | direita (id %u): %s\n", params::kIdLeft, sts.Ping(params::kIdLeft) >= 0 ? "responde" : "SEM RESPOSTA",
             params::kIdRight, sts.Ping(params::kIdRight) >= 0 ? "responde" : "SEM RESPOSTA");   // -1 = fiacao, jumper A ou alimentacao dos servos
  core::initInGreen(pose);
  ajustes.zonaMortaPwm = 0;   // STS nao tem zona morta (velocidade em malha fechada): normalizar() nao levanta nada
  ajustes.folgaZonaPwm = 0;
  iniciar(barra, pinosSensores);
#if USA_ULTRASSOM
  sonar.begin();
#endif
#if USA_COR
  hal::beginBuses();
  if (!corChao.begin(Wire)) dbg.println("!!! TCS34725 nao respondeu: sem leitura de cor (a borda sera tratada como cruzamento)");
#endif

#if USA_IMU
  while (!mpu.begin()) { dbg.println("!!! MPU6050 nao respondeu, tentando de novo..."); delay(1000); }
  dbg.println("Medindo o vies do giroscopio: nao mexa no robo (1 s)");
  core::GyroBias vies;
  for (int i = 0; i < 200; i++) {
    hal::ImuSample m;
    if (mpu.read(m)) core::addStillSample(vies, kSinalGz * m.gz);
    delay(5);
  }
  viesGz = vies.bias();
  ultimoImuMs = millis();
#if SO_TESTE_IMU
  parar();
  dbg.println("TESTE SO DO MPU: motores desligados. Gire o robo a mao: rumo (graus, + = esquerda), giro (graus/s), aceleracao (g).");
  return;
#endif
  if (kCalibrarMotores) {   // gira no eixo ate o giroscopio acusar: zona morta e graus por segundo de verdade
    Calibracao cal;
    AjustesCalibracao ac;
    // mede os graus por segundo numa velocidade RAPIDA (ac.velMedida, 140): e a que passa a ser a da busca, e procurar mais rapido acha mais e antes
    ComandoCalibracao k;
    do {
      lerImu();
      k = passoCalibracao(cal, imu.gzRadS - viesGz, millis(), ac);
      mover(k.esq, k.dir);
      delay(5);
    } while (!k.terminou);
    parar();
    if (cal.fase == Calibracao::Pronto) {
      ajustes.zonaMortaPwm = cal.zonaMortaPwm;
      ajustes.velBuscaExterna = cal.velMedida;   // a velocidade em que os graus por segundo foram medidos
      ajustes.grausPorSegundoBusca = cal.grausPorSegundo;
      dbg.printf("Calibracao dos motores: zona morta %d, giro %.0f graus/s a PWM %d\n", cal.zonaMortaPwm, cal.grausPorSegundo, cal.velMedida);
    } else {
      dbg.println("!!! Calibracao dos motores falhou (o robo nao girou): usando os valores padrao");
    }
  }
  ajustes.lacunaMs = 450;   // a lacuna agora segura o rumo pelo giroscopio, pode ser maior
  rumo = 0.0f;              // posto de frente, apontando para dentro da cidade
#endif
  ajustes = normalizar(ajustes);
  delay(1000);
  // Nao anda com sensores demais mortos (GPIO so de entrada): o carro rodopiava
  if (!aplicarLimiar(barra, Serial)) {
    dbg.println("!!! Poucos sensores vivos na barra: parado.");
    while (true) delay(1000);
  }
  delay(2000);   // tempo para colocar o robo na linha
}

void loop() {
#if USA_BLE
  ble.atualizar();
  ota.atualizar();
  if (ota.ativo()) { parar(); return; }   // atualizando o firmware: robo parado
#endif
#if SO_TESTE_IMU
  static unsigned long ultimoPrintMs = 0;
  lerImu();
  if (millis() - ultimoPrintMs >= 200) {
    ultimoPrintMs = millis();
    dbg.printf("rumo=%7.1f graus | giro=%7.1f graus/s | acel x=%5.2f y=%5.2f z=%5.2f g\n", rumo, (imu.gzRadS - viesGz) * 57.29578f, imu.ax, imu.ay, imu.az);
  }
  return;
#endif
  if (parado) { parar(); return; }
  ler(barra);
  lerCor();
#if USA_COR
  // Regras 7: "responder de forma imediata sempre que QUALQUER sensor detectar vermelho no chao". Vermelho (limite da cidade) e azul fora do portao (area do outro lado) NUNCA sao
  // rota: os sensores RC leem essas linhas como preto e o carro as seguia como uma rua. Uma leitura crua vale se alguma ponta da barra ve preto; sozinha, a leitura filtrada.
  {
    bool algum = false;
    for (int i = 0; i < kSensores; i++) algum = algum || barra.preto[i];
    const core::Cor viu = algum ? corBruta : corAceita;
    if (millis() >= semReacaoAte && (viu == core::VERMELHO || (viu == core::AZUL && !portaoPendente))) {
      parar();
      bordaDoMapa(temCubo ? AcaoCruzamento::Navegador : AcaoCruzamento::MeiaVolta);
      semReacaoAte = millis() + 1500;
      return;
    }
  }
#endif
#if USA_IMU
  lerImu();
  const EventoPostura evento = atualizarPickup(pickup, imu, millis(), ajustesInercial);
  if (evento == EventoPostura::FoiLevantado) { parar(); dbg.println(">>> LEVANTADO: motores parados"); }
  if (evento == EventoPostura::Reposicionado) {
    // Depois de levantado ele e SEMPRE posto em algum lugar do verde, apontando para frente: rumo 0, pose desconhecida (o mapa de cubos fica).
    // O localizador (core/localizer.h, initInGreen) tem de receber o mesmo reset quando for ligado aqui.
    reposicionamentos++;
    rumo = 0.0f;
    memoria = Memoria{};
    cruzamento = MemoriaCruzamento{};
    exploracao = Exploracao{};
    ancora = Ancora{};
    tracao = Tracao{};
    esquecerCor(memCor);
    tUltimoCruzamento = 0;
    portaoPendente = true;   // vai entrar de novo pelo nosso portao
    core::initInGreen(pose);
    dbg.printf(">>> REPOSICIONADO (%d): rumo 0, de frente\n", reposicionamentos);
  }
  if (!motoresLiberados(pickup)) { parar(); return; }
  if (colisaoDetectada(colisao, imu, true, millis(), ajustesInercial)) dbg.printf(">>> COLISAO forte (pico %.1f g)\n", colisao.picoG);
#endif
  const int travados = atualizarSaude(barra.preto, millis(), saude, barra.ok);
  if (travados > 0) dbg.printf("!!! %d sensor(es) no preto ha mais de 30 s: marcado(s) como ruim(ns) e ignorado(s)\n", travados);
  // Procurando a linha, S1 e S8 acesos nao sao cruzamento: a barra acende inteira ao ficar paralela a linha (robo de lado)
  // Acima de todas as outras regras: as duas pontas acesas valem ate perdido/buscando
  if (kParaNoCruzamento && cruzamentoConfirmado(barra.preto, millis(), ajustesCruzamento, cruzamento)) {
    pararNoCruzamento();
    return;
  }
#if USA_IMU
  const unsigned long perdeuAntes = memoria.perdeuEm;
#endif
  Comando c = decidir(barra.preto, millis(), ajustes, memoria);
#if USA_IMU
  if (memoria.perdeuEm != 0 && perdeuAntes == 0) rumoAoPerder = rumo;
  if ((memoria.ultimoEsq != 0 || memoria.ultimoDir != 0) && memoria.perdeuEm != 0 && millis() - memoria.perdeuEm < ajustes.lacunaMs) segurarRumoNaLacuna(c, rumo, rumoAoPerder, ajustes, ajustesInercial);
  if (ancorarNaGrade(rumo, viesGz, imu.gzRadS, ehReto(c), millis(), ancora, ajustesInercial)) dbg.println("!!! rumo suspeito: longe de um multiplo de 90 numa reta");
  const bool comandando = abs(c.esq) >= ajustes.zonaMortaPwm || abs(c.dir) >= ajustes.zonaMortaPwm;
  const AcaoTracao tr = atualizarTracao(tracao, imu, comandando && !c.parar, millis(), ajustesInercial);
  if (tr == AcaoTracao::Reforcar) dbg.printf(">>> andando menos que o esperado: reforco de PWM %d\n", tracao.reforco);
  if (tr == AcaoTracao::Recuar) {
    dbg.println(">>> TRAVADO mesmo com reforco: recua um pouco");
    mover(-ajustes.velReto, -ajustes.velReto);
    delay(300);
    parar();
    tracao.reforco = 0;
    return;
  }
  aplicarReforco(c, tracao.reforco);
#endif

  // A linha sumiu: falha curta, fim de beco (a rua acabou no limite do mapa) ou perdida? O fim de beco e evidencia de borda.
  const unsigned long perdidoHa = memoria.perdeuEm ? millis() - memoria.perdeuEm : 0;
  if (!fimDeBecoAvisado && tUltimoCruzamento &&
      classificarPerda(perdidoHa, millis() - tUltimoCruzamento, ajustes.lacunaMs, ajustesCruzamento) == Perda::FimDeBeco) {
    fimDeBecoAvisado = true;
    dbg.println(">>> FIM DE BECO: a linha acabou onde o beco termina (borda do mapa)");
  }
  aplicar(c);

  if (kModoTeste) {
    parar();
    esquecerUltimoComando(memoria);
  }

  static unsigned long ultimaTele = 0;
  if (telemetria && millis() - ultimaTele >= 100) {
    ultimaTele = millis();
#if USA_IMU
    const float r = rumo;
#else
    const float r = 0.0f;
#endif
    dbg.printf("%lu,%.1f,", millis(), r);
    for (int i = 0; i < kSensores; i++) dbg.printf("%u,", barra.leituras[i]);
    dbg.printf("%d,%d\n", c.esq, c.dir);
  }
  static unsigned long ultimoPrint = 0;
  if (kDebug && millis() - ultimoPrint > 150) {
    ultimoPrint = millis();
    mostrarDebug(c);
  }
}
