jhlr/robo-challenge/firmware/test/test_core/test_core.cpp

#include <unity.h>

#include <string>
#include "core/arm.h"
#include "core/pickplace.h"
#include "core/belief.h"
#include "core/color.h"
#include "core/color_table.h"
#include "core/explore.h"
#include "core/line.h"
#include "core/localizer.h"
#include "core/map.h"
#include "core/navigator.h"
#include "core/odo.h"
#include "core/pid.h"
#include "core/turn.h"
#include "core/yaw.h"
#include "params.h"

void setUp() {}
void tearDown() {}

void test_line_centered() {
  const float v[5] = {0, 0, 1, 0, 0};
  const core::LineState s = core::readLine(v, 5);
  TEST_ASSERT_FLOAT_WITHIN(1e-4f, 0.0f, s.pos);
  TEST_ASSERT_FALSE(s.lost);
  TEST_ASSERT_FALSE(s.junction);
}

void test_line_left_is_negative() {
  const float v[5] = {1, 0, 0, 0, 0};
  TEST_ASSERT_FLOAT_WITHIN(1e-4f, -1.0f, core::readLine(v, 5).pos);
}

void test_line_between_two_sensors() {
  const float v[5] = {0, 0, 1, 1, 0};
  TEST_ASSERT_FLOAT_WITHIN(1e-4f, 0.25f, core::readLine(v, 5).pos);
}

void test_line_lost_and_junction() {
  const float none[5] = {0, 0, 0, 0, 0};
  TEST_ASSERT_TRUE(core::readLine(none, 5).lost);
  const float all[5] = {1, 1, 1, 1, 1};
  TEST_ASSERT_TRUE(core::readLine(all, 5).junction);
  const float four[5] = {1, 1, 1, 1, 0};
  TEST_ASSERT_TRUE(core::readLine(four, 5).junction);
  const float three[5] = {0, 1, 1, 1, 0};
  TEST_ASSERT_FALSE(core::readLine(three, 5).junction);
}

void test_pid_sign_and_clamp() {
  core::Pid p(1.0f, 0.0f, 0.0f, 0.5f);
  TEST_ASSERT_FLOAT_WITHIN(1e-4f, 0.3f, p.step(0.3f, 0.01f));
  TEST_ASSERT_FLOAT_WITHIN(1e-4f, -0.5f, p.step(-2.0f, 0.01f));
}

void test_pid_no_integral_when_ki_zero() {
  core::Pid p(1.0f, 0.0f, 0.0f, 1.0f);
  for (int i = 0; i < 1000; ++i) p.step(1.0f, 0.01f);
  TEST_ASSERT_EQUAL_FLOAT(0.0f, p.integ);
}

void test_pid_derivative_filter_tames_a_step() {
  core::Pid raw(0.0f, 0.0f, 0.12f, 2.0f), filt(0.0f, 0.0f, 0.12f, 2.0f);
  filt.dTau = 0.1f;
  raw.step(0.0f, 0.004f);
  filt.step(0.0f, 0.004f);
  const float spikeRaw = raw.step(0.29f, 0.004f);    // one sensor step at a few ms per tick
  const float spikeFilt = filt.step(0.29f, 0.004f);
  TEST_ASSERT_FLOAT_WITHIN(1e-3f, 2.0f, spikeRaw);   // raw D hits the clamp
  TEST_ASSERT_TRUE(spikeFilt < 0.5f);
}

void test_routes_from_outside_the_map_is_all_unreachable() {
  core::Routes r;
  core::routesFrom(core::Node{-1, 2}, nullptr, nullptr, r);
  TEST_ASSERT_FALSE(core::reachable(r, core::Node{0, 2}));
  TEST_ASSERT_FALSE(core::reachable(r, core::Node{-1, 2}));
}

void test_first_step_to_unreachable_target_stays_put() {
  core::Routes r;
  core::Blocked b;
  core::clearBlocked(b);
  for (int rr = 0; rr < core::kMapRows; ++rr) b.east[0][rr] = true;   // wall between column 0 and 1
  core::routesFrom(core::Node{0, 0}, nullptr, &b, r);
  const core::Node s = core::firstStepTo(r, core::Node{0, 0}, core::Node{3, 3});
  TEST_ASSERT_EQUAL(0, s.c);
  TEST_ASSERT_EQUAL(0, s.r);
}

void test_color_table_rejects_ambiguous_dim_colours() {
  // halfway between the VERDE and AZUL references: both are close, neither clearly wins
  const core::RefCor& g = core::kCoresRef[core::VERDE];
  const core::RefCor& a = core::kCoresRef[core::AZUL];
  TEST_ASSERT_EQUAL(core::DESCONHECIDA, core::classificarCor((g.r + a.r) / 2, (g.g + a.g) / 2, (g.b + a.b) / 2, (g.c + a.c) / 2));
}

void test_wrap_delta() {
  TEST_ASSERT_EQUAL_INT(10, core::wrapDelta(4090, 4));
  TEST_ASSERT_EQUAL_INT(-10, core::wrapDelta(4, 4090));
  TEST_ASSERT_EQUAL_INT(100, core::wrapDelta(500, 600));
}

void test_spin_counts() {
  // track 100, wheel 66, ratio 1: arc = 100*pi/4 = 78.54 mm -> 78.54/207.35*4096 = 1551
  TEST_ASSERT_INT_WITHIN(2, 1551, core::countsForSpin(90.0f, 100.0f, 66.0f, 1.0f));
  TEST_ASSERT_INT_WITHIN(4, 3102, core::countsForSpin(180.0f, 100.0f, 66.0f, 1.0f));
}

void test_color_classes() {
  TEST_ASSERT_EQUAL(core::Floor::Black, core::classify(10, 10, 10, 100));
  TEST_ASSERT_EQUAL(core::Floor::White, core::classify(2000, 2000, 2000, 6000));
  TEST_ASSERT_EQUAL(core::Floor::Red, core::classify(3000, 600, 500, 4500));
  TEST_ASSERT_EQUAL(core::Floor::Green, core::classify(600, 3000, 900, 4500));
  TEST_ASSERT_EQUAL(core::Floor::Blue, core::classify(500, 1200, 3000, 4700));
  TEST_ASSERT_EQUAL(core::Floor::Yellow, core::classify(3000, 2600, 400, 6000));
}

void test_shoulder_target() {
  uint16_t t = 0;
  TEST_ASSERT_TRUE(core::shoulderTarget(2000, 45.0f, +1, 90.0f, &t));
  TEST_ASSERT_EQUAL_UINT16(2512, t);  // 45 deg = 512 steps
  TEST_ASSERT_TRUE(core::shoulderTarget(2000, 45.0f, -1, 90.0f, &t));
  TEST_ASSERT_EQUAL_UINT16(1488, t);  // the up direction decides the sign
  TEST_ASSERT_TRUE(core::shoulderTarget(2000, -45.0f, +1, 90.0f, &t));
  TEST_ASSERT_EQUAL_UINT16(1488, t);
  TEST_ASSERT_TRUE(core::shoulderTarget(2000, 90.0f, +1, 90.0f, &t));  // exactly the limit
  TEST_ASSERT_EQUAL_UINT16(3024, t);
}

void test_shoulder_next_target() {
  TEST_ASSERT_EQUAL_UINT16(2064, core::shoulderNextTarget(2000, 3000, 64));   // small step toward the goal
  TEST_ASSERT_EQUAL_UINT16(1936, core::shoulderNextTarget(2000, 1000, 64));
  TEST_ASSERT_EQUAL_UINT16(2030, core::shoulderNextTarget(2000, 2030, 64));   // never past the goal
  TEST_ASSERT_EQUAL_UINT16(2000, core::shoulderNextTarget(2000, 2000, 64));
}

void test_shoulder_reach() {
  TEST_ASSERT_TRUE(core::shoulderWithinReach(1981, 2927, 90.0f));    // up -> pick is 83 deg
  TEST_ASSERT_FALSE(core::shoulderWithinReach(1000, 2927, 90.0f));   // 169 deg in one go: refused
}

void test_shoulder_target_refused() {
  uint16_t t = 7;
  TEST_ASSERT_FALSE(core::shoulderTarget(2000, 0.0f, +1, 90.0f, &t));
  TEST_ASSERT_FALSE(core::shoulderTarget(2000, 90.1f, +1, 90.0f, &t));
  TEST_ASSERT_FALSE(core::shoulderTarget(2000, -90.1f, +1, 90.0f, &t));
  TEST_ASSERT_FALSE(core::shoulderTarget(100, -45.0f, +1, 90.0f, &t));   // would go below 0
  TEST_ASSERT_FALSE(core::shoulderTarget(4000, 45.0f, +1, 90.0f, &t));   // would pass 4095
  TEST_ASSERT_EQUAL_UINT16(7, t);
}


// ---- pick-and-place state machine
struct FakePp {
  std::string log;
  bool color = true, grip = true, clear = true, platform = true, platPos = true, platColor = true, shoulderOk = true;
  int gripAfter = 0;      // grip only succeeds from the Nth check on (1 = first)
  int checks = 0;
  bool cubeColorOk() { log += "C "; return color; }
  bool backUp(float mm) { log += mm < 100 ? "b9 " : "b13 "; return true; }
  bool clawOpen() { log += "open "; return true; }
  bool clawClose() { log += "close "; return true; }
  bool shoulderTo(core::Level l) { log += l == core::Level::Up ? "up " : l == core::Level::Pick ? "pick " : "place "; return shoulderOk; }
  bool gripOnLift = false;  // the cube only shows as held after the lift
  bool holding() { ++checks; log += "grip? "; return gripOnLift ? log.find("up ") != std::string::npos : grip && checks >= gripAfter; }
  bool frontClear() { log += "clear? "; return clear; }
  bool goToPlatform() { log += "go "; return platform; }
  bool platformPositionOk() { log += "pos? "; return platPos; }
  bool platformColorOk() { log += "pcolor? "; return platColor; }
  bool reposition() { log += "repo "; return true; }
  bool turn180() { log += "turn "; return true; }
};

void test_pickplace_full_sequence() {
  FakePp io; core::PickPlace pp; pp.run(io);
  TEST_ASSERT_EQUAL(core::PpState::Done, pp.state);
  TEST_ASSERT_EQUAL_STRING("C b9 open pick close grip? up clear? go pos? pcolor? b13 place open up turn ", io.log.c_str());
  TEST_ASSERT_FALSE(pp.carrying);
}

void test_pickplace_grip_retry_then_ok() {
  FakePp io; io.gripAfter = 5; core::PickPlace pp; pp.run(io);   // checks: 1 pick(no) 2 raised(no) -> reposition -> 3 pick(no) 4 raised(no) -> reposition -> 5 pick(yes)
  TEST_ASSERT_EQUAL(core::PpState::Done, pp.state);
  TEST_ASSERT_EQUAL_STRING("C b9 open pick close grip? up grip? repo open pick close grip? up grip? repo open pick close grip? up clear? go pos? pcolor? b13 place open up turn ", io.log.c_str());
}

void test_pickplace_grip_shows_after_lift() {
  FakePp io; io.gripOnLift = true; core::PickPlace pp; pp.run(io);   // not held at the pick height, held once lifted: no reposition, straight on
  TEST_ASSERT_EQUAL(core::PpState::Done, pp.state);
  TEST_ASSERT_EQUAL_STRING("C b9 open pick close grip? up grip? clear? go pos? pcolor? b13 place open up turn ", io.log.c_str());
}

void test_pickplace_no_grip_aborts_with_shoulder_up() {
  FakePp io; io.grip = false; core::PickPlace pp; pp.run(io);
  TEST_ASSERT_EQUAL(core::PpState::Aborted, pp.state);
  TEST_ASSERT_EQUAL(core::PpFail::NoGrip, pp.fail);
  TEST_ASSERT_FALSE(pp.carrying);
  TEST_ASSERT_TRUE(io.log.size() >= 3 && io.log.substr(io.log.size() - 3) == "up ");
}

void test_pickplace_wrong_color_never_moves() {
  FakePp io; io.color = false; core::PickPlace pp; pp.run(io);
  TEST_ASSERT_EQUAL(core::PpFail::WrongColor, pp.fail);
  TEST_ASSERT_EQUAL_STRING("C ", io.log.c_str());
}

void test_pickplace_front_blocked_keeps_cube() {
  FakePp io; io.clear = false; core::PickPlace pp; pp.run(io);
  TEST_ASSERT_EQUAL(core::PpFail::FrontBlocked, pp.fail);
  TEST_ASSERT_TRUE(pp.carrying);   // still holding the cube: the mission decides
}

void test_pickplace_wrong_platform_color_does_not_release() {
  FakePp io; io.platColor = false; core::PickPlace pp; pp.run(io);
  TEST_ASSERT_EQUAL(core::PpFail::PlatformColor, pp.fail);
  TEST_ASSERT_TRUE(io.log.find("place") == std::string::npos);
  TEST_ASSERT_TRUE(pp.carrying);
}

void test_pickplace_blocked_shoulder_gets_no_second_command() {
  FakePp io; io.shoulderOk = false; core::PickPlace pp; pp.run(io);
  TEST_ASSERT_EQUAL(core::PpFail::Shoulder, pp.fail);
  TEST_ASSERT_EQUAL_STRING("C b9 open pick ", io.log.c_str());   // blocked on the way down: nothing else commanded
}

core::CubeBelief emptyCubes() {
  core::CubeBelief c{};
  return c;
}

void test_turn_toward_headings() {
  const core::Pose p{{2, 2}, 1, 0};  // facing east
  TEST_ASSERT_EQUAL(core::Turn::Straight, core::turnToward(p, {3, 2}));
  TEST_ASSERT_EQUAL(core::Turn::Left, core::turnToward(p, {2, 3}));   // north is left of east
  TEST_ASSERT_EQUAL(core::Turn::Right, core::turnToward(p, {2, 1}));
  TEST_ASSERT_EQUAL(core::Turn::UTurn, core::turnToward(p, {1, 2}));
}

void test_move_to_updates_heading() {
  const core::Pose q = core::moveTo({{2, 2}, 1, 0}, {2, 3});
  TEST_ASSERT_EQUAL(2, q.at.c);
  TEST_ASSERT_EQUAL(3, q.at.r);
  TEST_ASSERT_EQUAL(0, q.dc);
  TEST_ASSERT_EQUAL(1, q.dr);
}

void test_no_cube_no_step() {
  core::Node n{};
  TEST_ASSERT_FALSE(core::nextTowardBestCube({{0, 0}, 1, 0}, emptyCubes(), &n));
}

void test_nearest_cube_on_street() {
  core::CubeBelief c = emptyCubes();
  c.east[2][0] = 1.0f;   // street (2,0)-(3,0): walk 2 junctions + the street = cost 3
  c.north[0][3] = 1.0f;  // street (0,3)-(0,4): cost 4
  core::Node n{};
  TEST_ASSERT_TRUE(core::nextTowardBestCube({{0, 0}, 1, 0}, c, &n));
  TEST_ASSERT_EQUAL(1, n.c);
  TEST_ASSERT_EQUAL(0, n.r);
}

void test_street_cube_is_walked_from_its_near_end() {
  core::CubeBelief c = emptyCubes();
  c.east[2][0] = 1.0f;   // street (2,0)-(3,0); the robot stands at (0,0)
  core::Node n{};
  TEST_ASSERT_TRUE(core::nextTowardBestCube({{0, 0}, 1, 0}, c, &n));
  TEST_ASSERT_EQUAL(1, n.c);
  // standing on the near end, the step is the other end of that street
  TEST_ASSERT_TRUE(core::nextTowardBestCube({{2, 0}, 1, 0}, c, &n));
  TEST_ASSERT_EQUAL(3, n.c);
  TEST_ASSERT_EQUAL(0, n.r);
}

void test_cube_on_the_next_street_steps_over_it() {
  core::CubeBelief c = emptyCubes();
  c.east[0][0] = 1.0f;   // the street leaving the robot's own junction
  core::Node n{};
  TEST_ASSERT_TRUE(core::nextTowardBestCube({{0, 0}, 1, 0}, c, &n));
  TEST_ASSERT_EQUAL(1, n.c);
  TEST_ASSERT_EQUAL(0, n.r);
}


void test_blocked_street_is_not_driven_through() {
  core::CubeBelief b;
  for (int c = 0; c < core::kMapCols; ++c) for (int r = 0; r < core::kMapRows; ++r) b.east[c][r] = b.north[c][r] = 0.0f;
  b.east[2][0] = 1.0f;   // a cube on the street (2,0)-(3,0)
  core::Blocked blk;
  core::clearBlocked(blk);
  blk.east[1][0] = true;   // but the street (1,0)-(2,0) in front of it is blocked: the shortest way is closed
  const core::Pose pose{{0, 0}, 1, 0};
  core::Node next{};
  TEST_ASSERT_TRUE(core::nextTowardBestCube(pose, b, &next, 0.3f, nullptr));
  TEST_ASSERT_EQUAL(1, next.c);
  TEST_ASSERT_EQUAL(0, next.r);   // without the block: straight ahead
  const core::Pose atOne{{1, 0}, 1, 0};   // standing right before the blocked street: it must not step into it
  TEST_ASSERT_TRUE(core::nextTowardBestCube(atOne, b, &next, 0.3f, &blk));
  TEST_ASSERT_EQUAL(1, next.c);
  TEST_ASSERT_EQUAL(1, next.r);   // around, up first
  TEST_ASSERT_TRUE(core::nextTowardBestCube(atOne, b, &next, 0.3f, nullptr));
  TEST_ASSERT_EQUAL(2, next.c);   // without the block: straight ahead
  blk.east[2][0] = true;           // the street that HOLDS the cube is blocked too: it is not a goal any more
  TEST_ASSERT_FALSE(core::nextTowardBestCube(pose, b, &next, 0.3f, &blk));
}

void test_explore_goes_to_least_visited() {
  core::Visits v;
  core::clearVisits(v);
  const core::Pose pose{{2, 2}, 1, 0};
  for (int c = 0; c < core::kMapCols; ++c) for (int r = 0; r < core::kMapRows; ++r) v.n[c][r] = 3;
  v.n[5][4] = 0;   // only the far corner was never reached
  core::Node next{};
  TEST_ASSERT_TRUE(core::stepToLeastVisited(pose, v, &next));
  TEST_ASSERT_TRUE(next.c > 2 || next.r > 2);   // a step toward it
  v.n[5][4] = 3; v.n[0][0] = 1;                 // now (0,0) is the least visited
  TEST_ASSERT_TRUE(core::stepToLeastVisited(pose, v, &next));
  TEST_ASSERT_TRUE(next.c < 2 || next.r < 2);
  core::markVisited(v, core::Node{0, 0}); core::markVisited(v, core::Node{0, 0});
  TEST_ASSERT_EQUAL(3, v.n[0][0]);
}

void test_exploration_replaces_first_street_when_nothing_likely() {
  core::CubeBelief b;
  for (int c = 0; c < core::kMapCols; ++c) for (int r = 0; r < core::kMapRows; ++r) b.east[c][r] = b.north[c][r] = 0.0f;   // nothing worth a trip
  core::Visits v;
  core::clearVisits(v);
  v.n[3][2] = 5;   // straight ahead was visited a lot
  const core::Pose pose{{2, 2}, 1, 0};
  const core::Decision d = core::decideAtCrossing(pose, b, &v);
  TEST_ASSERT_FALSE(d.toCube);
  TEST_ASSERT_FALSE(d.next.c == 3 && d.next.r == 2);   // does not just go ahead
}

void test_delivery_walks_to_column_zero_then_out_the_gate() {
  bool atGate = true;
  core::Decision d = core::decideDelivery(core::Pose{{3, 1}, 1, 0}, &atGate);   // facing east: U-turn to go west
  TEST_ASSERT_FALSE(atGate);
  TEST_ASSERT_EQUAL(2, d.next.c);
  TEST_ASSERT_TRUE(d.turn == core::Turn::UTurn);
  d = core::decideDelivery(core::Pose{{0, 1}, -1, 0}, &atGate);           // at column 0 facing west: straight out of the gate
  TEST_ASSERT_TRUE(atGate);
  TEST_ASSERT_EQUAL(-1, d.next.c);
  TEST_ASSERT_TRUE(d.turn == core::Turn::Straight);
}


void test_plan_anchors_the_column_when_only_the_column_is_unsure() {
  core::PoseBelief b;
  memset(b.p, 0, sizeof(b.p));
  b.inGreen = false;
  b.atGate = false;
  b.p[2][3][0] = 0.5f;   // row 3 for sure, column 2 or 3
  b.p[3][3][0] = 0.5f;
  core::CubeBelief cubes;
  for (int c = 0; c < core::kMapCols; ++c) for (int r = 0; r < core::kMapRows; ++r) cubes.east[c][r] = cubes.north[c][r] = 0.0f;
  const core::Plan plan = core::planAtCrossing(b, cubes);
  TEST_ASSERT_TRUE(plan.mode == core::Mode::Anchor);
  TEST_ASSERT_TRUE(plan.move.turn == core::Turn::Straight);   // heading +c (east): keep going east to the edge, not up
  b.p[2][3][0] = b.p[3][3][0] = 0.0f;
  b.p[3][2][0] = 0.5f;   // now the row is the unsure one: up
  b.p[3][4][0] = 0.5f;
  const core::Plan up = core::planAtCrossing(b, cubes);
  TEST_ASSERT_TRUE(up.mode == core::Mode::Anchor);
  TEST_ASSERT_TRUE(up.move.turn == core::Turn::Left);          // north is a left turn from east
}

// Anchoring north (the row is unsure) over a street that a cube blocks would have the robot go back to it forever (it touched the cube each time): go south to the other red border.
void test_plan_anchors_the_other_way_when_the_street_to_anchor_is_blocked() {
  core::PoseBelief b;
  memset(b.p, 0, sizeof(b.p));
  b.inGreen = false;
  b.atGate = false;
  b.p[3][2][0] = 0.5f;   // column 3 for sure, row 2 or 4
  b.p[3][4][0] = 0.5f;
  core::CubeBelief cubes;
  for (int c = 0; c < core::kMapCols; ++c) for (int r = 0; r < core::kMapRows; ++r) cubes.east[c][r] = cubes.north[c][r] = 0.0f;
  core::Blocked blocked;
  core::clearBlocked(blocked);
  const core::Plan open = core::planAtCrossing(b, cubes, core::kMinCoordBelief, nullptr, &blocked);
  TEST_ASSERT_TRUE(open.move.turn == core::Turn::Left);        // heading east: north is a left turn
  blocked.north[3][2] = true;                                  // a cube on the street above (3,2)
  const core::Plan around = core::planAtCrossing(b, cubes, core::kMinCoordBelief, nullptr, &blocked);
  TEST_ASSERT_TRUE(around.mode == core::Mode::Anchor);
  TEST_ASSERT_TRUE(around.move.turn == core::Turn::Right);     // south instead
}

void test_forget_never_raises_a_street_seen_empty() {
  const core::BeliefModel m;
  core::CubeBelief b{};
  b.east[2][2] = 0.01f;    // looked at, empty
  b.east[3][2] = 0.95f;    // looked at, a cube
  core::forget(b, 1000.0f * m.halfLifeS, m);
  TEST_ASSERT_FLOAT_WITHIN(1e-6f, 0.01f, b.east[2][2]);   // stays empty for good: nobody puts cubes back
  TEST_ASSERT_FLOAT_WITHIN(1e-3f, m.prior, b.east[3][2]); // the cube may have been taken: back to "unknown"
}

void test_exploration_goes_to_where_nobody_looked_not_to_known_empty() {
  core::CubeBelief b{};
  for (int c = 0; c < core::kMapCols; ++c) for (int r = 0; r < core::kMapRows; ++r) b.east[c][r] = b.north[c][r] = 0.01f;   // everything seen empty...
  b.east[4][3] = 0.4f;   // ...except one street nobody looked at: east of (4,3)
  core::Visits v;
  core::clearVisits(v);
  const core::Pose pose{{0, 0}, 1, 0};
  const core::Decision d = core::decideAtCrossing(pose, b, &v);
  TEST_ASSERT_TRUE(d.next.c > 0 || d.next.r > 0);   // heads toward the blank street (up and to the right; the prior 0.4 already counts as a probable cube), not back and forth
  core::Node n{};
  TEST_ASSERT_TRUE(core::stepToUnseen(pose, b, v, &n));
  b.east[4][3] = 0.01f;   // now it was seen too: nothing blank left
  TEST_ASSERT_FALSE(core::stepToUnseen(pose, b, v, &n));
  TEST_ASSERT_FALSE(core::nextTowardBestCube(pose, b, &n, core::kKnownEmpty));   // and no street worth a trip at all
}


void test_empty_streets_are_a_normal_way_unless_a_penalty_is_asked() {
  core::CubeBelief b{};
  for (int c = 0; c < core::kMapCols; ++c) for (int r = 0; r < core::kMapRows; ++r) b.east[c][r] = b.north[c][r] = 0.4f;   // everything unseen
  core::Routes plain, soft;
  b.east[0][0] = b.east[1][0] = b.east[2][0] = 0.01f;                          // the straight way east was seen empty
  core::routesFrom(core::Node{0, 0}, nullptr, nullptr, plain);
  core::routesFrom(core::Node{0, 0}, &b, nullptr, soft);                       // default: empty streets are walked like any other
  TEST_ASSERT_FLOAT_WITHIN(1e-4f, plain.dist[3][0], soft.dist[3][0]);
  TEST_ASSERT_FLOAT_WITHIN(1e-4f, 3.0f, soft.dist[3][0]);
  core::routesFrom(core::Node{0, 0}, &b, nullptr, soft, 0.35f);                // optional soft preference for unseen streets
  TEST_ASSERT_FLOAT_WITHIN(1e-4f, 3.0f + 3 * 0.35f, soft.dist[3][0]);          // costs more...
  TEST_ASSERT_TRUE(soft.dist[3][0] < 1e8f);                                    // ...but is never forbidden
}

void test_forget_returns_to_prior() {
  const core::BeliefModel m;
  core::CubeBelief b{};
  b.east[1][1] = 1.0f;
  core::forget(b, m.halfLifeS, m);                       // one half-life: (1 - prior) halves
  TEST_ASSERT_FLOAT_WITHIN(1e-4f, m.prior + (1.0f - m.prior) * 0.5f, b.east[1][1]);
  core::forget(b, 1000.0f * m.halfLifeS, m);
  TEST_ASSERT_FLOAT_WITHIN(1e-3f, m.prior, b.east[1][1]);
}

void test_observation_moves_belief_the_right_way() {
  const core::BeliefModel m;
  TEST_ASSERT_TRUE(core::updated(m.prior, true, m) > 0.8f);     // saw a cube: now likely
  TEST_ASSERT_TRUE(core::updated(m.prior, false, m) < 0.1f);    // saw none: now unlikely
  const float a = core::updated(0.5f, true, m);
  TEST_ASSERT_TRUE(core::updated(a, true, m) > a);               // two sightings beat one
  TEST_ASSERT_FLOAT_WITHIN(1e-6f, 1.0f, core::updated(1.0f, true, m));   // certainty stays certain
}

void test_observe_street_picks_the_right_slot() {
  const core::BeliefModel m;
  core::CubeBelief b{};
  core::initBelief(b, m);
  core::observeStreet(b, {3, 2}, {2, 2}, true, m);   // given in either order: street (2,2)-(3,2)
  TEST_ASSERT_TRUE(b.east[2][2] > 0.8f);
  core::observeStreet(b, {1, 1}, {1, 2}, true, m);
  TEST_ASSERT_TRUE(b.north[1][1] > 0.8f);
  TEST_ASSERT_FLOAT_WITHIN(1e-6f, m.prior, b.east[0][0]);
}

void test_unlikely_places_are_not_worth_a_trip() {
  core::CubeBelief c = emptyCubes();
  c.east[0][0] = 0.2f;   // very close but unlikely
  core::Node n{};
  TEST_ASSERT_FALSE(core::nextTowardBestCube({{0, 0}, 1, 0}, c, &n));
}

void test_likely_far_beats_unlikely_near() {
  core::CubeBelief c = emptyCubes();
  c.east[0][0] = 0.35f;  // cost 1, score 0.35
  c.north[0][1] = 0.95f; // street (0,1)-(0,2): cost 2, score 0.475
  core::Node n{};
  TEST_ASSERT_TRUE(core::nextTowardBestCube({{0, 0}, 1, 0}, c, &n));
  TEST_ASSERT_EQUAL(0, n.c);
  TEST_ASSERT_EQUAL(1, n.r);
}


void test_color_table_each_reference_is_itself() {
  for (int i = 0; i < core::NUM_CORES; ++i) {
    const core::RefCor& x = core::kCoresRef[i];
    TEST_ASSERT_EQUAL(i, core::classificarCor(x.r, x.g, x.b, x.c));
  }
}

void test_color_table_unknown_and_empty() {
  TEST_ASSERT_EQUAL(core::DESCONHECIDA, core::classificarCor(0, 0, 0, 0));
  TEST_ASSERT_EQUAL(core::DESCONHECIDA, core::classificarCor(20, 120, 20, 200));   // a pure green nobody measured
}

void test_color_table_names_keep_the_order() {
  TEST_ASSERT_EQUAL_STRING("BRANCO", core::nomeCor(core::BRANCO));
  TEST_ASSERT_EQUAL_STRING("VERMELHO", core::nomeCor(core::VERMELHO));
  TEST_ASSERT_EQUAL_STRING("DESCONHECIDA", core::nomeCor(core::DESCONHECIDA));
  TEST_ASSERT_EQUAL(0, core::BRANCO);
  TEST_ASSERT_EQUAL(1, core::PRETO);
  TEST_ASSERT_EQUAL(2, core::VERDE);
  TEST_ASSERT_EQUAL(3, core::AMARELO);
  TEST_ASSERT_EQUAL(4, core::AZUL);
  TEST_ASSERT_EQUAL(5, core::VERMELHO);
}

void test_color_filter_needs_two_equal_readings() {
  core::Cor anterior = core::DESCONHECIDA, aceita = core::BRANCO;
  aceita = core::filtrarCor(core::VERMELHO, anterior, aceita);
  TEST_ASSERT_EQUAL(core::BRANCO, aceita);                // first red: not believed yet
  aceita = core::filtrarCor(core::VERMELHO, anterior, aceita);
  TEST_ASSERT_EQUAL(core::VERMELHO, aceita);
  aceita = core::filtrarCor(core::AZUL, anterior, aceita);
  TEST_ASSERT_EQUAL(core::VERMELHO, aceita);              // a single blue does not flip it
}

void test_navigator_goes_to_a_likely_cube() {
  core::CubeBelief c = emptyCubes();
  c.east[1][0] = 0.9f;
  const core::Decision d = core::decideAtCrossing({{0, 0}, 1, 0}, c);
  TEST_ASSERT_TRUE(d.toCube);
  TEST_ASSERT_EQUAL(1, d.next.c);
  TEST_ASSERT_EQUAL(core::Turn::Straight, d.turn);
}

// Greedy: a cube we SAW (P well above the prior) beats an unvisited street next door, even when it is farther. Unknown streets (P = prior = 0.4) are only for when no cube is known.
void test_navigator_prefers_a_known_cube_to_an_unvisited_street() {
  core::CubeBelief c = emptyCubes();
  core::forEachPlace(c, [](float& p, core::Node, core::Node) { p = 0.05f; });  // everything looked at and empty ...
  c.east[3][2] = 0.4f;                                                           // ... except the unvisited street ahead (prior), which the old score (P / distance) preferred
  c.east[0][2] = 0.95f;                                                          // a cube seen on street (0,2)-(1,2), three junctions west of the robot
  const core::Decision d = core::decideAtCrossing({{3, 2}, 1, 0}, c);           // at (3,2) facing east: the unvisited street ahead is closer, but the known cube is the goal
  TEST_ASSERT_TRUE(d.toCube);
  TEST_ASSERT_EQUAL(2, d.next.c);                                                // west, toward it
  TEST_ASSERT_EQUAL(2, d.next.r);
}

void test_navigator_turns_toward_the_cube() {
  core::CubeBelief c = emptyCubes();
  c.north[0][1] = 0.9f;                                     // street (0,1)-(0,2), north of the robot, which faces east
  const core::Decision d = core::decideAtCrossing({{0, 0}, 1, 0}, c);
  TEST_ASSERT_EQUAL(core::Turn::Left, d.turn);
}

void test_navigator_falls_back_to_the_least_unlikely() {
  core::CubeBelief c = emptyCubes();
  c.east[3][0] = 0.1f;                                      // below the 0.3 bar, still the only hint
  const core::Decision d = core::decideAtCrossing({{0, 0}, 1, 0}, c);
  TEST_ASSERT_FALSE(d.toCube);
  TEST_ASSERT_EQUAL(1, d.next.c);
}

void test_navigator_explores_an_empty_map() {
  const core::Decision d = core::decideAtCrossing({{5, 2}, 1, 0}, emptyCubes());   // facing east at the east edge
  TEST_ASSERT_FALSE(d.toCube);
  TEST_ASSERT_TRUE(core::inMap(d.next.c, d.next.r));
  const core::Node here{5, 2};
  TEST_ASSERT_FALSE(d.next == here);
}

void test_yaw_bias_is_the_still_mean() {
  core::GyroBias b;
  core::addStillSample(b, 0.01f);
  core::addStillSample(b, 0.03f);
  TEST_ASSERT_FLOAT_WITHIN(1e-6f, 0.02f, b.bias());
  TEST_ASSERT_FLOAT_WITHIN(1e-6f, 0.0f, core::GyroBias{}.bias());
}

void test_yaw_integrates_a_quarter_turn() {
  // 90 deg/s for 1 s in 100 steps, with a 0.02 rad/s bias that must cancel out
  const float rate = 90.0f / core::kRadToDeg;
  float yaw = 0.0f;
  for (int i = 0; i < 100; ++i) yaw = core::integrateYaw(yaw, rate + 0.02f, 0.02f, 0.01f);
  TEST_ASSERT_FLOAT_WITHIN(0.01f, 90.0f, yaw);
  TEST_ASSERT_TRUE(core::turnReached(yaw, 90.0f - 0.1f));
  TEST_ASSERT_FALSE(core::turnReached(yaw, 91.0f));
}

void test_yaw_turn_reached_either_direction() {
  TEST_ASSERT_TRUE(core::turnReached(-90.0f, 90.0f));
  TEST_ASSERT_FALSE(core::turnReached(-89.0f, 90.0f));
}

void test_timed_turn_ignores_the_gyro() {
  const core::TurnSpec t{90.0f, false, 90.0f, 2.0f};   // 1 s at 90 deg/s
  TEST_ASSERT_EQUAL_UINT32(1000, core::timedTurnMs(t));
  TEST_ASSERT_FALSE(core::turnFinished(t, 999, 90.0f));   // yaw already there, but no MPU is trusted
  TEST_ASSERT_TRUE(core::turnFinished(t, 1000, 0.0f));
}

void test_gyro_turn_finishes_on_the_angle() {
  const core::TurnSpec t{90.0f, true, 90.0f, 2.0f};
  TEST_ASSERT_FALSE(core::turnFinished(t, 500, 60.0f));
  TEST_ASSERT_TRUE(core::turnFinished(t, 500, 90.0f));
  TEST_ASSERT_TRUE(core::turnFinished(t, 500, -91.0f));
}

void test_gyro_turn_times_out_if_the_gyro_is_dead() {
  const core::TurnSpec t{90.0f, true, 90.0f, 2.0f};    // limit 2 s
  TEST_ASSERT_FALSE(core::turnFinished(t, 1999, 0.0f));
  TEST_ASSERT_TRUE(core::turnFinished(t, 2000, 0.0f));
}

void test_loc_gate_gives_column_and_heading_not_row() {
  core::PoseBelief b;
  core::onOwnBlue(b);
  TEST_ASSERT_TRUE(b.atGate);
  TEST_ASSERT_FLOAT_WITHIN(1e-5f, 0.2f, b.p[0][3][0]);   // 5 rows, equally likely
  core::onCrossing(b);                                    // first junction is column 0
  TEST_ASSERT_FALSE(b.atGate);
  TEST_ASSERT_FLOAT_WITHIN(1e-5f, 0.2f, b.p[0][0][0]);
}

void test_loc_distance_one_street_moves_one_junction() {
  core::PoseBelief b;
  core::onOwnBlueAtRow(b, 2, 1.0f);
  core::onCrossing(b);                                    // column 0
  core::onCrossing(b, 410.0f);
  TEST_ASSERT_TRUE(b.p[1][2][0] > 0.99f);
}

void test_loc_distance_two_streets_means_a_missed_crossing() {
  core::PoseBelief b;
  core::onOwnBlueAtRow(b, 2, 1.0f);
  core::onCrossing(b);
  core::onCrossing(b, 790.0f);
  TEST_ASSERT_TRUE(b.p[2][2][0] > 0.99f);
}

void test_loc_distance_far_too_short_is_a_phantom_crossing() {
  core::PoseBelief b;
  core::onOwnBlueAtRow(b, 2, 1.0f);
  core::onCrossing(b);
  core::onCrossing(b, 150.0f);
  TEST_ASSERT_TRUE(b.p[0][2][0] > 0.99f);                 // did not move
}

void test_loc_distance_without_a_previous_crossing_uses_the_prior() {
  core::PoseBelief b;
  core::onOwnBlue(b);
  core::onCrossing(b, 9999.0f);                           // still at the gate: first junction, distance means nothing
  TEST_ASSERT_FLOAT_WITHIN(1e-5f, 0.2f, b.p[0][0][0]);
}

void test_wheel_scale_converges_on_a_long_reading() {
  float scale = 1.0f;
  for (int i = 0; i < 30; ++i) scale = core::refineWheelScale(scale, 440.0f);   // raw odometry keeps reading 440 mm per street
  TEST_ASSERT_FLOAT_WITHIN(0.01f, 400.0f / 440.0f, scale);
}

void test_wheel_scale_ignores_implausible_streets() {
  TEST_ASSERT_EQUAL_FLOAT(1.0f, core::refineWheelScale(1.0f, 800.0f));   // missed crossing
  TEST_ASSERT_EQUAL_FLOAT(1.0f, core::refineWheelScale(1.0f, 150.0f));   // phantom
}

void test_loc_gate_with_known_row_knows_the_row() {
  core::PoseBelief b;
  core::onOwnBlueAtRow(b, 2, 0.9f);   // came back through the gate lined up with row 2 (the row is far enough from its neighbours: 400 mm)
  TEST_ASSERT_TRUE(b.atGate);
  TEST_ASSERT_FLOAT_WITHIN(1e-5f, 0.9f, b.p[0][2][0]);
  TEST_ASSERT_FLOAT_WITHIN(1e-5f, 0.025f, b.p[0][0][0]);   // the rest shares the doubt equally (4 other rows)
  TEST_ASSERT_FLOAT_WITHIN(1e-5f, 1.0f, core::totalMass(b));
  core::onCrossing(b);
  TEST_ASSERT_GREATER_OR_EQUAL_FLOAT(core::kMinCoordBelief, core::rowMass(b, 2));
  TEST_ASSERT_EQUAL(2, core::estimate(b).pose.at.r);
}

void test_loc_counts_columns_along_the_street() {
  core::PoseBelief b;
  core::onOwnBlue(b);
  for (int i = 0; i < 4; ++i) core::onCrossing(b);       // gate + 3 more: column 3
  const core::Estimate e = core::estimate(b);
  TEST_ASSERT_EQUAL(3, e.pose.at.c);
  TEST_ASSERT_EQUAL(1, e.pose.dc);
}

void test_loc_running_past_the_last_column_means_we_miscounted() {
  core::PoseBelief b;
  core::onOwnBlue(b);
  for (int i = 0; i < 6; ++i) core::onCrossing(b);       // columns 0..5
  const bool ok = core::onCrossing(b);                    // a 7th crossing cannot exist
  TEST_ASSERT_FALSE(ok);                                  // collapsed: we are lost, start from nothing
  TEST_ASSERT_FLOAT_WITHIN(1e-5f, 1.0f / 120.0f, b.p[2][2][2]);
}

void test_loc_turn_rotates_the_heading() {
  core::PoseBelief b;
  core::onOwnBlue(b);
  core::onCrossing(b);
  core::onTurn(b, 1);                                     // left: now facing +r
  TEST_ASSERT_FLOAT_WITHIN(1e-5f, 0.2f, b.p[0][1][1]);
  core::onTurn(b, -1);
  TEST_ASSERT_FLOAT_WITHIN(1e-5f, 0.2f, b.p[0][1][0]);
}

void test_loc_line_end_pins_down_the_row() {
  core::PoseBelief b;
  core::onOwnBlue(b);
  core::onCrossing(b);                                    // column 0, row unknown
  core::onTurn(b, 1);                                     // facing +r
  core::onLineEnd(b);                                     // the street ended: only the top row faces outside going +r
  const core::Estimate e = core::estimate(b);
  TEST_ASSERT_EQUAL(4, e.pose.at.r);
  TEST_ASSERT_TRUE(e.confidence > 0.85f);   // 0.95 at the edge against 0.03 in the middle: ~0.89, not certainty
}

void test_loc_walking_up_then_the_end_confirms_the_count() {
  core::PoseBelief b;
  core::onOwnBlue(b);
  core::onCrossing(b);
  core::onTurn(b, 1);                                     // facing +r from some row
  core::onCrossing(b);                                    // one junction up: row >= 1
  TEST_ASSERT_FLOAT_WITHIN(1e-4f, 0.0f, b.p[0][0][1]);    // cannot still be on row 0
  core::onLineEnd(b);                                     // ...and the end now means row 4 (it was on row 3 before)
  TEST_ASSERT_EQUAL(4, core::estimate(b).pose.at.r);
}

void test_loc_red_is_only_beyond_a_vertical_edge() {
  core::PoseBelief b;
  core::onOwnBlue(b);
  core::onCrossing(b);
  core::onTurn(b, 1);
  core::onCrossing(b);
  core::onForbidden(b, core::Forbidden::Red);
  const core::Estimate e = core::estimate(b);
  TEST_ASSERT_EQUAL(4, e.pose.at.r);
  TEST_ASSERT_EQUAL(1, e.pose.dr);
}

void test_loc_other_blue_pins_the_far_column() {
  core::PoseBelief b;
  core::onOwnBlue(b);
  for (int i = 0; i < 6; ++i) core::onCrossing(b);       // column 5 (if the count is right)
  core::onForbidden(b, core::Forbidden::OtherBlue);
  TEST_ASSERT_TRUE(core::columnMass(b, 5) > 0.9f);       // the column is firm...
  TEST_ASSERT_TRUE(core::estimate(b).confidence < 0.3f); // ...the row is still any of 5 (it never showed)
  TEST_ASSERT_EQUAL(5, core::estimate(b).pose.at.c);
}

void test_loc_a_missed_crossing_is_not_fatal() {
  core::PoseBelief b;
  core::onOwnBlue(b);
  for (int i = 0; i < 5; ++i) core::onCrossing(b);       // counted column 4
  core::onForbidden(b, core::Forbidden::OtherBlue);      // but the other blue says we are at the edge: column 5 (one crossing was missed)
  TEST_ASSERT_EQUAL(5, core::estimate(b).pose.at.c);
}

void test_plan_trusts_a_known_pose() {
  core::PoseBelief loc;
  core::onOwnBlue(loc);
  core::onCrossing(loc);
  core::onTurn(loc, 1);
  core::onCrossing(loc);
  core::onLineEnd(loc);                                   // row 4 and firm enough
  core::onTurn(loc, 1);                                   // facing -c now, at the top edge: both coordinates known
  core::CubeBelief cubes = emptyCubes();
  cubes.east[0][4] = 0.9f;                                // the street just east of (0,4)
  const core::Plan p = core::planAtCrossing(loc, cubes, 0.85f);
  TEST_ASSERT_TRUE(p.mode == core::Mode::Collect);
  TEST_ASSERT_TRUE(p.move.toCube);
}

void test_plan_anchors_when_the_row_is_unknown() {
  core::PoseBelief loc;
  core::onOwnBlue(loc);
  core::onCrossing(loc);                                  // column 0, row any of 5
  core::CubeBelief cubes = emptyCubes();
  cubes.east[0][2] = 0.9f;                                // a tempting cube, but we do not know which row we are on
  const core::Plan p = core::planAtCrossing(loc, cubes);
  TEST_ASSERT_TRUE(p.mode == core::Mode::Anchor);
  TEST_ASSERT_FALSE(p.move.toCube);
  TEST_ASSERT_EQUAL(core::Turn::Left, p.move.turn);       // facing +c, the +r edge is on the left
}

void test_loc_unexpected_green_is_a_reset() {
  core::PoseBelief b;
  core::onOwnBlue(b);
  core::onCrossing(b);
  core::onCrossing(b);                                    // we think we are inside the city
  TEST_ASSERT_TRUE(core::onGreenFloor(b, false));         // ...but the floor is green: the referee moved us
  TEST_ASSERT_TRUE(b.inGreen);
  TEST_ASSERT_FLOAT_WITHIN(1e-6f, 0.0f, core::estimate(b).confidence);
  TEST_ASSERT_FALSE(core::onGreenFloor(b, false));        // already in the green: nothing new
}

void test_loc_expected_green_is_not_a_reset() {
  core::PoseBelief b;
  core::onOwnBlue(b);
  core::onCrossing(b);
  TEST_ASSERT_FALSE(core::onGreenFloor(b, true));         // leaving through the gate on a delivery trip
  TEST_ASSERT_TRUE(b.inGreen);
}

void test_loc_after_a_reset_the_gate_works_again() {
  core::PoseBelief b;
  core::onOwnBlue(b);
  for (int i = 0; i < 4; ++i) core::onCrossing(b);
  core::onGreenFloor(b, false);
  core::onCrossing(b);                                    // crossings are ignored until the blue line is read
  TEST_ASSERT_TRUE(b.inGreen);
  core::onOwnBlue(b);
  core::onCrossing(b);
  TEST_ASSERT_EQUAL(0, core::estimate(b).pose.at.c);
  TEST_ASSERT_FALSE(b.inGreen);
}

void test_plan_in_the_green_looks_for_the_blue_line() {
  core::PoseBelief loc;
  core::initInGreen(loc);
  const core::Plan p = core::planAtCrossing(loc, emptyCubes());
  TEST_ASSERT_TRUE(p.mode == core::Mode::FindBlue);
}

int main() {
  UNITY_BEGIN();
  RUN_TEST(test_turn_toward_headings);
  RUN_TEST(test_move_to_updates_heading);
  RUN_TEST(test_no_cube_no_step);
  RUN_TEST(test_nearest_cube_on_street);
  RUN_TEST(test_street_cube_is_walked_from_its_near_end);
  RUN_TEST(test_cube_on_the_next_street_steps_over_it);
  RUN_TEST(test_color_table_each_reference_is_itself);
  RUN_TEST(test_color_table_unknown_and_empty);
  RUN_TEST(test_color_table_names_keep_the_order);
  RUN_TEST(test_color_filter_needs_two_equal_readings);
  RUN_TEST(test_navigator_goes_to_a_likely_cube);
  RUN_TEST(test_navigator_prefers_a_known_cube_to_an_unvisited_street);
  RUN_TEST(test_navigator_turns_toward_the_cube);
  RUN_TEST(test_navigator_falls_back_to_the_least_unlikely);
  RUN_TEST(test_navigator_explores_an_empty_map);
  RUN_TEST(test_yaw_bias_is_the_still_mean);
  RUN_TEST(test_yaw_integrates_a_quarter_turn);
  RUN_TEST(test_yaw_turn_reached_either_direction);
  RUN_TEST(test_timed_turn_ignores_the_gyro);
  RUN_TEST(test_gyro_turn_finishes_on_the_angle);
  RUN_TEST(test_gyro_turn_times_out_if_the_gyro_is_dead);
  RUN_TEST(test_loc_gate_gives_column_and_heading_not_row);
  RUN_TEST(test_loc_distance_one_street_moves_one_junction);
  RUN_TEST(test_loc_distance_two_streets_means_a_missed_crossing);
  RUN_TEST(test_loc_distance_far_too_short_is_a_phantom_crossing);
  RUN_TEST(test_loc_distance_without_a_previous_crossing_uses_the_prior);
  RUN_TEST(test_wheel_scale_converges_on_a_long_reading);
  RUN_TEST(test_wheel_scale_ignores_implausible_streets);
  RUN_TEST(test_loc_gate_with_known_row_knows_the_row);
  RUN_TEST(test_loc_counts_columns_along_the_street);
  RUN_TEST(test_loc_running_past_the_last_column_means_we_miscounted);
  RUN_TEST(test_loc_turn_rotates_the_heading);
  RUN_TEST(test_loc_line_end_pins_down_the_row);
  RUN_TEST(test_loc_walking_up_then_the_end_confirms_the_count);
  RUN_TEST(test_loc_red_is_only_beyond_a_vertical_edge);
  RUN_TEST(test_loc_other_blue_pins_the_far_column);
  RUN_TEST(test_loc_a_missed_crossing_is_not_fatal);
  RUN_TEST(test_plan_trusts_a_known_pose);
  RUN_TEST(test_plan_anchors_when_the_row_is_unknown);
  RUN_TEST(test_loc_unexpected_green_is_a_reset);
  RUN_TEST(test_loc_expected_green_is_not_a_reset);
  RUN_TEST(test_loc_after_a_reset_the_gate_works_again);
  RUN_TEST(test_plan_in_the_green_looks_for_the_blue_line);
  RUN_TEST(test_blocked_street_is_not_driven_through);
  RUN_TEST(test_explore_goes_to_least_visited);
  RUN_TEST(test_exploration_replaces_first_street_when_nothing_likely);
  RUN_TEST(test_delivery_walks_to_column_zero_then_out_the_gate);
  RUN_TEST(test_plan_anchors_the_column_when_only_the_column_is_unsure);
  RUN_TEST(test_plan_anchors_the_other_way_when_the_street_to_anchor_is_blocked);
  RUN_TEST(test_forget_never_raises_a_street_seen_empty);
  RUN_TEST(test_exploration_goes_to_where_nobody_looked_not_to_known_empty);
  RUN_TEST(test_empty_streets_are_a_normal_way_unless_a_penalty_is_asked);
  RUN_TEST(test_forget_returns_to_prior);
  RUN_TEST(test_observation_moves_belief_the_right_way);
  RUN_TEST(test_observe_street_picks_the_right_slot);
  RUN_TEST(test_unlikely_places_are_not_worth_a_trip);
  RUN_TEST(test_likely_far_beats_unlikely_near);
  RUN_TEST(test_line_centered);
  RUN_TEST(test_line_left_is_negative);
  RUN_TEST(test_line_between_two_sensors);
  RUN_TEST(test_line_lost_and_junction);
  RUN_TEST(test_pid_sign_and_clamp);
  RUN_TEST(test_pid_no_integral_when_ki_zero);
  RUN_TEST(test_pid_derivative_filter_tames_a_step);
  RUN_TEST(test_routes_from_outside_the_map_is_all_unreachable);
  RUN_TEST(test_first_step_to_unreachable_target_stays_put);
  RUN_TEST(test_color_table_rejects_ambiguous_dim_colours);
  RUN_TEST(test_wrap_delta);
  RUN_TEST(test_spin_counts);
  RUN_TEST(test_color_classes);
  RUN_TEST(test_shoulder_target);
  RUN_TEST(test_shoulder_next_target);
  RUN_TEST(test_shoulder_reach);
  RUN_TEST(test_pickplace_full_sequence);
  RUN_TEST(test_pickplace_grip_retry_then_ok);
  RUN_TEST(test_pickplace_grip_shows_after_lift);
  RUN_TEST(test_pickplace_no_grip_aborts_with_shoulder_up);
  RUN_TEST(test_pickplace_wrong_color_never_moves);
  RUN_TEST(test_pickplace_front_blocked_keeps_cube);
  RUN_TEST(test_pickplace_wrong_platform_color_does_not_release);
  RUN_TEST(test_pickplace_blocked_shoulder_gets_no_second_command);
  RUN_TEST(test_shoulder_target_refused);
  return UNITY_END();
}
