jhlr/robo-challenge/firmware/test/bench/scan/main.cpp

// Bench: pings every STS id 0..253 (3 tries each) and prints how many answered, then repeats. Finds wrong/duplicate ids and a flaky bus. Moves nothing.
#include <Arduino.h>

#include <SCServo.h>

#include "pins.h"

SMS_STS sms_sts;

void setup() {
  Serial.begin(115200);
  Serial1.begin(1000000, SERIAL_8N1, pins::kStsRx, pins::kStsTx);
  sms_sts.pSerial = &Serial1;
  delay(1000);
}

void loop() {
  Serial.println("--- scan ids 0..253, 3 pings each ---");
  for (int id = 0; id <= 253; id++) {
    int ok = 0;
    for (int k = 0; k < 3; k++) {
      if (sms_sts.Ping(id) == id) ok++;
      delay(5);
    }
    if (ok > 0) Serial.printf("id %d: %d/3\n", id, ok);
  }
  Serial.println("--- done ---");
  delay(500);
}
