jhlr/robo-challenge/(commit log)

2026-10-27 Projeto do robo: firmware, braco, garra, chassi, simulador e docs
    [BASE.stl, BASE_e_SUPORTE_LAPIS.stl, ELO_1.stl, ELO_2.stl, Esboço30_furo_mais_10mm.dxf, MONT_PE10_com_suporte.stl, SUPORTE_LAPIS.stl, back.dxf]
2026-10-27 seguidor_linha: codigo original do colega (RC, sem PID)
2026-10-27 seguidor_linha: corrige rodopio ao perder a linha e otimiza a leitura dos sensores
2026-10-27 Reorganiza o repo: cad/ (braco, chassi, modelo_robo), arquivo/, seguidor dentro de firmware/; corrige caminhos
    [BASE.stl, BASE_e_SUPORTE_LAPIS.stl, ELO_1.stl, ELO_2.stl, Esboço30_furo_mais_10mm.dxf, MONT_PE10_com_suporte.stl, SUPORTE_LAPIS.stl, back.dxf]
2026-10-27 Renomeia arquivo/ para old/
    [BASE.stl, BASE_e_SUPORTE_LAPIS.stl, ELO_1.stl, ELO_2.stl, MONT_PE10_com_suporte.stl, SUPORTE_LAPIS.stl, base_mg996r_direto_standalone.dxf, braco_mdf.scad]
2026-10-28 SeguidorRC: seguidor de linha vira biblioteca Arduino (sensores, decisao, ponte H), busca em giro + espiral ate achar a linha
2026-10-28 Seguidor com mapa, crenca de cubos e localizacao (logica pura) + confirmacao de cruzamento girando
    core/: grafo 6x5 das ruas e busca do melhor cubo (map.h), mapa probabilistico de cubos nas arestas com esquecimento e Bayes (belief.h), filtro de histograma de localizacao com ancoras de borda (localizer.h), decisao no cruzamento com confianca (navigator.h), curva por tempo ou giroscopio (turn.h, yaw.h), cruzamento (crossing.h) e cor por tabela na ordem do Rafael (color_table.h). 54 testes no PC.
    SeguidorRC: cruzamento.h (8 sensores no preto, 2 leituras, janela de saida) com teste no PC; SeguidorBasico passa a girar 90 graus no eixo ao achar um cruzamento e confere se os 8 acendem de novo, sen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
2026-10-28 Simulador do carrinho no PC: cinematica diferencial, barra de 8 sensores, cenarios de reta, curva, lacuna, cruzamento e busca
2026-10-28 Confirmacao de cruzamento sem depender da largura da linha: gira 90 graus e ve se ha rua dos dois lados; simulador atualizado
2026-10-28 Borda do mapa pela cor da linha (vermelho/azul): meia-volta, ou espera o navegador com cubo; simulador e sketch
2026-10-28 Decisao: zona morta unica (normalizar), correcao mais forte; simulador com placar e varredura de parametros
2026-10-28 Decisao: curva fechada (3+ acesos de um lado gira sem avancar) e avanco mais lento entre giros; testes
2026-10-28 MPU: rumo ancorado na grade, levantado/reposicionado, travado, colisao, lacuna segurando o rumo, calibracao dos motores; portao azul; busca com trechos retos; tabuleiro inteiro no simulador
2026-10-28 Duas pontas acesas acima de todas as regras: varredura de 90 graus pelo lado menos explorado (historico + padrao), maquina de estados na biblioteca
2026-10-28 Busca: so a primeira volta gira uma volta inteira, velocidade rapida calibrada pelo MPU; simulador sem limite de tempo, animacao da busca so com a busca
2026-10-28 Visualizacao: botoes de avancar/voltar (sem slider nem tempo total), sem circulo de achou; busca continua andando na linha 8 s depois de achar
2026-10-29 Memoria fiel: ultrassom so conta cubo da rua NESTA esquina (ruaMm 230), so observa quando sabe onde esta, meia-volta libera o cruzamento do beco; sensores frente por faixa lateral
2026-10-29 Simulador: regras (cores, plataformas, capacidade 2, branco identificado), dois robos iguais com colisao que reinicia, calibracao da velocidade pelos cruzamentos, mais ruidos sinalizados, limites da 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
2026-10-29 Linha vermelha (e azul fora do portao) nunca e rota: para e da meia-volta na hora, no simulador e no sketch; cenario do vermelho a 45 graus
2026-10-29 1 cubo por viagem e entrega pela bussola; memoria: vazio e vazio para sempre, explora o nao visto; observa as plataformas no inicio e mede a velocidade entre molduras; reset aleatorio no verde; eco e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
    [alvo.h, belief.h, explore.h, navigator.h, simulador.cpp, test_core.cpp, teste_alvo.cpp]
2026-10-29 Calibracao pos-reset (5 primeiros cruzamentos), linha de entrada conhecida pela moldura, ultrassom alcanca varias ruas (ruaDoEco), rua vazia e caminho normal (so nao e alvo), cubo no caminho de quem 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
    [alvo.h, explore.h, giro_cruzamento.h, map.h, navigator.h, simulador.cpp, test_core.cpp, teste_alvo.cpp]
2026-10-29 Nao gira no cruzamento com pose segura; eco ao longo de varias ruas vira memoria e objetivo (varredura e andando); regras no README
2026-10-29 Vermelho: duas leituras seguidas (leitura errada isolada nao da meia-volta), TCS a cada 30 ms; depois de entregar volta pelo y da plataforma, sem subir de novo ate a moldura
2026-10-29 Cubos no meio da rua, varre sempre (o giro real nao esbarrava), calibracao pos-reset = ir ate o vermelho contando cruzamentos, desvio quando carrega e a rua do oeste esta bloqueada, protecao de indice
    [simulador.cpp]
2026-10-29 Depuracao por Bluetooth LE (Nordic UART) no sketch: comandos e telemetria; portao azul atravessado de lado; cenario de explorar o outro lado
2026-10-29 Ruido de assimetria fixa dos motores; vermelho exige duas leituras seguidas
    [simulador.cpp]
2026-10-29 Plataformas em pe (50 x 160 mm), passo de 260 mm, desenho girado so com o nome da cor; observacao volta ao mesmo x
2026-10-29 Plataformas percebidas pelo ultrassom nos primeiros cruzamentos: vai em linha reta, le a cor e volta; ultrassom ve plataformas
2026-10-29 Sem eco de lado/logo apos curva nao prova rua vazia (cone estreito, eixo fora da linha); 1o eco lido na hora depois de virar
2026-10-29 Varredura de um lado so ao entregar (uma rua basta para confirmar); entrega primeiro: procura a plataforma da cor, velocidade medida na subida; teste da varredura de um lado
2026-10-29 Plataformas centradas (4, passo 260): identificacao diagonal pelo ultrassom + pitagoras; eco perto sempre para e identifica; varredura completa quando precisa ver
2026-10-29 Colisao: os dois voltam ao verde; reentrada pelo portao nao e engolida pela janela da saida anterior
2026-10-29 Guloso: cubo ja visto antes de rua nao visitada; plataformas centradas: busca diagonal com ultrassom, rumo reancorado na plataforma; atravessa a faixa azul em frente; entrada por linha do meio
2026-10-29 Simulador em lote (--lote/--lote-ruido); olhar adiante apos curva; entrada compensa partida; ancorar vai a outra moldura quando a rua esta bloqueada (nucleo)
2026-10-29 Cubo perto do cruzamento: depois da meia-volta replaneja no cruzamento (acabava girando entre dois cubos); andado so enquanto avanca
2026-10-29 Mapa de rua de 40 cm; plataformas por varredura parada do ultrassom; memoria do eco de cubo (toques 2,0 -> 0,2); varredura so para a rua nao medida
2026-10-29 Carregando: rua bloqueada e a que vai usar de fato; rota pelas ruas livres ate a coluna 0; ancorar anda uma coluna ao leste com cubos nos dois sentidos; plataforma encaixada na grade de 130 mm
2026-10-29 Volta ao portao com a linha conhecida (core::onOwnBlueAtRow): pose segura na entrada, 266 -> 207 s; doc da rodada de otimizacao
2026-10-29 Reentrada: compensacao de partida de 40 para 20 mm (entrava abaixo da rua); 27/30 -> 29/30, 207 -> 174 s
2026-10-29 Ruido pela metade (kEscalaRuido) e chaves SIM_SEM_RUIDO/SIM_SEM_ASSIM; doc: so a assimetria dos motores derruba o carro
2026-10-29 Assimetria dos motores: giroscopio em reta mede e o lado fraco ganha forca (ponte_h::definirCompensacao); ruido pela metade 0/30 -> 19/30
2026-10-29 Doc: troca para 3x STS3215 com Waveshare Bus Servo Adapter (A); protocolo conferido, lacuna do EEPROM lock
2026-10-29 Troca o driver proprio do STS pela SCServo oficial (vendored em lib/SCServo); beginStsBus unico; ID pelo ProgramEprom oficial
2026-10-29 Doc: esquematico do adaptador confirma jumper A = UART e fios diretos (TX->TXD)
2026-10-29 Doc: servos 1 e 2 respondem (cabo ruim + fiacao do esquematico); falta o id 3 do ombro
2026-10-29 CAD: bandeja do ESP32 DevKit (topo aberto, entalhe USB, 2 abas M3) em cad/esp32_caixa
    [esp32_caixa.scad, esp32_caixa.stl]
2026-10-29 CAD: aba de retencao no meio da parede oposta ao USB (bandeja do ESP32)
    [esp32_caixa.scad, esp32_caixa.stl]
2026-10-29 CAD: aba de retencao maior (14 x 3,5 mm, 1,6 de espessura)
    [esp32_caixa.scad, esp32_caixa.stl]
2026-10-30 Doc: SLAM simples aplicado ao seguidor (odometria, marcos de cruzamento, estado na linha)
2026-10-30 Localizador: cruzamento com distancia da odometria (1 rua, perdido, fantasma) e auto-calibracao da escala da roda
2026-10-30 SeguidorRC: porta para tracao STS (hal::StsDrive), odometria entre cruzamentos no localizador, env seguidor
2026-10-30 I2C pelo PCA9548 (RGB frente 0, chao 1, MPU 2), trig 14/echo 12; sketch do seguidor usa o hal para MPU, cor e ultrassom
2026-10-30 Pinos reposicionados (barra 14,27,26,25,33,32,35,34; I2C 21/23; sonar 18/19), barra RC le GPIO32-39, venv do bleak
2026-10-30 env seguidor_manual: upload sem reset automatico (BOOT+EN na mao) para a placa do carrinho
2026-10-30 Barra RC: nao tenta carregar pinos so de entrada (GPIO34-39), acaba o spam de erros na serial
2026-10-30 env rapido: seguidor minimo P+D para o carrinho (STS, barra RC sem S7/S8, console e OTA por BLE)
2026-10-30 rapido: ping dos STS no boot e comandos ping/giro para diagnosticar rodas
2026-10-30 console_ble: reconecta quando o robo cai (reset/brownout) em vez de morrer com BleakError
2026-10-31 Periféricos em bibliotecas oficiais: QTRSensors (QRE-8D), NewPing, TCA9548, ESP32Servo
2026-10-31 Barra QRE-8D: S1..S8 em 13,4,14,27,26,25,33,32 (todos com saida, S7/S8 voltam a funcionar no RC)
2026-10-31 pins: garra (kClaw) no GPIO22, livre de colisao com o sonar
2026-10-31 CAD: bandeja do ESP32 menor (parede/piso 1,5, folga 0,15, abas 8 x 6, aba de retencao 2,5): 57,3 x 43,9 x 8,5 mm
    [esp32_caixa.scad, esp32_caixa.stl]
2026-10-31 CAD: bandeja do ESP32 para placa medida 47 x 25 mm
    [esp32_caixa.scad, esp32_caixa.stl]
2026-10-31 STS: janela de tensao na EEPROM (max 14,0 V, min 4,0 V) garantida no StsDrive::begin; limite de fabrica de 8 V acusava erro de tensao e piscava o LED a 12 V
2026-10-31 sensores_rc: calibracao le calibrationOff (QTRReadMode::Off nao aloca calibrationOn): corrige LoadProhibited no boot do seguidor
    [sensores_rc.cpp]
2026-10-31 OTA BLE: pausa entre pacotes de dados (--pausa); env rapido_manual para upload USB sem reset
2026-10-31 Barra RC sem calibracao: limiar fixo (BarraRC::limiarUs, provisorio 1000 us) no lugar dos 5 s de deslize; remove a sonda STS_SONDA
    [SeguidorBasico.ino, main.cpp, sensores_rc.cpp, sensores_rc.h]
2026-10-31 Env giro: bancada, as duas rodas STS para frente sem parar (reenvia a cada 100 ms)
2026-11-02 Firmware: fix pin clash, turn timeout, PID derivative, shoulder, EEPROM wear, map bounds, colour ambiguity
    - buzzer/LED off line-sensor pins (GPIO5 / on-board GPIO2; DC car has no LED)
    - follow: turns use core/turn.h with a timeout, gyro bias at boot, IMU result checked
    - Pid: derivative low-pass (dTau), no integral when ki=0; first dt fixed
    - DcDrive owns its mm/s estimate (min-duty remap)
    - shoulderRotate returns true only on arrival; shoulderBegin writes EEPROM only when needed
    - map: routesFrom/firstStepTo safe for out-of-map start and unreachable targets
    - colour table rejects ambiguous readings; scale-mismatch warning in color.h
    - tests for pid, map bounds, colour ambiguity
    [color.h, color_table.h, drive.cpp, drive.h, main.cpp, map.h, params.h, pid.h]
2026-11-03 pins: SDA do mux I2C no GPIO22 (fiacao real; antes 21)
2026-11-03 Env sensores: sonar, RGB frente/chao e MPU em tempo real, scan I2C no boot, retenta o que falhou
2026-11-03 Simulador: modo encoder (odometro das rodas, sem zona morta/assimetria, freada por distancia, y pelo giro com ultrassom); padrao inalterado
2026-11-03 Simulador encoder: y pelas bordas do eco, correcao a partir de 4 mm, giro freia a tempo; sem ruido 28/30 (empata com o padrao)
2026-11-03 Simulador encoder: rodadinha de 45 graus no cruzamento (gesto=), varredura continua do y; doc com perfil de tempo e ruido
2026-11-03 Simulador encoder: yPeloGiro ajusta a inclinacao da face e reancora o rumo derivado (>10 graus); sem ruido 29/30, 199 s
2026-11-03 Simulador: modo --coleta N (tempo para entregar N cubos sem ruido, teto de 12 min)
2026-11-03 Cruzamento: debounce tambem por odometro e faixa de saida nao conta como chegada (pose nao avanca sem o carro sair do lugar); param cap= no simulador
2026-11-03 Simulador: aproximacao da plataforma de 260 mm (150 parava antes do alcance e gastava ~10 s varrendo)
2026-11-03 Simulador: rumoenc=1 (rumo pelos encoders, sem MPU) e bitolaaj= (bitola que o firmware supoe)
2026-11-03 Simulador sem MPU: giro de rua fechado na linha (pivota no centro, meio da faixa, rumo na grade); autocal opcional; doc
2026-11-03 Bancada bitola: mede a bitola efetiva girando >1 volta sobre o centro de um cruzamento (mesma rua 2x = 360 graus); validado no simulador (--bitola)
2026-11-03 Hardware sem MPU e sem mux: 2 TCS34725 em dois barramentos I2C (Wire 21/22, Wire1 23/15); hal::Imu e PCA9548 removidos; benches e exemplo atualizados
2026-11-04 Sonar sem biblioteca (pulseIn + velocidade do som), TRIG 15/ECHO 23; sensores no chao em Wire 21/22 e frente em Wire1 18/19; NewPing removida
2026-11-04 Navegacao do simulador extraida para seguidor/robo.h (template sobre o Carro) + tabuleiro.h; simulador usa o mesmo codigo, resultados identicos (125 linhas de cenarios, lote 28/30, coleta 14-15/18); 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
2026-11-04 Carro real roda a logica do simulador (env robo): CarroReal sobre hal/, rumo pelos encoders, nao anda ao ligar (g/x); StsDrive expoe o percurso de cada roda; doc
2026-11-04 Roda: circunferencia medida de 21 cm (diametro 66,85 mm)
2026-11-04 Bitola: 185 mm (medida entre os centros das rodas)
2026-11-04 Doc: numeros do simulador no modo do carro STS (parametros antes de --lote)
2026-11-06 Garra STS3215: engrenagem (setor m1,5 z35) com 4 pinos no disco de 20 mm
    [engrenagem_sts.scad, engrenagem_sts.stl]
2026-11-06 Ombro direto no STS3215: barra com pivo alargado e 4 furos M3 no disco (d_bar sts), parametros do disco em sts3215.scad, garra reaproveita
    [bar_sts.dxf, braco_mdf.scad, engrenagem_sts.scad, engrenagem_sts.stl, sts3215.scad]
2026-11-06 claw_rot.scad inclui params_gen (sem avisos ao usar de fora)
    [claw_rot.scad, engrenagem_sts.stl]
2026-11-06 Ombro STS3215 direto: quadros duplos com janela fechada + tampo, barra com pivo alargado e 4 M3 no disco, SG90/MG996R 4:1 arquivado, chapa do ombro regenerada, doc
    [bar.dxf, bar_sts.dxf, base.dxf, braco.scad, braco_mdf.scad, ombro_direto.scad, ombro_reducao.scad, ombro_sts.scad]
2026-11-06 Ombro STS3215: torres com base alargada e 3 pes, tampo das torres, escora servo-torre, 3 furos de conves a mais, 2 furos de espacador nos quadros do servo; chapas regeneradas; doc
    [base.dxf, braco_mdf.scad, sheet_ombro_1.dxf, sheet_ombro_1.scad, sheet_torres_1.dxf, sheet_torres_1.scad, stsbrace.dxf, stsframe.dxf]
2026-11-06 Cenas view_ombro e view_ligacao (estrutura do ombro sem barras / so a ligacao servo-torre) e imagens
    [braco_mdf.scad]
2026-11-06 Ombro STS3215: torre -x e quadro da frente viram uma placa so (servo dentro da torre), fundo com recorte do pivo, tampo das torres abaixo das barras, chapas regeneradas, doc
    [back.dxf, base.dxf, braco_mdf.scad, sheet_ombro_1.dxf, sheet_ombro_1.scad, sheet_torres_1.dxf, sheet_torres_1.scad, tower.dxf]
2026-11-06 Cena view_encaixe: barra real do ombro com furos e parafusos sobre o disco do STS3215 (montado e explodido), doc
    [braco_mdf.scad]
2026-11-06 Chapa do ombro agora inclui torre +x, fundo e tampo das torres (3 pecas ja cortadas ficam so no grupo torres)
    [sheet_ombro_1.dxf, sheet_ombro_1.scad, sheet_torres_1.dxf, sheet_torres_1.scad]
2026-11-06 Fundo (back) em chapa propria (grupo fundo); chapa do ombro sem ele
    [sheet_fundo_1.dxf, sheet_fundo_1.scad, sheet_ombro_1.dxf, sheet_ombro_1.scad]
2026-11-06 Fundo: recorte do eixo do servo ate x = -6 (cabeca do parafuso, disco e barra passam folgados)
    [back.dxf, braco_mdf.scad, sheet_fundo_1.dxf]
2026-11-06 Bancada: env tensao (janela de tensao 4,0-14,0 V gravada por broadcast em todos os STS, so com 'v' na serial)
2026-11-06 Bancada: mover testa os ids 1..3 em sequencia (tenta o ping varias vezes por causa de id duplicado)
2026-11-06 Bancada: tensao configura 1 STS novo sozinho no barramento (janela de tensao e id 3); scan varre ids 0..253
2026-11-09 Bancada: env ombro_delta (gira o ombro STS 45 graus por delta da posicao atual, em passos com checagem de corrente)
2026-11-09 Fluxo de pegar cubo e alturas do ombro (topo 1981, pegar 2927, plataforma 2567)
2026-11-09 Maquina de estados de pegar e colocar cubo (core/pickplace.h) com testes; docs atualizado
2026-11-09 Pickplace: sem pegada levanta, confere, reposiciona, desce e tenta de novo; docs: guardar o cubo primeiro
2026-11-09 Limpeza: remove pecas da reducao 4:1, folhas antigas, sketches ping/mover/giro e mount impresso; sketches de bancada vao para firmware/test/bench
    [braco.scad, cheek.dxf, claw_bar_bin.stl, claw_carrier_bin.stl, claw_frame_bin.stl, claw_jaw_l_bin.stl, claw_jaw_r_bin.stl, claw_mount.stl]
2026-11-09 Docs: README do firmware, README raiz e avisos de desatualizado nos docs antigos
